ryanstevensmith/SR-Kicad-lib/README.md

# SR-Kicad-lib
 Smith Robotics Kicad Libraries

 Open for use by anyone, but note I am doing it for my own projects and to my own speciication. Parts mostly have not been reviewed externally so use at your own risk. But let's face it, they are probably mostly right.

**Currently at v0.0.2**
