ryanstevensmith/SR-Kicad-lib/3D/LED/ASMT-YTB7-0AA02.STEP

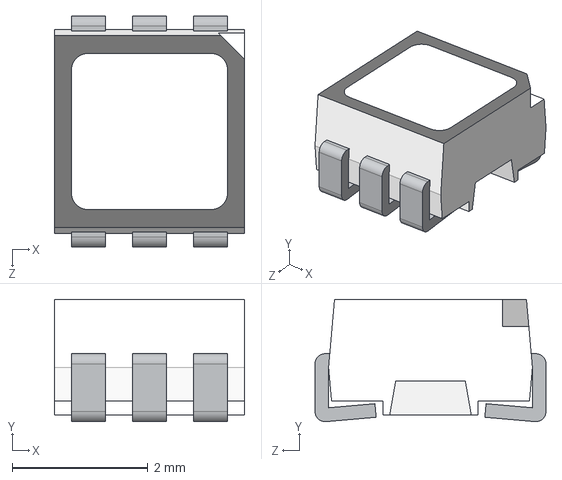
[picture p2: CAD file, 2024-06-04]
3D/LED/ASMT-YTB7-0AA02.STEP
2.80 x 1.80 x 3.40 mm
