ryanstevensmith/SR-Kicad-lib/3D/Battery/MYOUNG-MY-1220-03.step

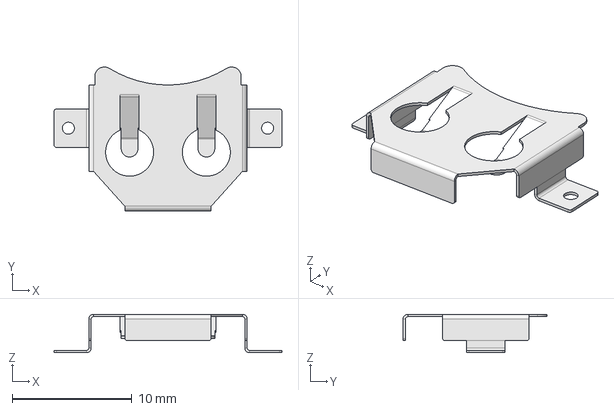
[picture p3: CAD file, 2026-04-07]
3D/Battery/MYOUNG-MY-1220-03.step
19.0 x 12.0 x 3.20 mm
