ryanstevensmith/SR-Kicad-lib/3D/Button_Switch/RB141C1100.STEP

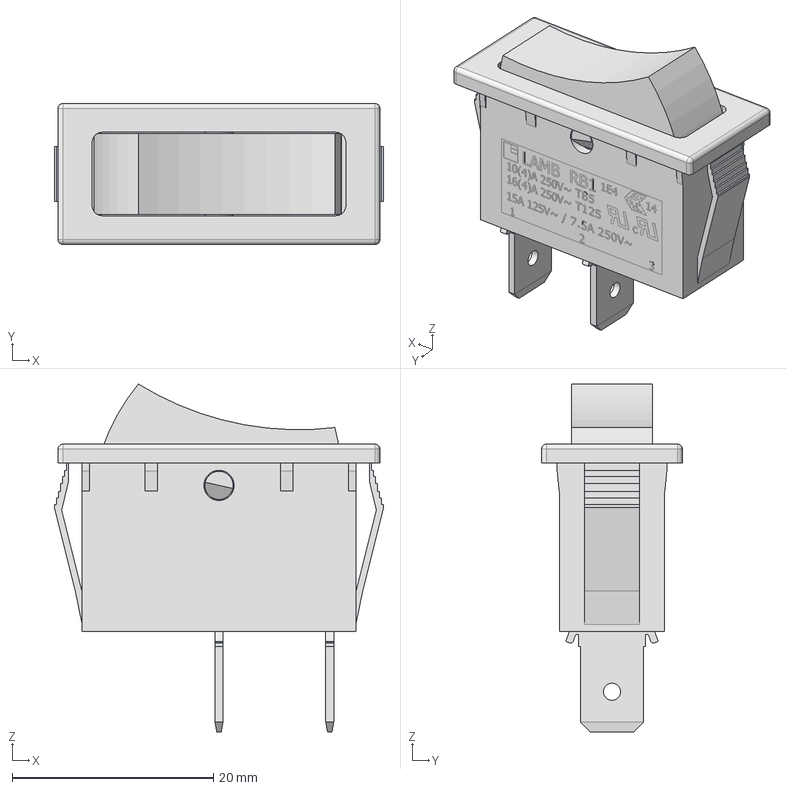
[picture p4: CAD file, 2026-04-07]
3D/Button_Switch/RB141C1100.STEP
32.7 x 14.0 x 34.6 mm
