ryanstevensmith/SR-Kicad-lib/3D/Converter_ACDC/HLK-PM01.step

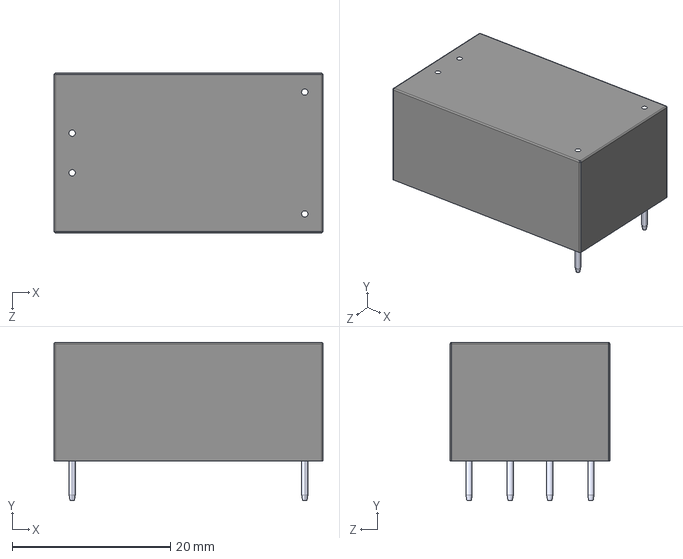
[picture p5: CAD file, 2026-04-07]
3D/Converter_ACDC/HLK-PM01.step
34.0 x 20.0 x 20.2 mm
