ryanstevensmith/SR-Kicad-lib/3D/Converter_DCDC/TEL_10-4811.step

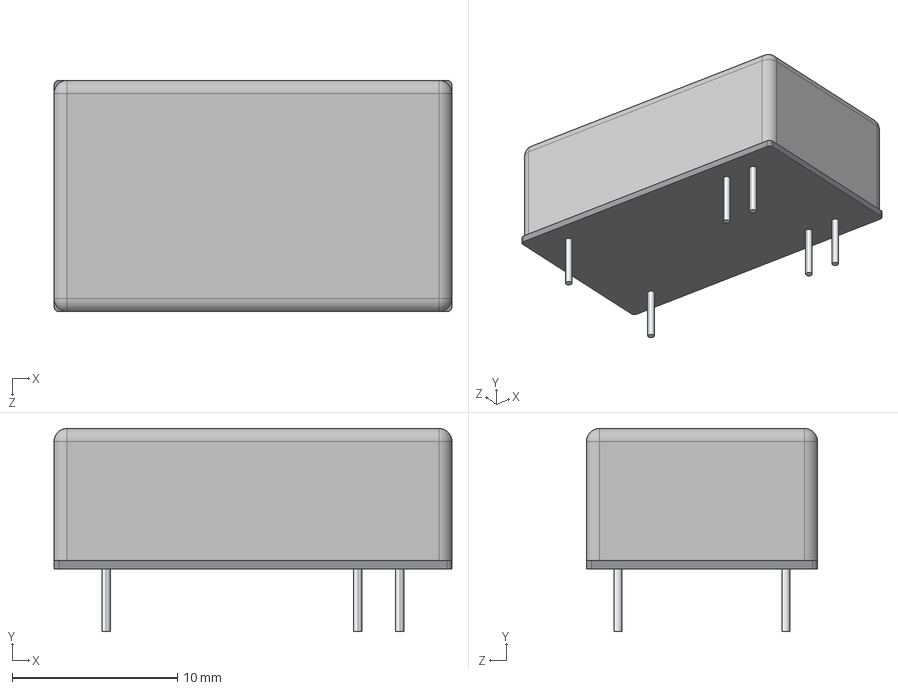
[picture p6: CAD file, 2023-04-03]
3D/Converter_DCDC/TEL_10-4811.step
24.1 x 12.3 x 14.0 mm
tel10-base
tel10wi-cover
tel10wi-pin x 6
