ryanstevensmith/SR-Kicad-lib/3D/Crystal/crystal_rtf2012.stp

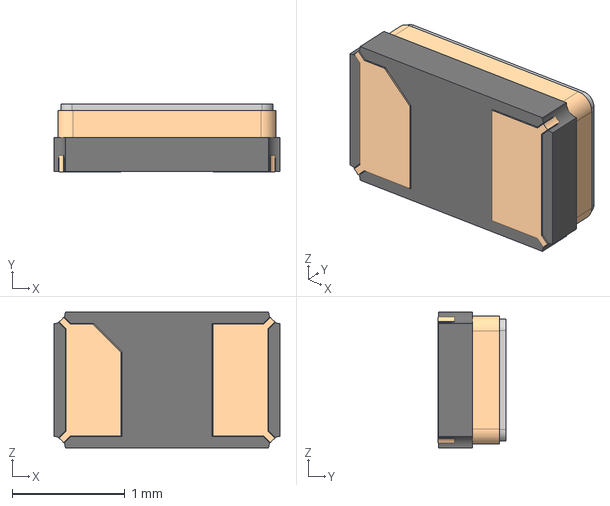
[picture p7: CAD file, 2026-04-07]
3D/Crystal/crystal_rtf2012.stp
2.00 x 0.606 x 1.20 mm
