ryanstevensmith/SR-Kicad-lib/3D/Diode/UCLAMP2671P.TNT.step

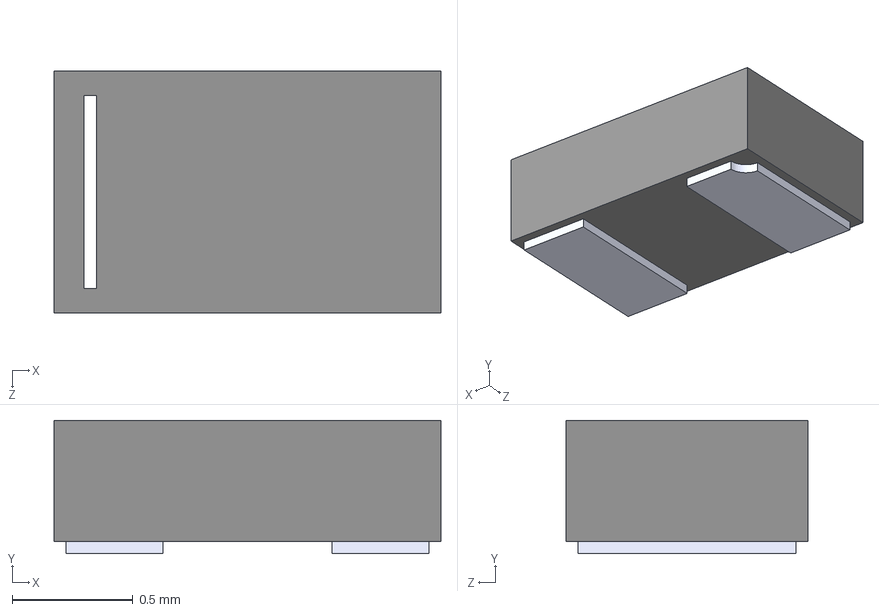
[picture p8: CAD file, 2026-04-07]
3D/Diode/UCLAMP2671P.TNT.step
1.60 x 0.55 x 1.00 mm
