ryanstevensmith/SR-Kicad-lib/3D/Fuse/Littelfuse 0154.500DRT.step

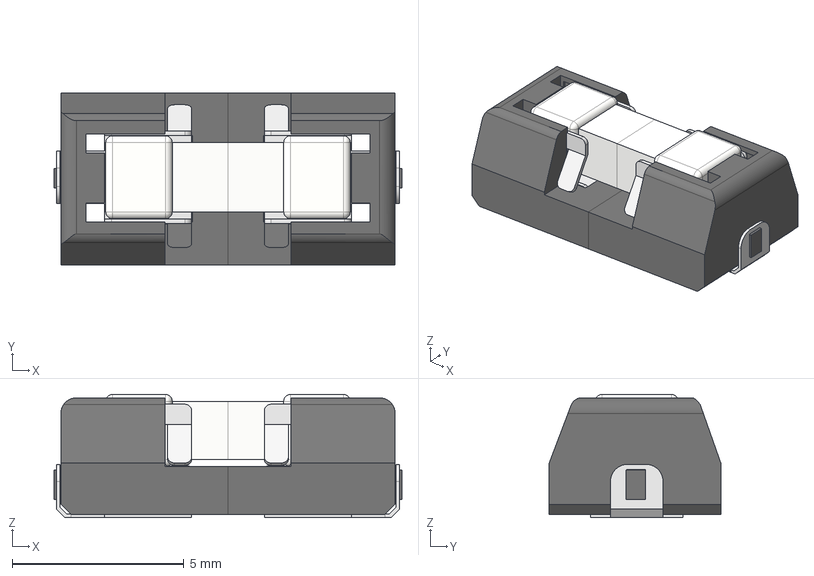
[picture p9: CAD file, 2023-04-03]
3D/Fuse/Littelfuse 0154.500DRT.step
10.1 x 5.00 x 3.59 mm
Komponente1
Komponente2
Komponente3
Komponente4
