ryanstevensmith/SR-Kicad-lib/3D/GPS/SAM-M8Q.STEP

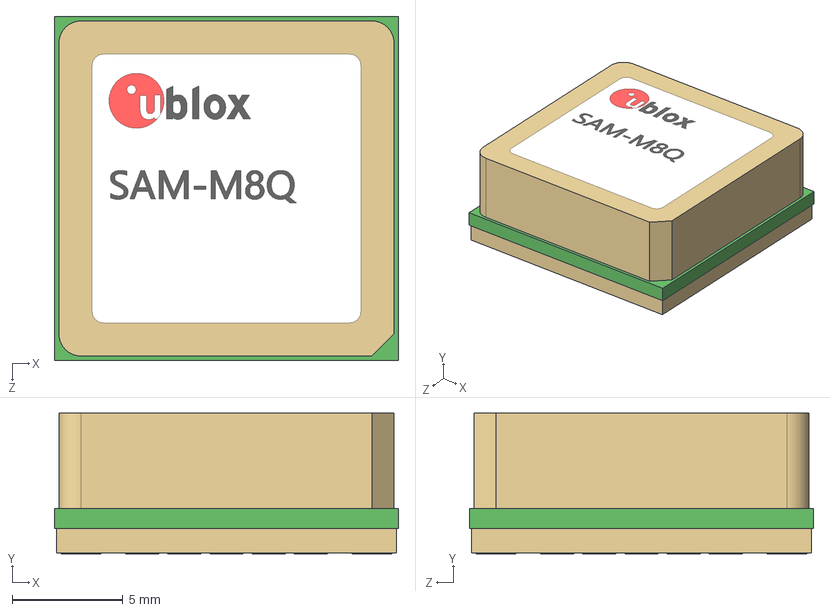
[picture p10: CAD file, 2024-06-04]
3D/GPS/SAM-M8Q.STEP
15.5 x 6.35 x 15.5 mm
