ryanstevensmith/SR-Kicad-lib/3D/GSM/SARA-R4.step

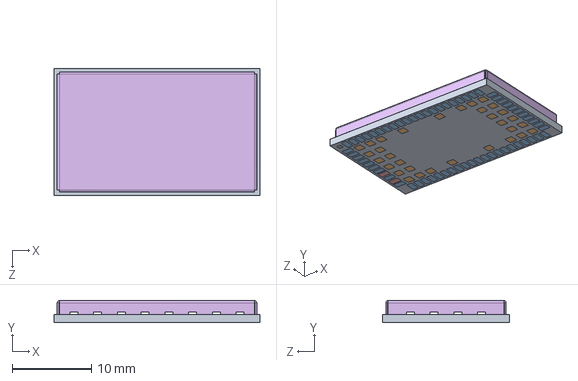
[picture p11: CAD file, 2023-04-03]
3D/GSM/SARA-R4.step
26.0 x 2.78 x 16.0 mm
