ryanstevensmith/SR-Kicad-lib/3D/Inductor/IHLP-2020.stp

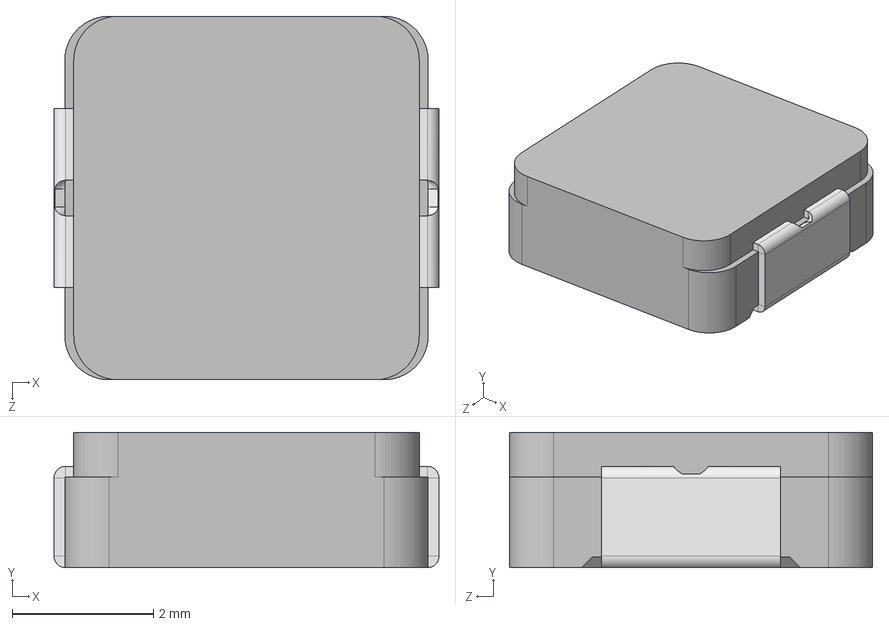
[picture p12: CAD file, 2026-04-07]
3D/Inductor/IHLP-2020.stp
5.45 x 1.92 x 5.15 mm
