ryanstevensmith/SR-Kicad-lib/3D/LED/LED_SK6812MINI-E.step

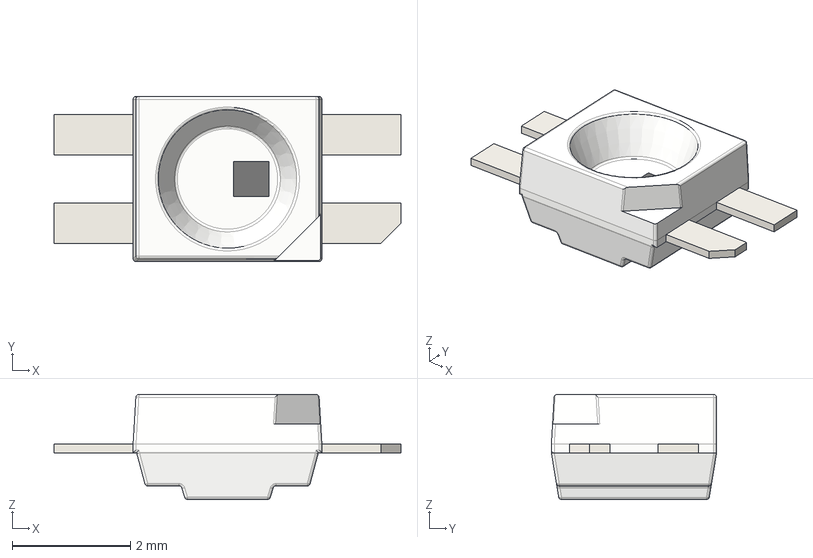
[picture p13: CAD file, 2026-04-07]
3D/LED/LED_SK6812MINI-E.step
5.88 x 2.80 x 1.78 mm
