ryanstevensmith/SR-Kicad-lib/3D/Modules/FIT0982-Thin-Heatsink.step

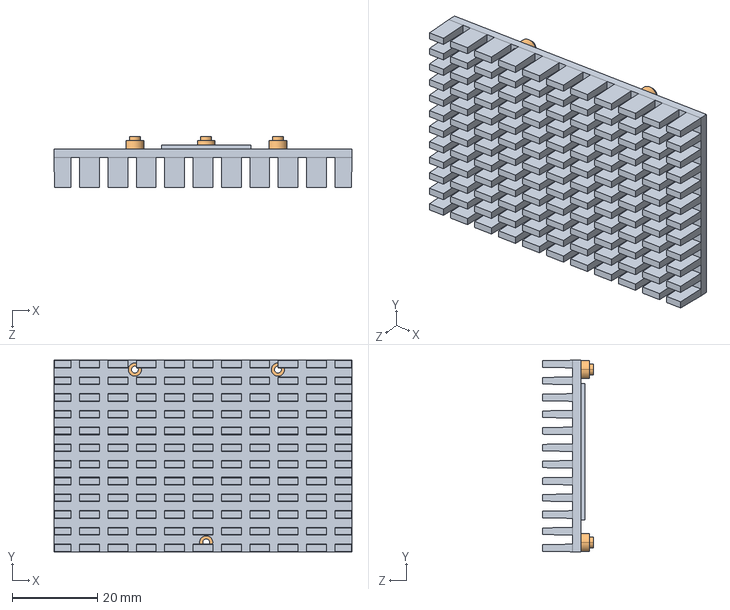
[picture p14: CAD file, 2026-04-07]
3D/Modules/FIT0982-Thin-Heatsink.step
70.0 x 45.0 x 12.0 mm
