ryanstevensmith/SR-Kicad-lib/3D/Package_BGA/DSBGA8-YBG_TEX.step

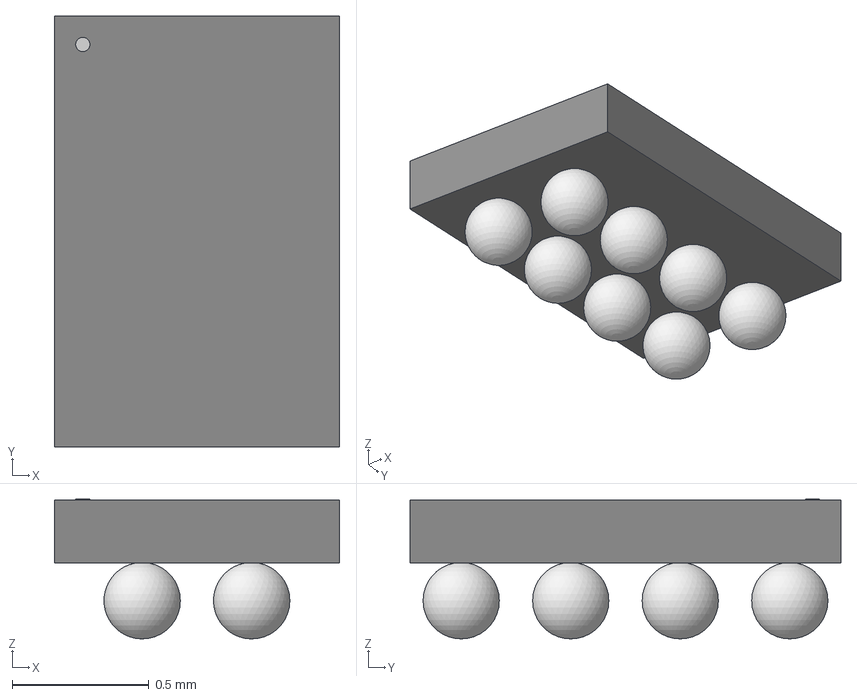
[picture p15: CAD file, 2024-06-04]
3D/Package_BGA/DSBGA8-YBG_TEX.step
1.04 x 1.57 x 0.511 mm
