ryanstevensmith/SR-Kicad-lib/3D/Package_DFN_QFN/ST-DFN-8(2x3).step

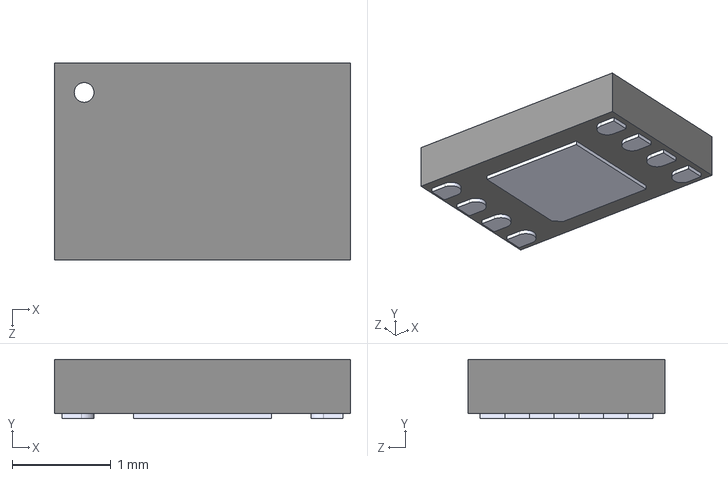
[picture p16: CAD file, 2026-04-07]
3D/Package_DFN_QFN/ST-DFN-8(2x3).step
3.00 x 0.6 x 2.00 mm
