ryanstevensmith/SR-Kicad-lib/3D/Package_LGA/ST_LGA-12_2x2.step

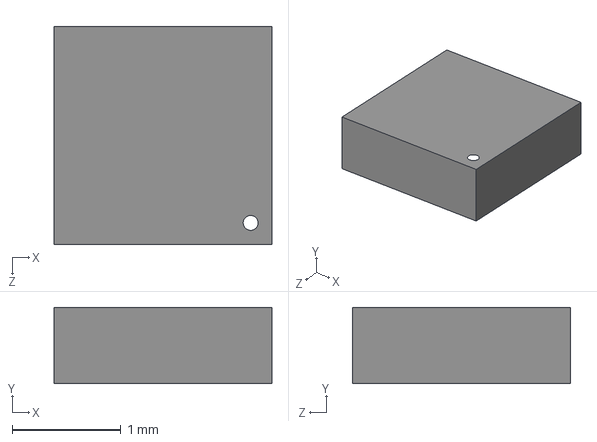
[picture p17: CAD file, 2024-06-04]
3D/Package_LGA/ST_LGA-12_2x2.step
2.00 x 0.7 x 2.00 mm
