ryanstevensmith/SR-Kicad-lib/3D/Package_SiP/MICROSIP8_SIU_TEX.step

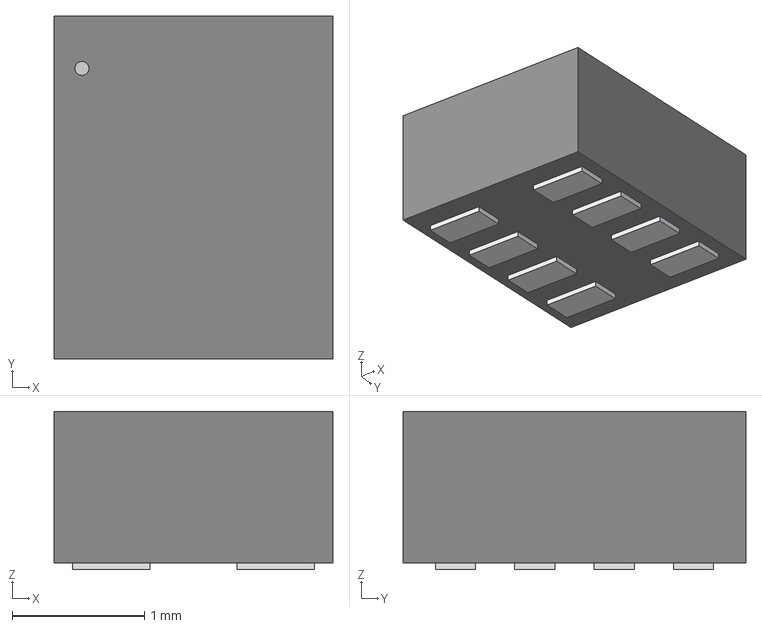
[picture p18: CAD file, 2024-06-04]
3D/Package_SiP/MICROSIP8_SIU_TEX.step
2.11 x 2.59 x 1.20 mm
