ryanstevensmith/SR-Kicad-lib/3D/Package_SO/TSSOP-16 5_1x4_4.STEP

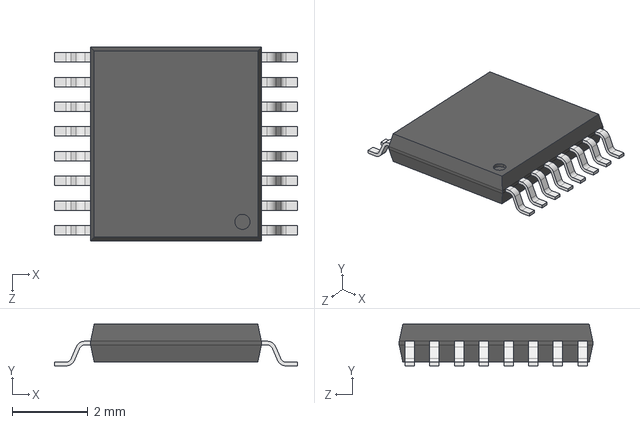
[picture p19: CAD file, 2023-04-03]
3D/Package_SO/TSSOP-16 5_1x4_4.STEP
6.40 x 1.10 x 5.10 mm
pin_TSSOP_tssop_1 x 16
body_TSSOP_TSSOP_5.1x4.5_1
