ryanstevensmith/SR-Kicad-lib/3D/Package_SON/Texas_DPY0002A_X1SON-2.STEP

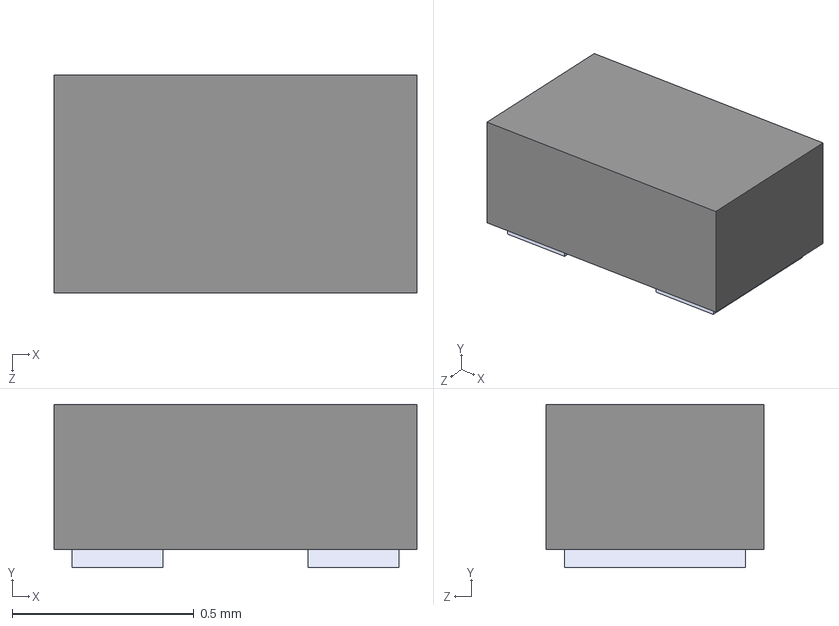
[picture p20: CAD file, 2026-04-07]
3D/Package_SON/Texas_DPY0002A_X1SON-2.STEP
1.00 x 0.45 x 0.6 mm
