ryanstevensmith/SR-Kicad-lib/3D/Package_SOT/TO-39.step

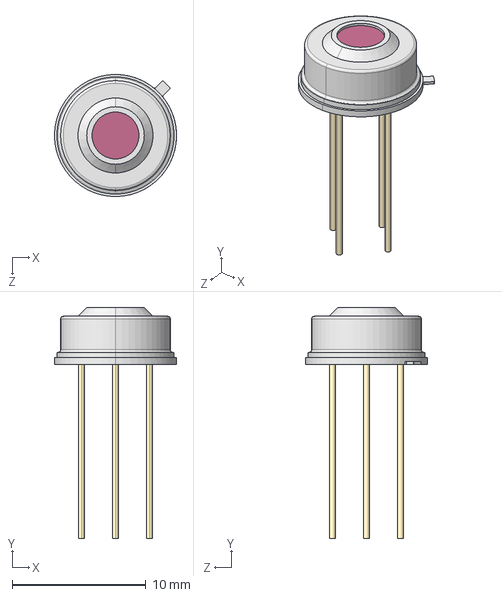
[picture p21: CAD file, 2024-06-04]
3D/Package_SOT/TO-39.step
9.12 x 17.2 x 9.12 mm
