ryanstevensmith/SR-Kicad-lib/3D/Rotary_Encoder/PEC11R-4x15F-Nxxxx.step

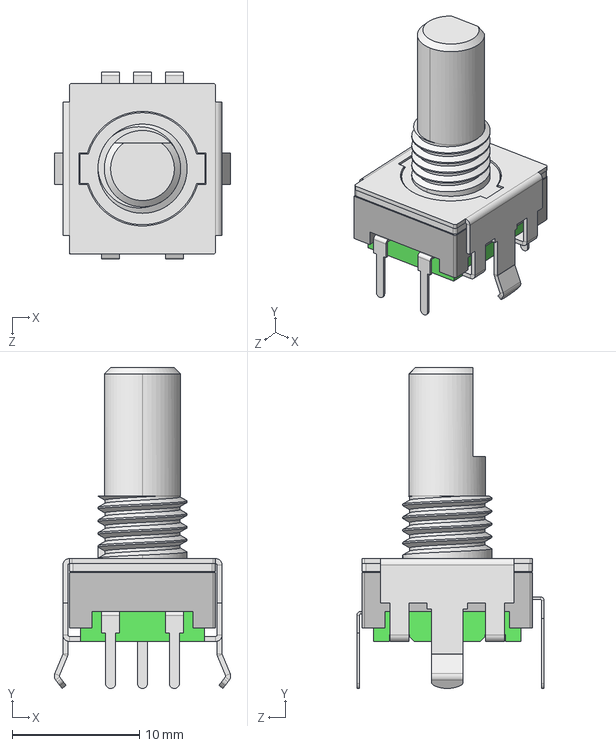
[picture p23: CAD file, 2023-08-29]
3D/Rotary_Encoder/PEC11R-4x15F-Nxxxx.step
13.9 x 25.2 x 14.7 mm
