ryanstevensmith/SR-Kicad-lib/3D/Sensor_Audio/SPV0142LR5H.step

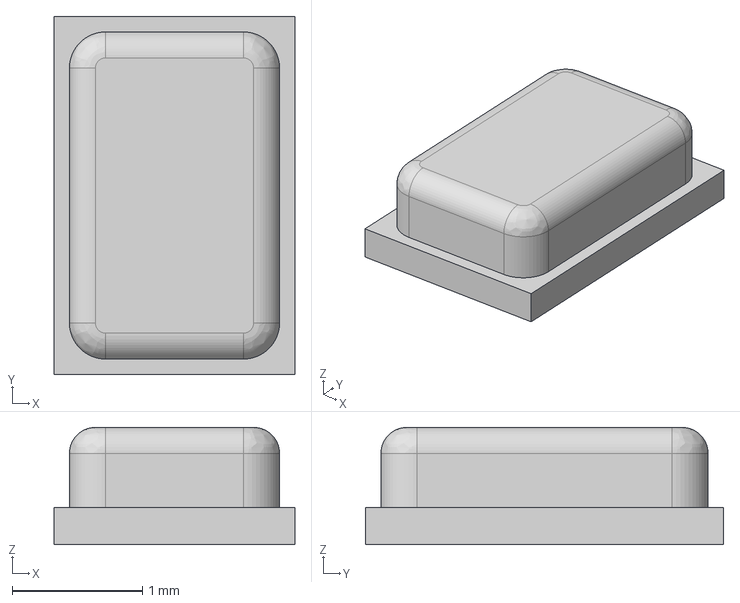
[picture p24: CAD file, 2026-04-07]
3D/Sensor_Audio/SPV0142LR5H.step
1.85 x 2.75 x 0.9 mm
