ryanstevensmith/SR-Kicad-lib/3D/Sensor_Gas/AHT20.step

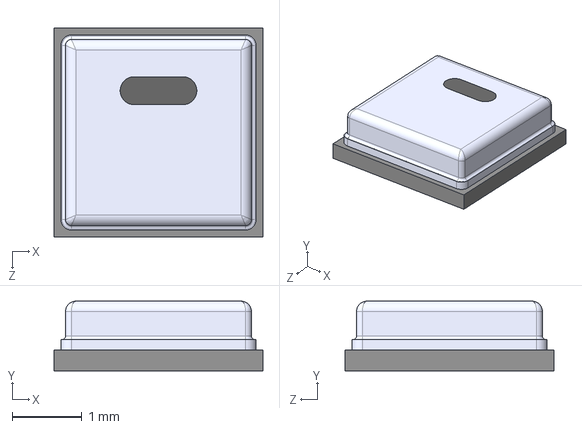
[picture p25: CAD file, 2026-04-07]
3D/Sensor_Gas/AHT20.step
3.00 x 1.00 x 3.00 mm
