ryanstevensmith/SR-Kicad-lib/3D/Sensor_Opto/BH1750FVI-TR.step

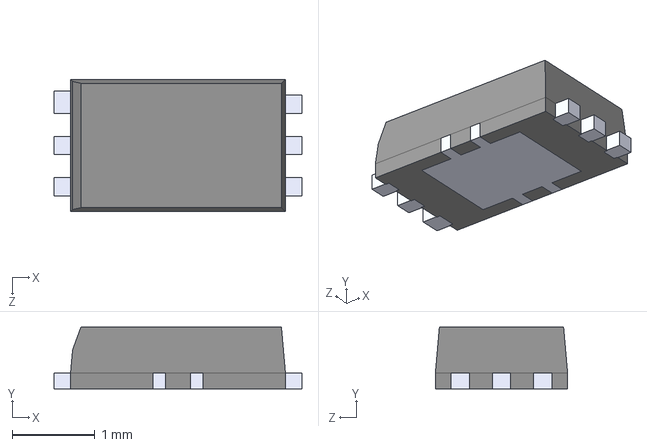
[picture p26: CAD file, 2026-04-07]
3D/Sensor_Opto/BH1750FVI-TR.step
3.00 x 0.75 x 1.60 mm
