ryanstevensmith/SR-Kicad-lib/3D/Solar_Cell/KXOB25-02X8F-TR.step

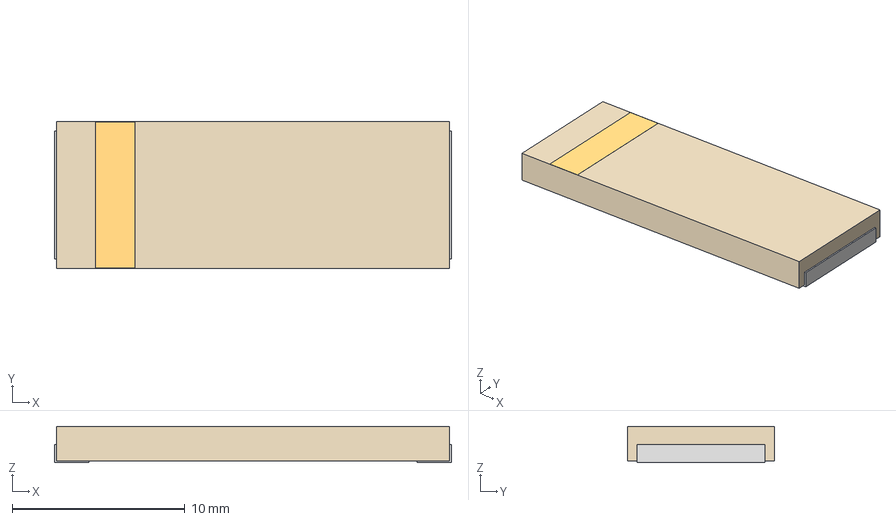
[picture p27: CAD file, 2023-08-29]
3D/Solar_Cell/KXOB25-02X8F-TR.step
23.0 x 8.51 x 2.11 mm
