ryanstevensmith/SR-Kicad-lib/3D/Button_Switch/sk-3296s-01-l3.step

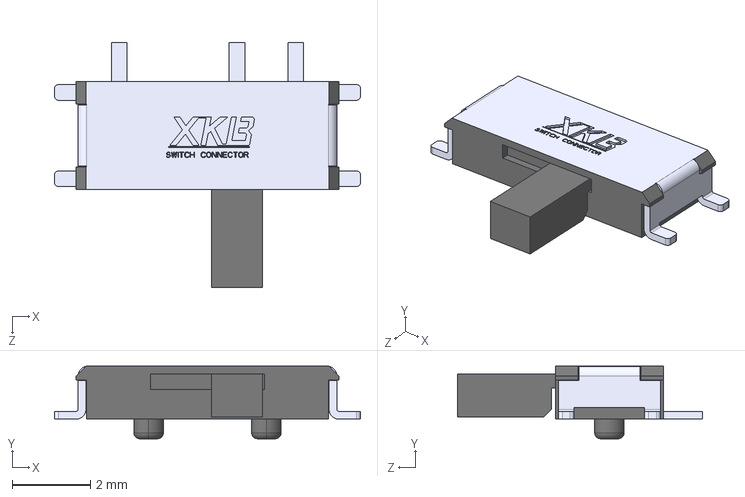
[picture p28: CAD file, 2026-04-07]
3D/Button_Switch/sk-3296s-01-l3.step
7.80 x 1.85 x 6.25 mm
