ryanstevensmith/SR-Kicad-lib/3D/Connectors/UE27-BC54-130.step

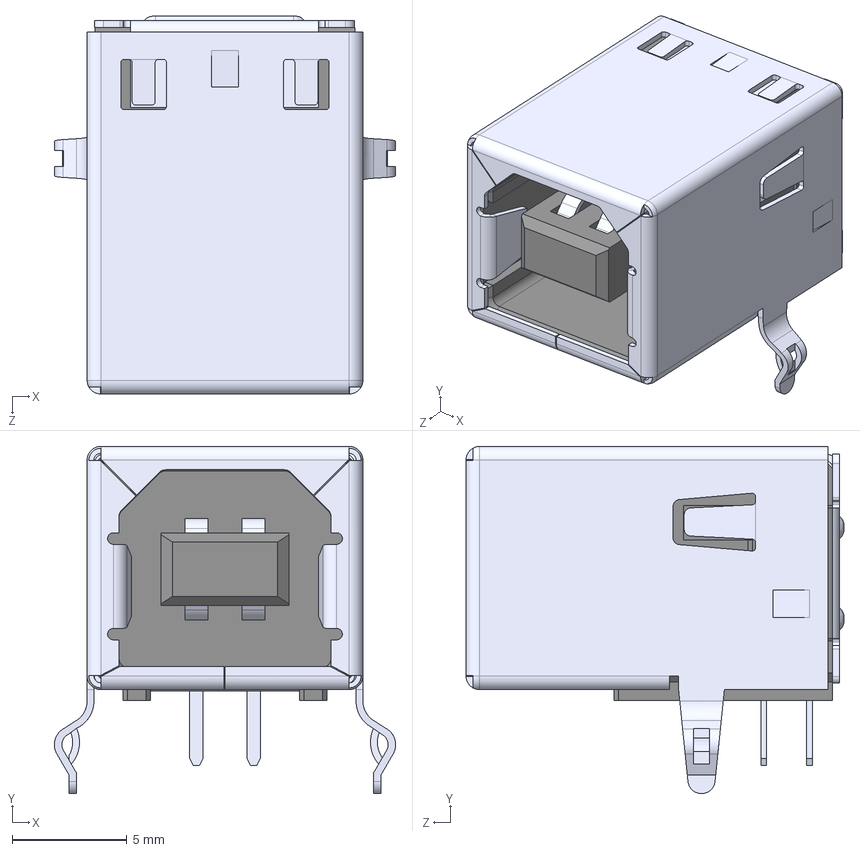
[picture p29: CAD file, 2026-04-07]
3D/Connectors/UE27-BC54-130.step
14.9 x 15.2 x 16.5 mm
