ryanstevensmith/SR-Kicad-lib/3D/Converter_DCDC/IZB03.STEP

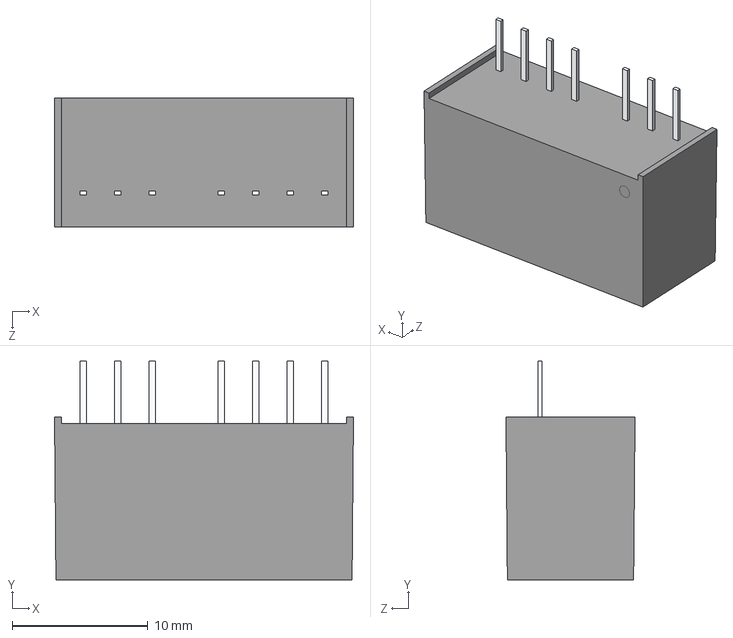
[picture p30: CAD file, 2023-04-03]
3D/Converter_DCDC/IZB03.STEP
22.0 x 16.1 x 9.50 mm
PIN_3_1_1_1 x 7
