ryanstevensmith/SR-Kicad-lib/3D/Crystal/Crystal SC32S no markings.stp

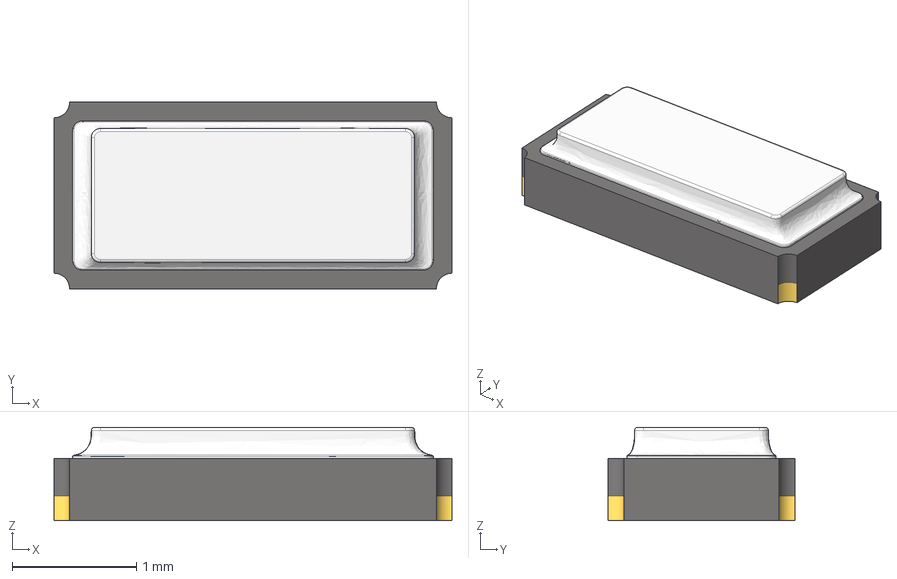
[picture p31: CAD file, 2023-08-29]
3D/Crystal/Crystal SC32S no markings.stp
3.20 x 1.50 x 0.75 mm
