ryanstevensmith/SR-Kicad-lib/3D/Diode/TUMD2M.step

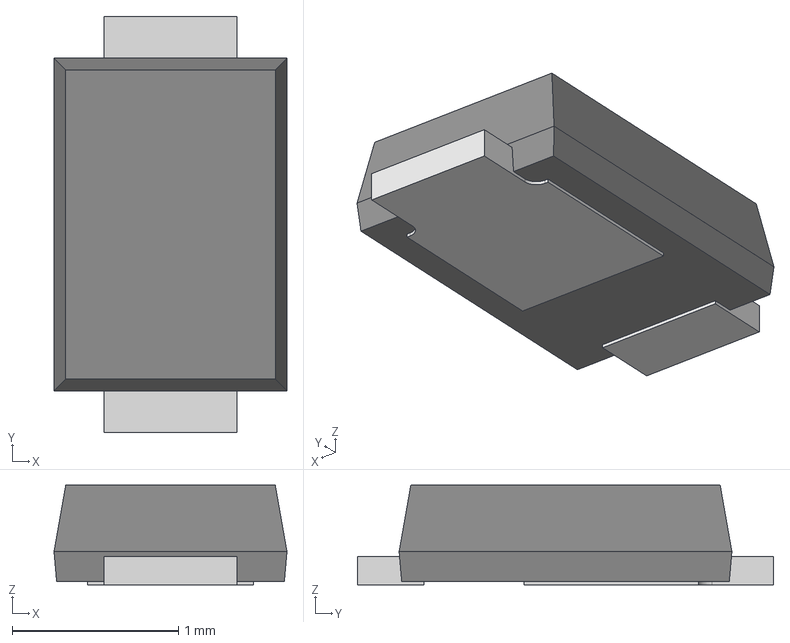
[picture p32: CAD file, 2023-08-29]
3D/Diode/TUMD2M.step
1.40 x 2.50 x 0.6 mm
3D_Model_TUMD2M_Rev0-prt0
3D_Model_TUMD2M_Rev0-prt1
3D_Model_TUMD2M_Rev0-prt2
3D_Model_TUMD2M_Rev0-prt3
