ryanstevensmith/SR-Kicad-lib/3D/GPS/ublox_MAX.STEP

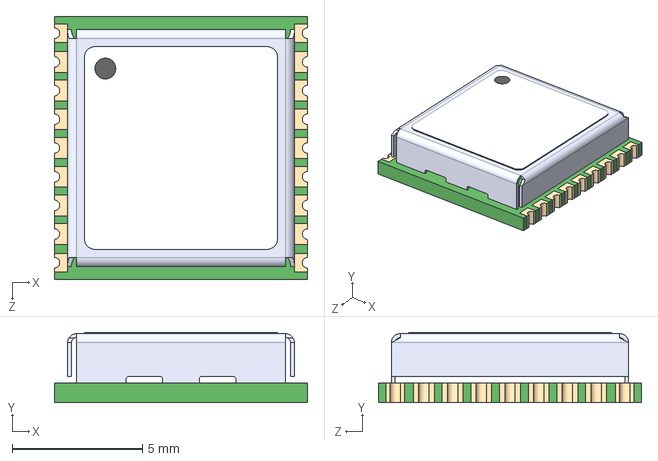
[picture p33: CAD file, 2023-08-29]
3D/GPS/ublox_MAX.STEP
9.70 x 2.70 x 10.1 mm
