ryanstevensmith/SR-Kicad-lib/3D/GSM/SIM800C.step

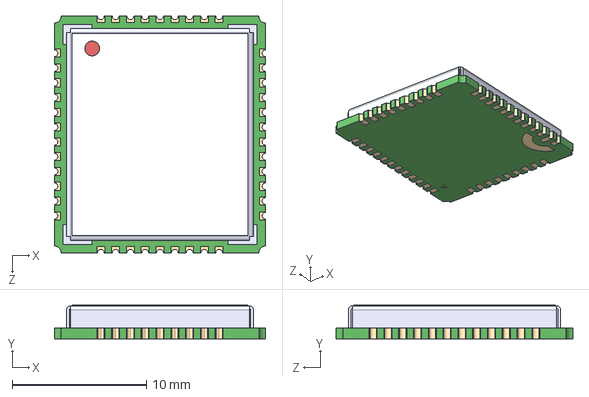
[picture p34: CAD file, 2023-04-03]
3D/GSM/SIM800C.step
15.7 x 2.50 x 17.6 mm
