ryanstevensmith/SR-Kicad-lib/3D/LED/XZxxxx45S-9.step

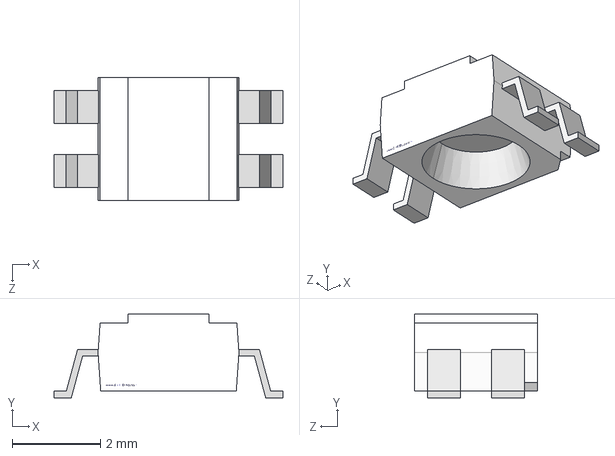
[picture p35: CAD file, 2026-04-07]
3D/LED/XZxxxx45S-9.step
5.20 x 1.90 x 2.80 mm
