ryanstevensmith/SR-Kicad-lib/3D/Modules/FIT0989-Fanless-Heatsink.step

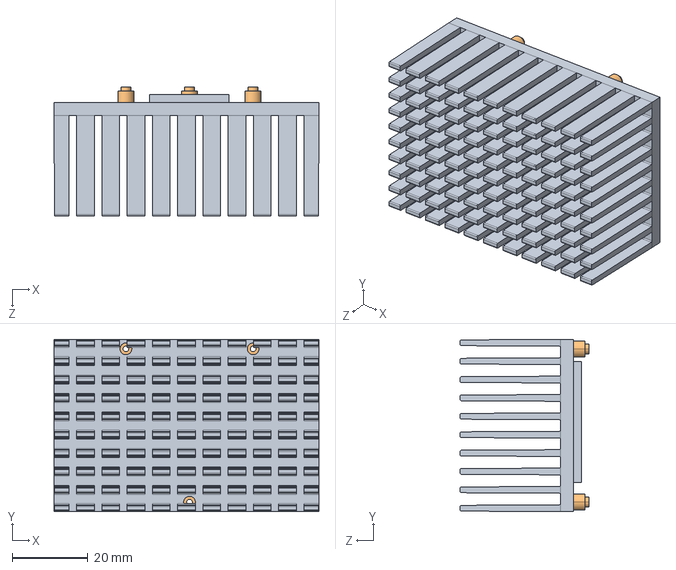
[picture p36: CAD file, 2026-04-07]
3D/Modules/FIT0989-Fanless-Heatsink.step
70.0 x 45.5 x 34.0 mm
