ryanstevensmith/SR-Kicad-lib/3D/Package_BGA/YZF0009-C01.stp

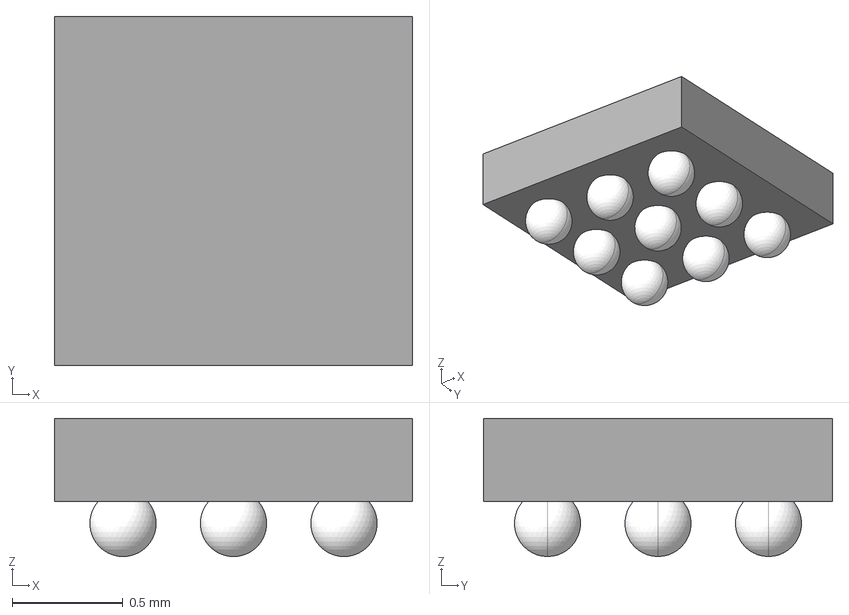
[picture p37: CAD file, 2024-06-04]
3D/Package_BGA/YZF0009-C01.stp
1.62 x 1.58 x 0.625 mm
SOLDER_BALL x 9
PIN1_AREA
