ryanstevensmith/SR-Kicad-lib/3D/Package_DFN_QFN/Texas_RDX0007A_QFN-FCMOD.step

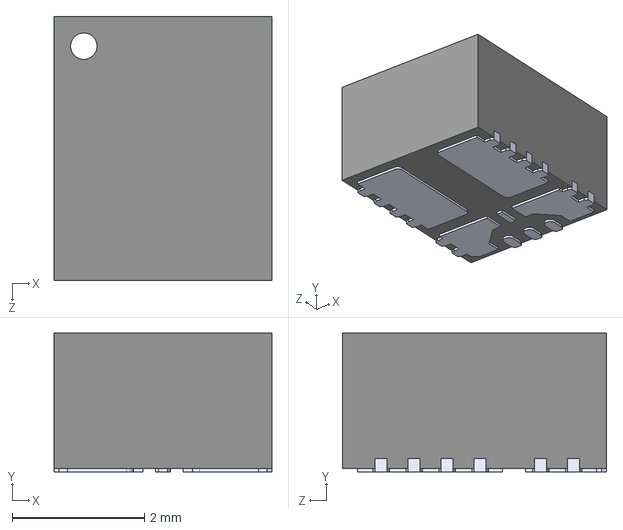
[picture p38: CAD file, 2026-04-07]
3D/Package_DFN_QFN/Texas_RDX0007A_QFN-FCMOD.step
3.30 x 2.10 x 4.00 mm
