ryanstevensmith/SR-Kicad-lib/3D/Package_LGA/ST_LGA-14_2.5x3.step

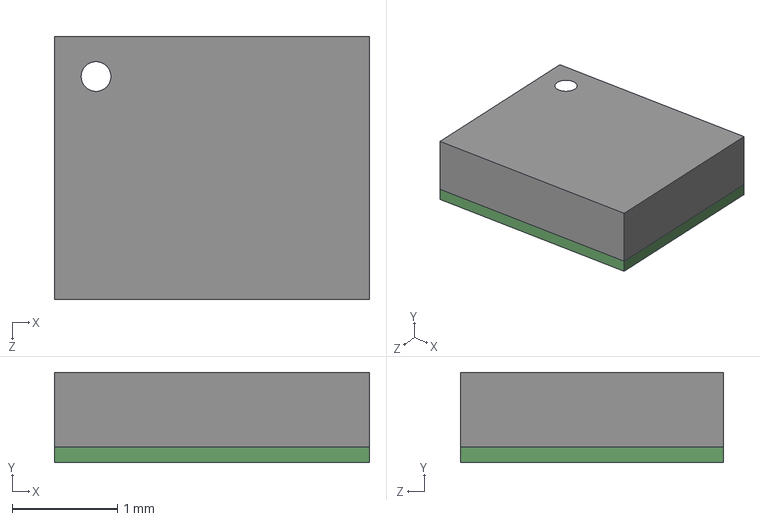
[picture p39: CAD file, 2024-06-04]
3D/Package_LGA/ST_LGA-14_2.5x3.step
3.00 x 0.86 x 2.50 mm
