ryanstevensmith/SR-Kicad-lib/3D/Package_SO/SOIC-8_3.9x4.9mm_P1.27mm.step

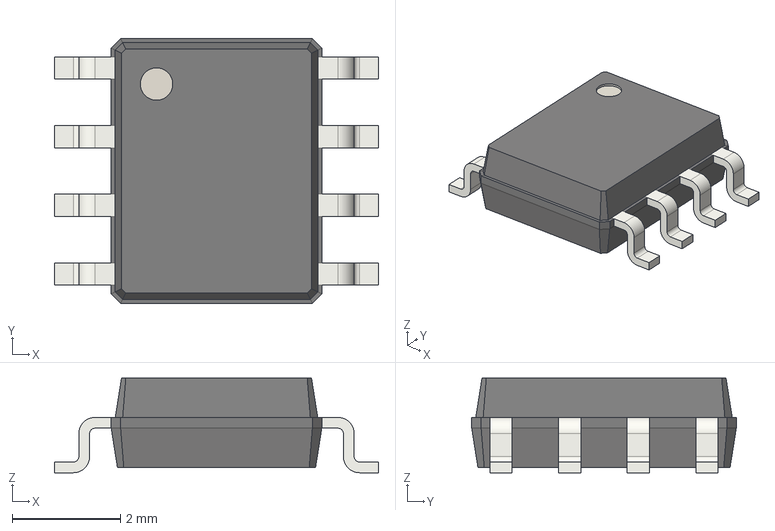
[picture p40: CAD file, 2023-04-03]
3D/Package_SO/SOIC-8_3.9x4.9mm_P1.27mm.step
6.00 x 4.90 x 1.75 mm
