ryanstevensmith/SR-Kicad-lib/3D/Package_SON/ON_SO−8FL_488AA.STEP

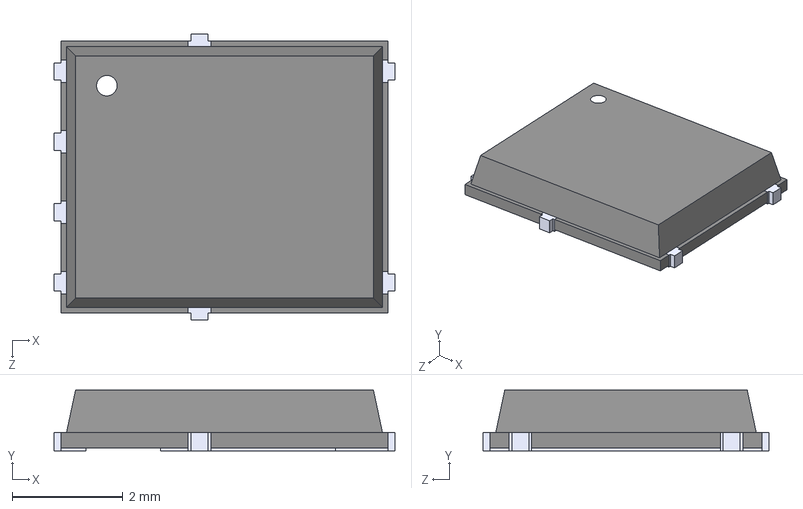
[picture p41: CAD file, 2026-04-07]
3D/Package_SON/ON_SO−8FL_488AA.STEP
6.15 x 1.10 x 5.15 mm
