ryanstevensmith/SR-Kicad-lib/3D/Package_SOT/SOT1061.STEP

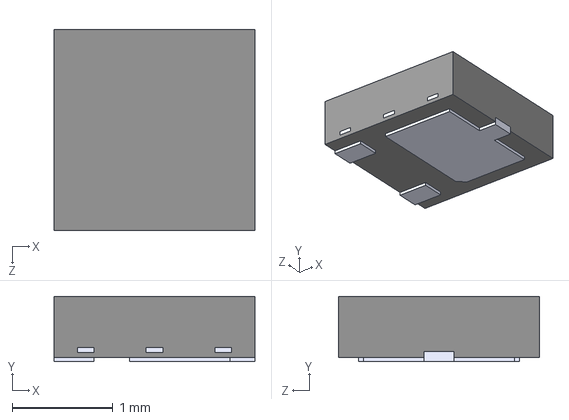
[picture p42: CAD file, 2023-08-29]
3D/Package_SOT/SOT1061.STEP
2.00 x 0.65 x 2.00 mm
