ryanstevensmith/SR-Kicad-lib/3D/RF_Module/BC65.step

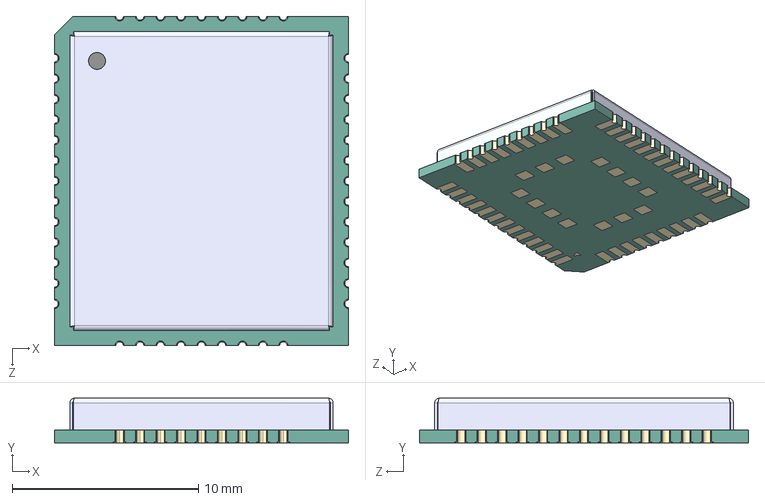
[picture p43: CAD file, 2026-04-07]
3D/RF_Module/BC65.step
15.8 x 2.40 x 17.7 mm
