ryanstevensmith/SR-Kicad-lib/3D/Sensor_Audio/SPU0410LR5H-QB.step

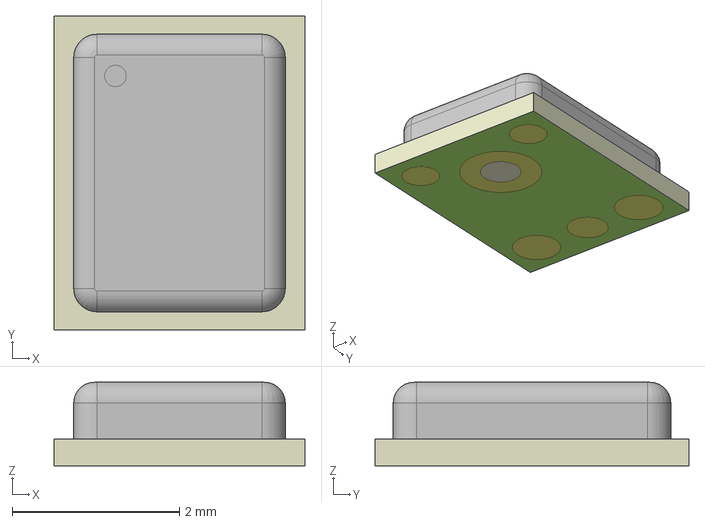
[picture p44: CAD file, 2024-06-04]
3D/Sensor_Audio/SPU0410LR5H-QB.step
3.00 x 3.76 x 1.00 mm
