ryanstevensmith/SR-Kicad-lib/3D/Sensor_Gas/MPXV7002DP.step

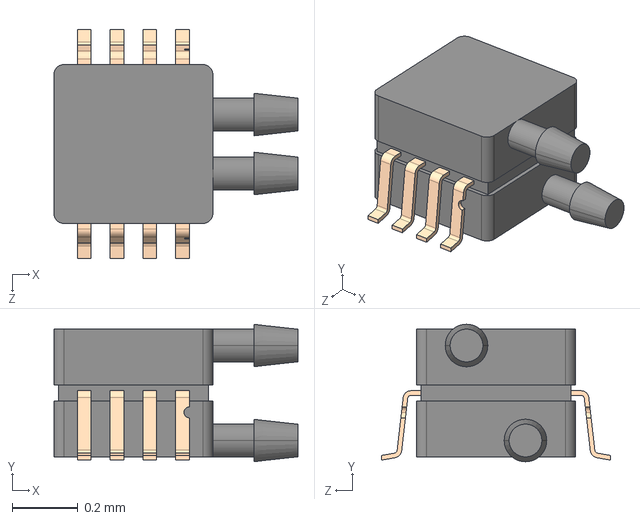
[picture p45: CAD file, 2026-04-07]
3D/Sensor_Gas/MPXV7002DP.step
0.745 x 0.42 x 0.7 mm
