ryanstevensmith/SR-Kicad-lib/3D/Sensor_Opto/VEML6030.step

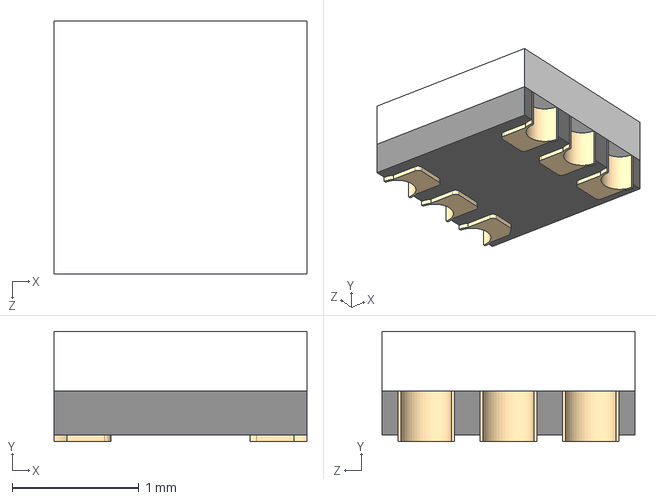
[picture p46: CAD file, 2026-04-07]
3D/Sensor_Opto/VEML6030.step
2.00 x 0.87 x 2.00 mm
