ryanstevensmith/SR-Kicad-lib/CM4/CM4 Library/Raspberry-Pi-CM4-3D-Models/DF40HC(3.0)-100DS-0.4V.stp

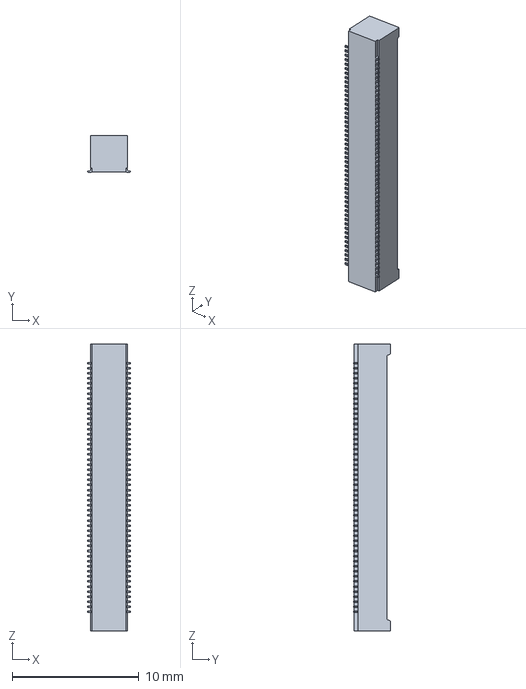
[picture p47: CAD file, 2026-04-07]
CM4/CM4 Library/Raspberry-Pi-CM4-3D-Models/DF40HC(3.0)-100DS-0.4V.stp
3.38 x 2.90 x 22.6 mm
