ryanstevensmith/SR-Kicad-lib/3D/Battery/keystone-PN254TR.STEP

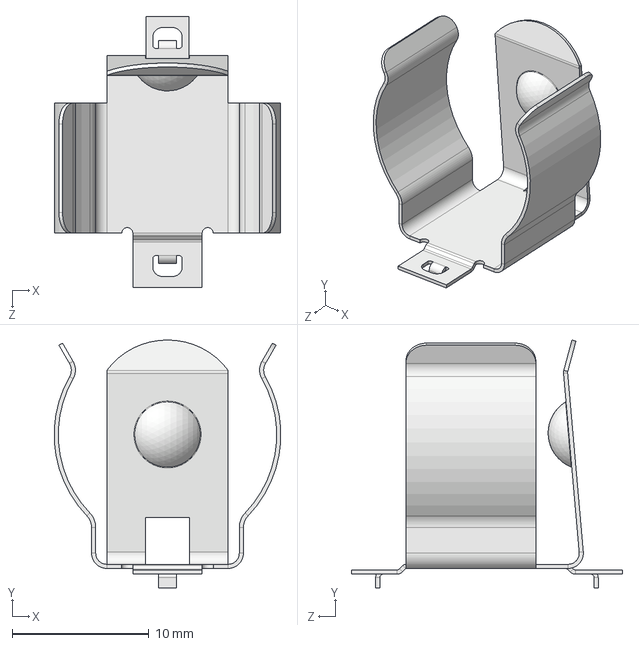
[picture p48: CAD file, 2024-06-04]
3D/Battery/keystone-PN254TR.STEP
16.6 x 18.2 x 19.9 mm
