ryanstevensmith/SR-Kicad-lib/3D/Button_Switch/evqq2d02w.stp

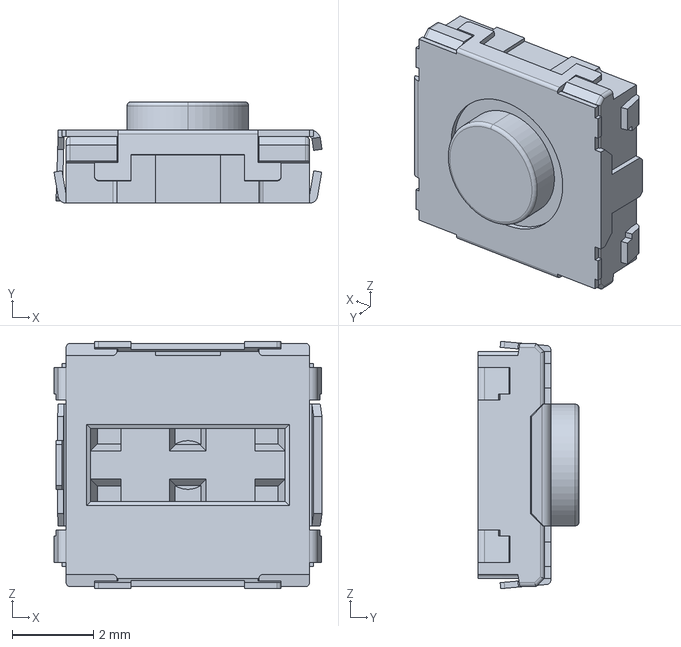
[picture p49: CAD file, 2026-04-07]
3D/Button_Switch/evqq2d02w.stp
6.61 x 2.50 x 6.10 mm
