ryanstevensmith/SR-Kicad-lib/3D/Connectors/2EDGVC-5.08-03P-14-00AH.STEP

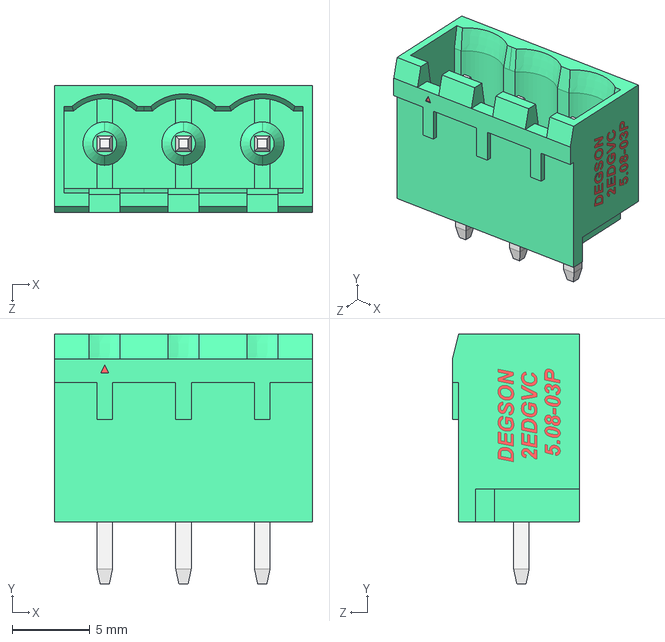
[picture p50: CAD file, 2026-04-07]
3D/Connectors/2EDGVC-5.08-03P-14-00AH.STEP
16.6 x 16.1 x 8.20 mm
