ryanstevensmith/SR-Kicad-lib/3D/Crystal/Crystal_2016.STEP

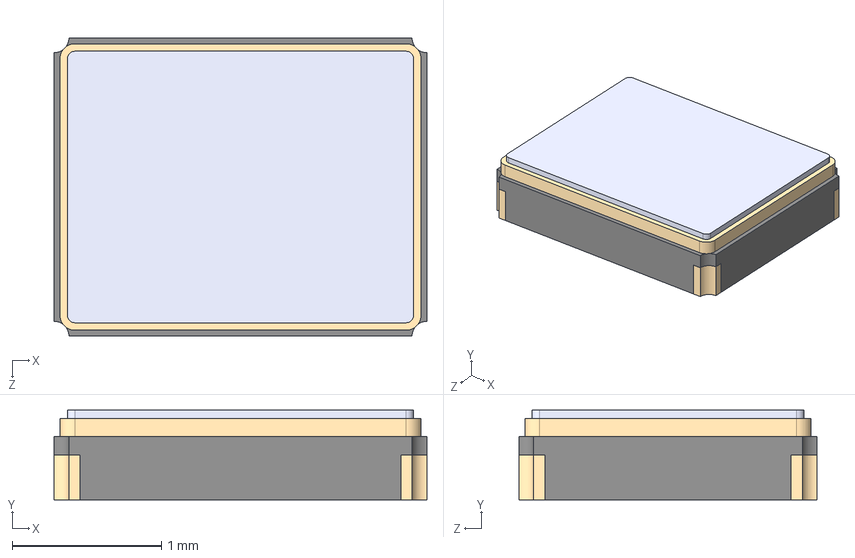
[picture p51: CAD file, 2023-08-29]
3D/Crystal/Crystal_2016.STEP
2.50 x 0.6 x 2.00 mm
