ryanstevensmith/SR-Kicad-lib/3D/Inductor/SRP1245A series.stp

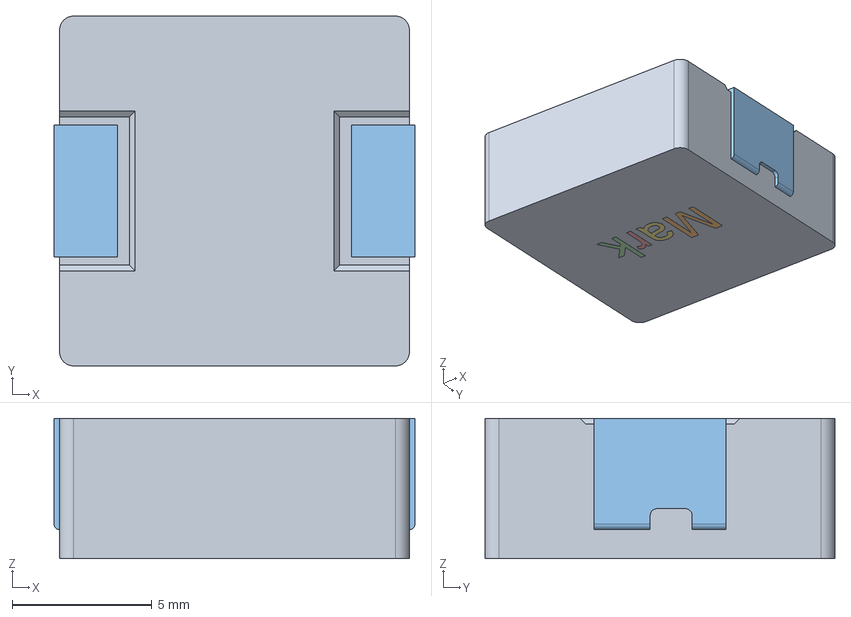
[picture p52: CAD file, 2026-04-07]
3D/Inductor/SRP1245A series.stp
12.9 x 12.5 x 5.00 mm
