ryanstevensmith/SR-Kicad-lib/3D/LED/SK6805-2.4x2.7.step

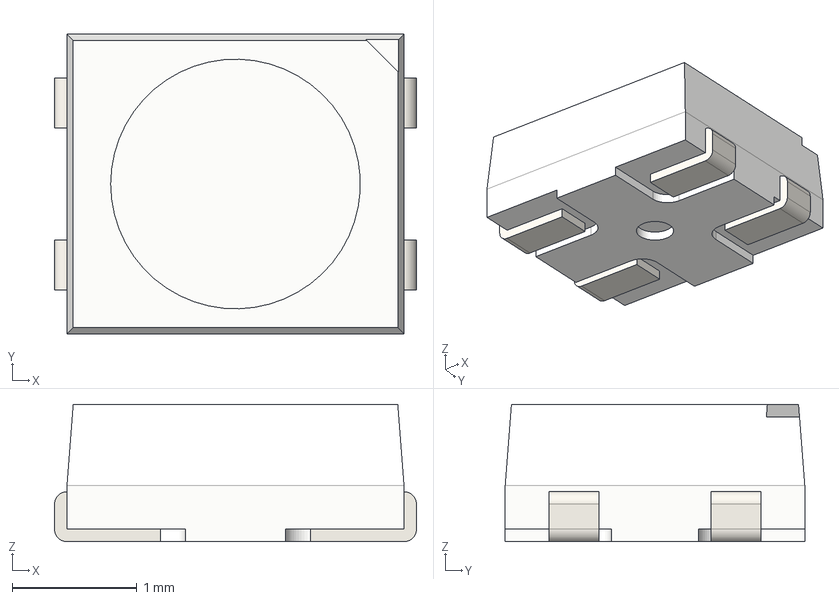
[picture p53: CAD file, 2026-04-07]
3D/LED/SK6805-2.4x2.7.step
2.90 x 2.40 x 1.10 mm
DOUT
DIN
VSS
VDD
