ryanstevensmith/SR-Kicad-lib/3D/Package_DFN_QFN/Texas_RSH56_VQFN56.step

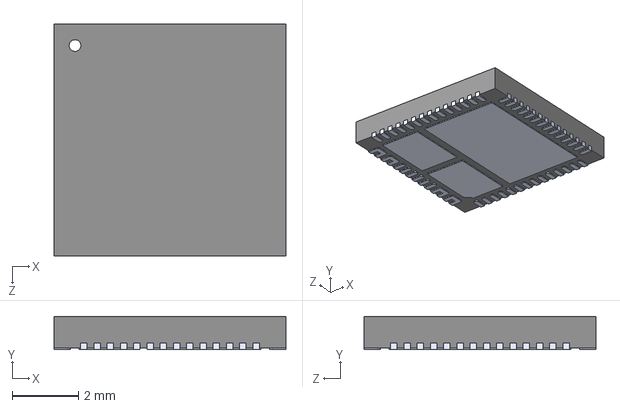
[picture p54: CAD file, 2026-04-07]
3D/Package_DFN_QFN/Texas_RSH56_VQFN56.step
7.00 x 1.00 x 7.00 mm
