ryanstevensmith/SR-Kicad-lib/3D/Package_LGA/AS726X.STEP

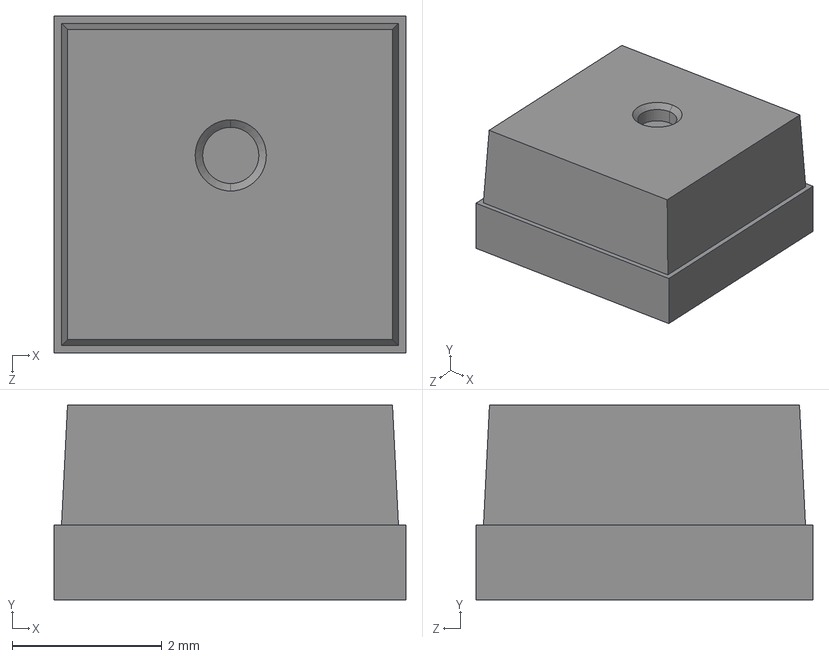
[picture p55: CAD file, 2023-08-29]
3D/Package_LGA/AS726X.STEP
4.70 x 2.60 x 4.50 mm
