ryanstevensmith/SR-Kicad-lib/3D/Package_SON/Texas-DNP0006A-USON.step

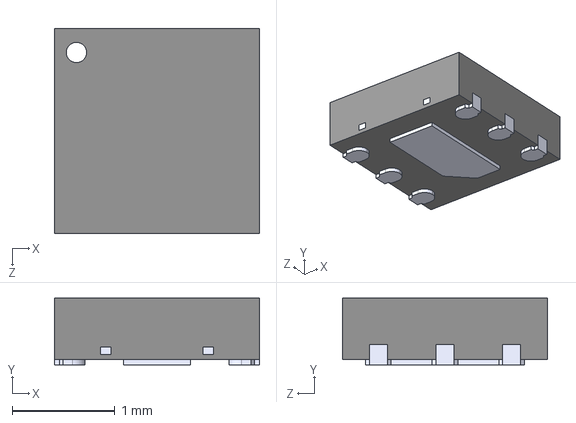
[picture p56: CAD file, 2026-04-07]
3D/Package_SON/Texas-DNP0006A-USON.step
2.00 x 0.65 x 2.00 mm
