ryanstevensmith/SR-Kicad-lib/3D/Package_SOT/TSMT6.stp

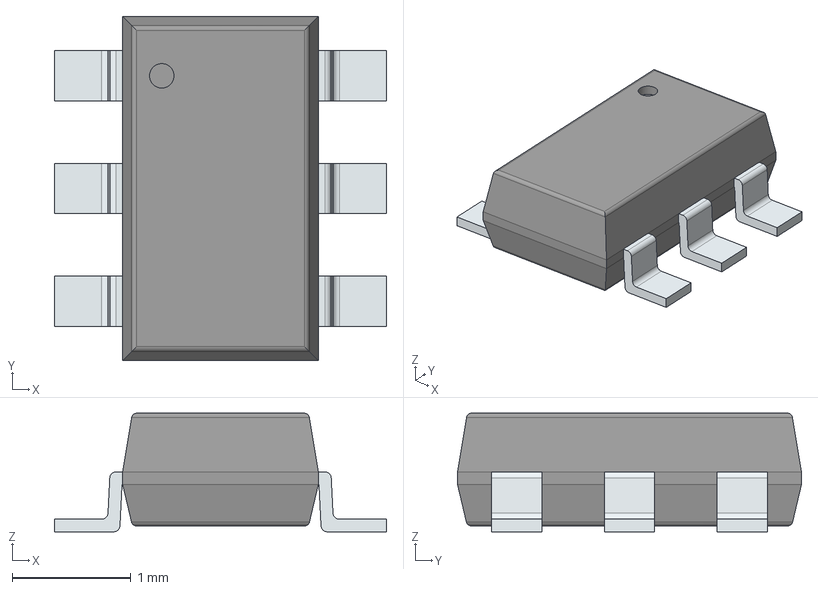
[picture p57: CAD file, 2023-06-09]
3D/Package_SOT/TSMT6.stp
2.80 x 2.90 x 1.00 mm
PinsArrayLR
