ryanstevensmith/SR-Kicad-lib/3D/RF_Module/NINA-W102.step

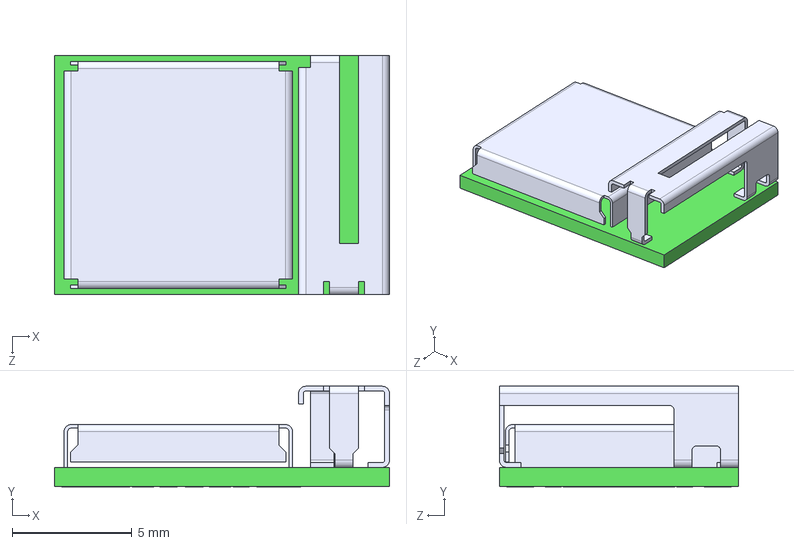
[picture p58: CAD file, 2024-06-04]
3D/RF_Module/NINA-W102.step
14.0 x 4.20 x 10.0 mm
