ryanstevensmith/SR-Kicad-lib/3D/Sensor_Audio/MP34DT01.STEP

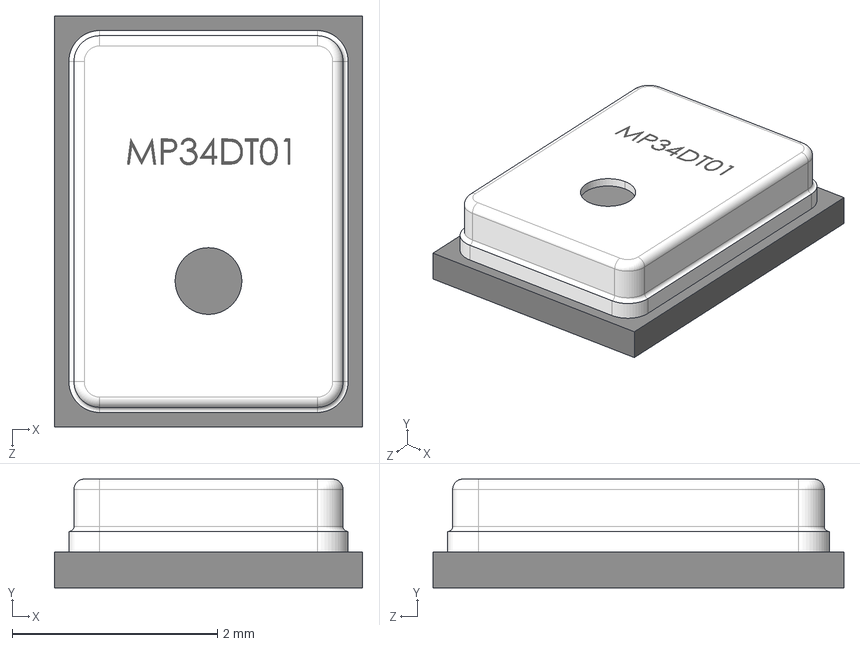
[picture p59: CAD file, 2023-08-29]
3D/Sensor_Audio/MP34DT01.STEP
3.00 x 1.06 x 4.00 mm
