ryanstevensmith/SR-Kicad-lib/3D/Antenna/YC0010AA.step

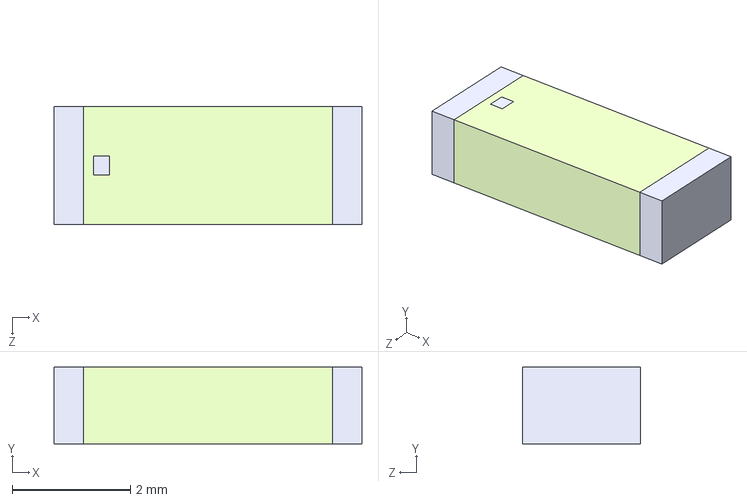
[picture p60: CAD file, 2023-08-29]
3D/Antenna/YC0010AA.step
5.20 x 1.30 x 2.00 mm
