ryanstevensmith/SR-Kicad-lib/3D/Connectors/XT60PW-M.STEP

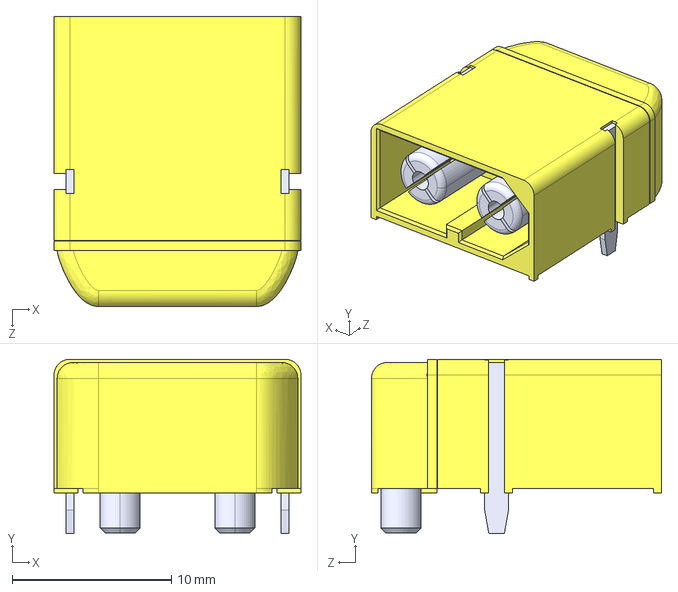
[picture p61: CAD file, 2026-04-07]
3D/Connectors/XT60PW-M.STEP
15.5 x 11.0 x 18.2 mm
