ryanstevensmith/SR-Kicad-lib/3D/Inductor/IND_VCMT063T-MN5_CYN.step

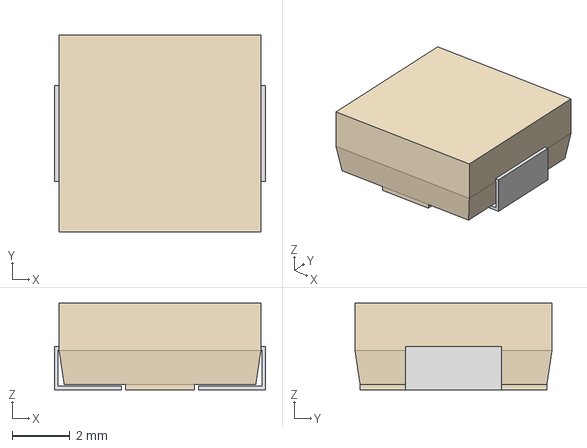
[picture p62: CAD file, 2026-04-07]
3D/Inductor/IND_VCMT063T-MN5_CYN.step
7.29 x 6.81 x 3.00 mm
