ryanstevensmith/SR-Kicad-lib/3D/LED/XZxx45S-9.step

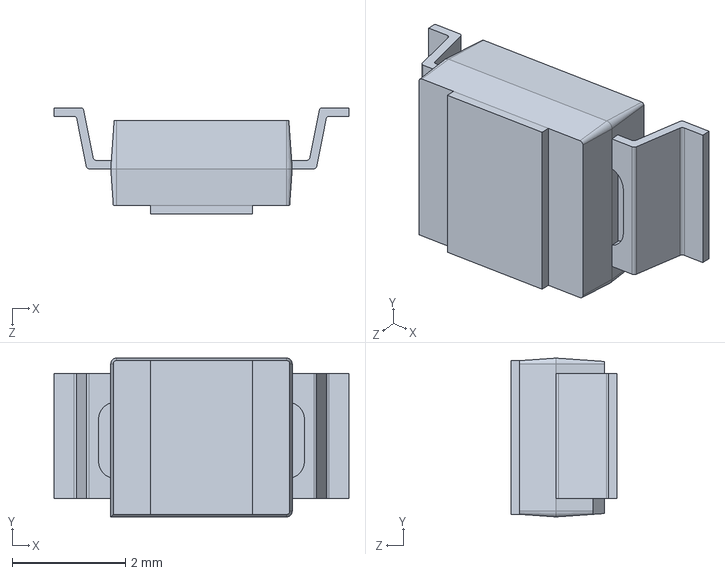
[picture p63: CAD file, 2026-04-07]
3D/LED/XZxx45S-9.step
5.20 x 2.80 x 1.87 mm
