ryanstevensmith/SR-Kicad-lib/3D/Modules/Adafruit Ethernet FeatherWing.step

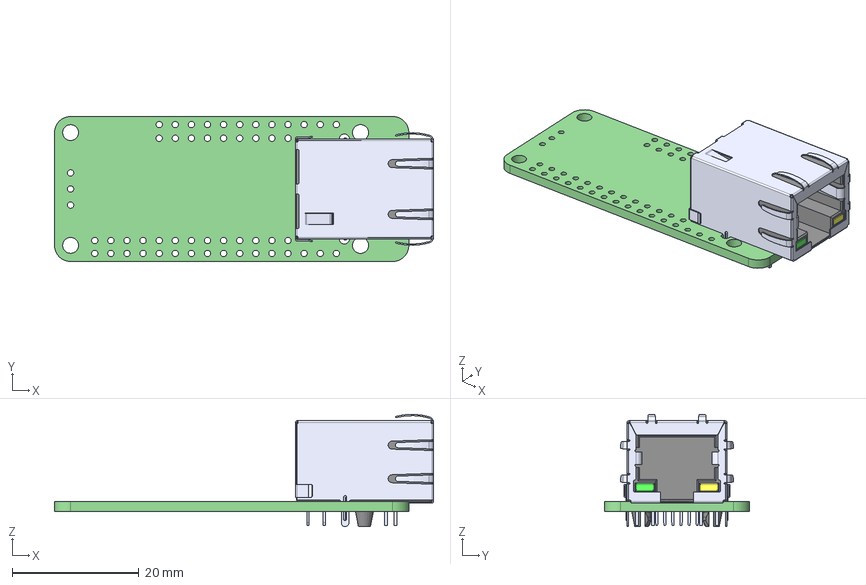
[picture p64: CAD file, 2023-06-09]
3D/Modules/Adafruit Ethernet FeatherWing.step
59.8 x 22.9 x 17.7 mm
Adafruit Ethernet FeatherWing PCB
