ryanstevensmith/SR-Kicad-lib/3D/Package_DFN_QFN/ECLAMP2485T.stp

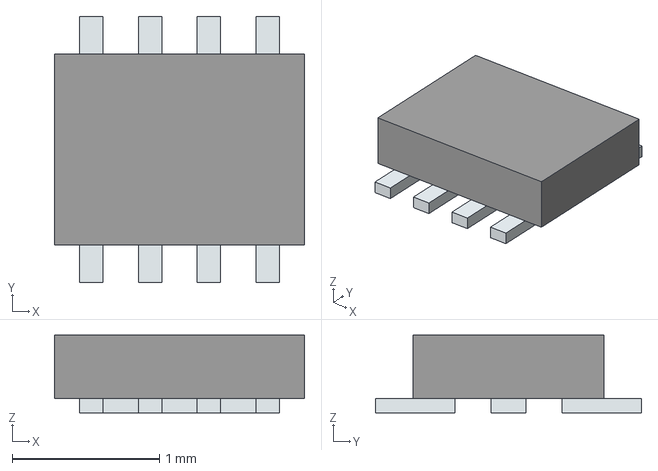
[picture p65: CAD file, 2026-04-07]
3D/Package_DFN_QFN/ECLAMP2485T.stp
1.70 x 1.81 x 0.53 mm
Pins
