ryanstevensmith/SR-Kicad-lib/3D/Package_LGA/LPS22HBTR.step

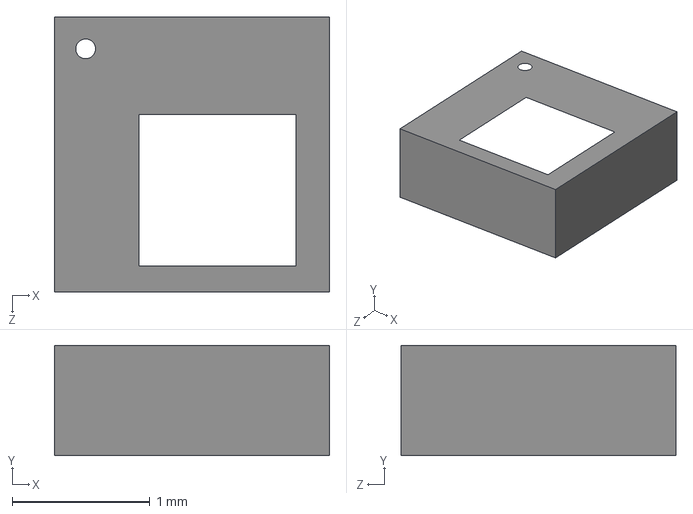
[picture p66: CAD file, 2023-08-29]
3D/Package_LGA/LPS22HBTR.step
2.00 x 0.8 x 2.00 mm
