ryanstevensmith/SR-Kicad-lib/3D/Package_SON/Texas_DQN0004A - X2SON.step

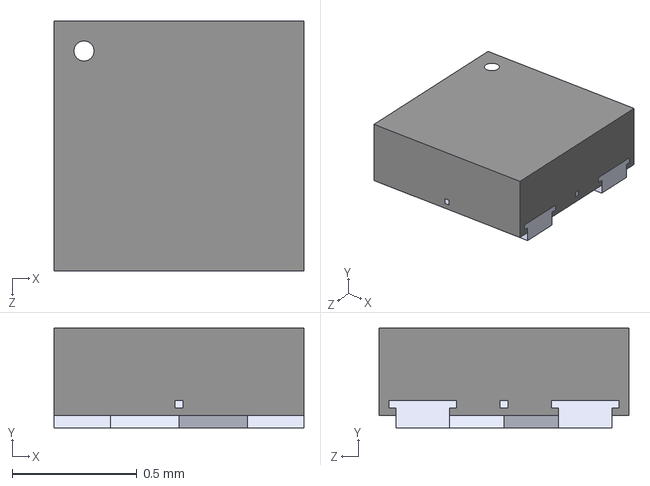
[picture p67: CAD file, 2026-04-07]
3D/Package_SON/Texas_DQN0004A - X2SON.step
1.00 x 0.4 x 1.00 mm
