ryanstevensmith/SR-Kicad-lib/3D/Package_SOT/SOT-23.step

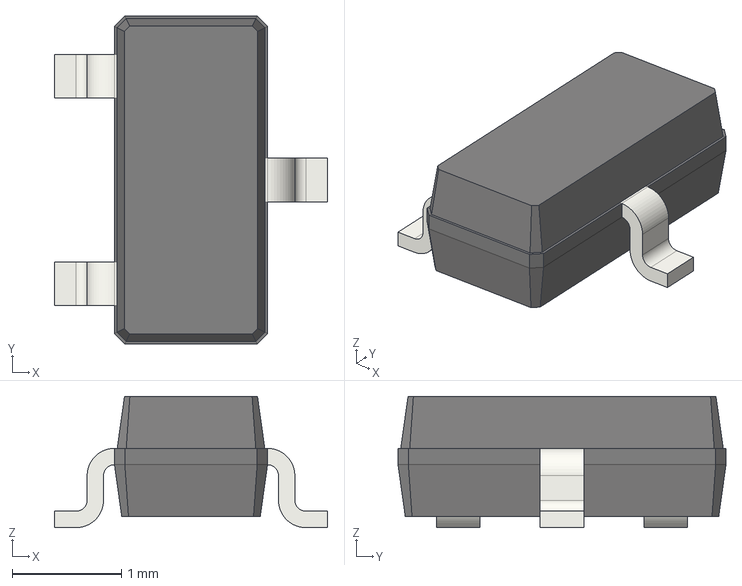
[picture p68: CAD file, 2023-04-03]
3D/Package_SOT/SOT-23.step
2.50 x 3.00 x 1.20 mm
