ryanstevensmith/SR-Kicad-lib/3D/RF_Module/L96-M33.step

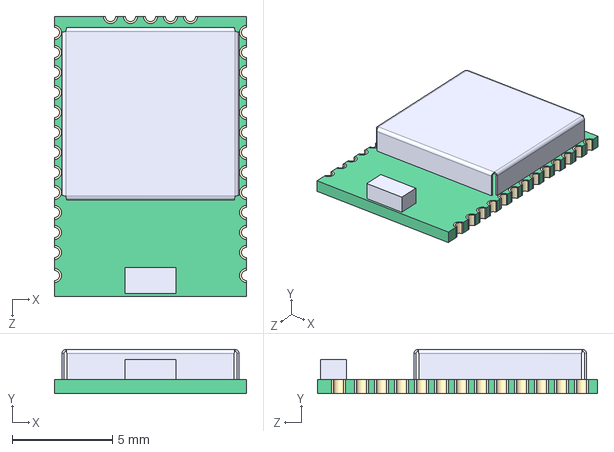
[picture p69: CAD file, 2024-06-04]
3D/RF_Module/L96-M33.step
9.60 x 2.20 x 14.0 mm
