ryanstevensmith/SR-Kicad-lib/3D/Sensor_Audio/SPH0641LU4H-1.step

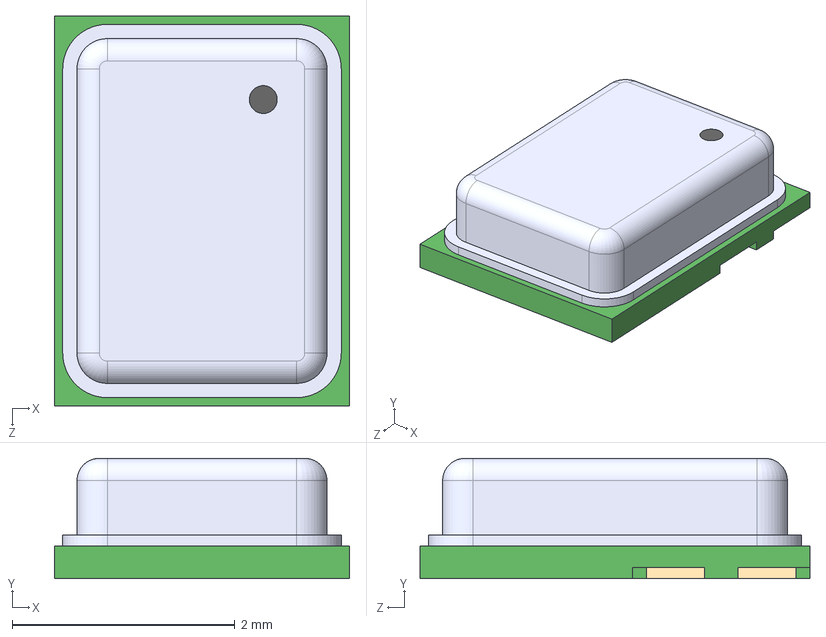
[picture p70: CAD file, 2023-06-09]
3D/Sensor_Audio/SPH0641LU4H-1.step
2.65 x 1.08 x 3.50 mm
