ryanstevensmith/SR-Kicad-lib/CM4/CM4 Library/Raspberry-Pi-CM4-3D-Models/DF40C-100DP-0.4V_51_.step

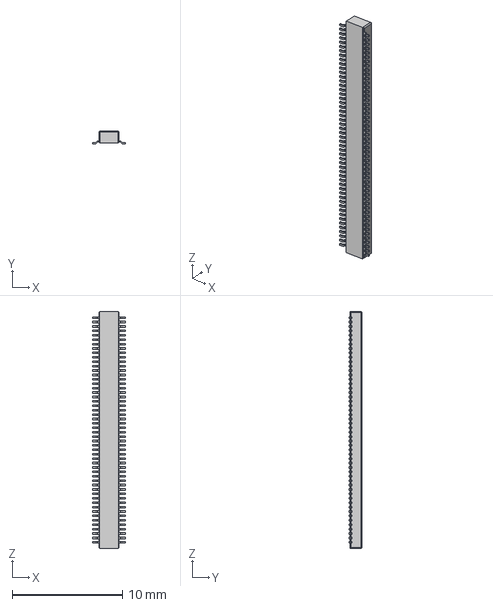
[picture p71: CAD file, 2026-04-07]
CM4/CM4 Library/Raspberry-Pi-CM4-3D-Models/DF40C-100DP-0.4V_51_.step
2.97 x 1.14 x 21.5 mm
