ryanstevensmith/SR-Kicad-lib/3D/Antenna/U.FL-R-SMT-1.STEP

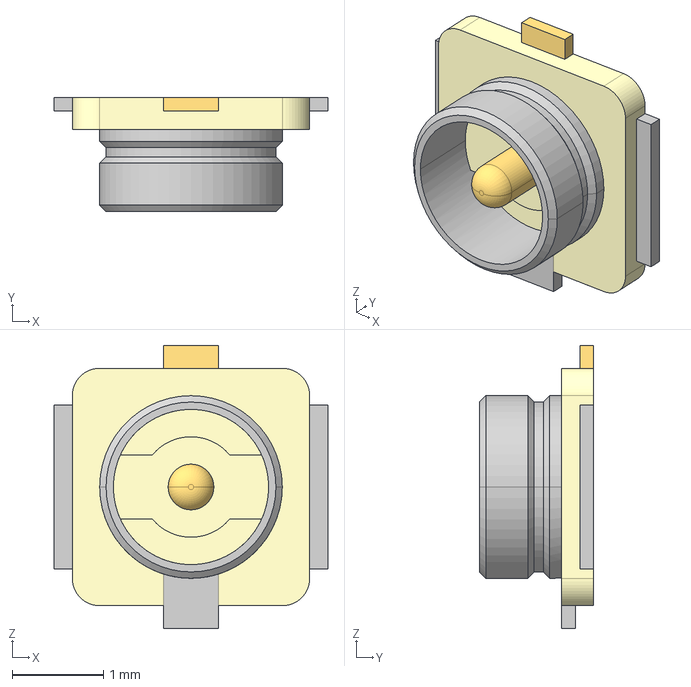
[picture p72: CAD file, 2023-04-03]
3D/Antenna/U.FL-R-SMT-1.STEP
3.00 x 1.25 x 3.10 mm
