ryanstevensmith/SR-Kicad-lib/3D/Button_Switch/TL3305AFxxxxG.stp

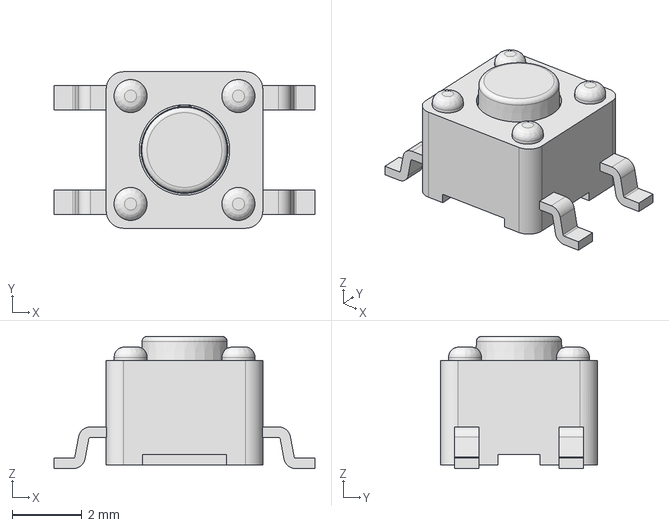
[picture p73: CAD file, 2024-06-04]
3D/Button_Switch/TL3305AFxxxxG.stp
7.50 x 4.50 x 3.80 mm
