ryanstevensmith/SR-Kicad-lib/3D/Inductor/G2401PR-AF v1.step

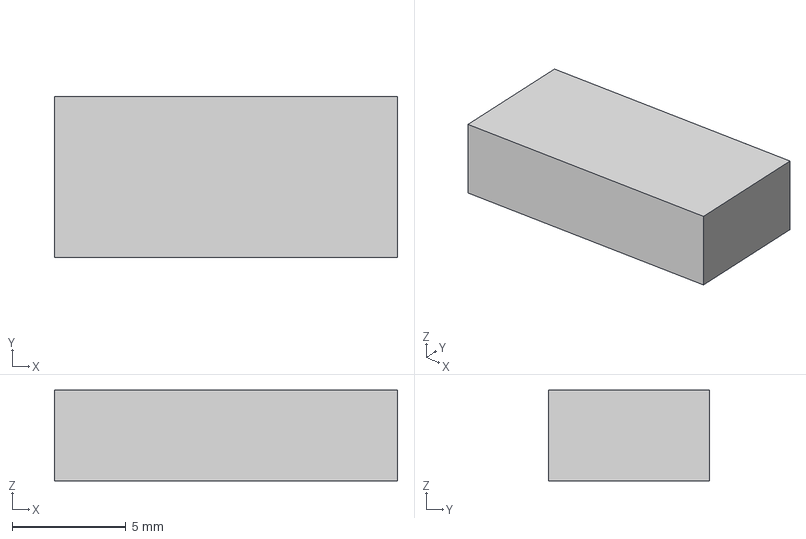
[picture p74: CAD file, 2026-04-07]
3D/Inductor/G2401PR-AF v1.step
15.1 x 7.10 x 4.00 mm
