ryanstevensmith/SR-Kicad-lib/3D/LED/LTST-C230KRKT.step

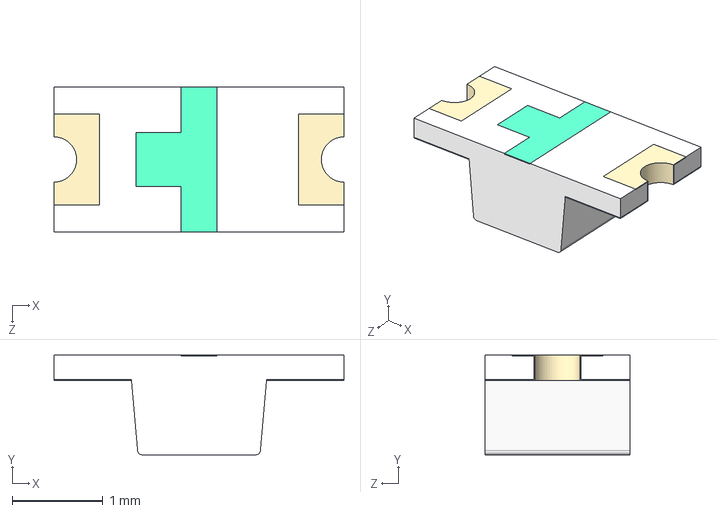
[picture p75: CAD file, 2024-06-04]
3D/LED/LTST-C230KRKT.step
3.20 x 1.10 x 1.60 mm
