ryanstevensmith/SR-Kicad-lib/3D/Modules/3201 Ethernet FeatherWing.step

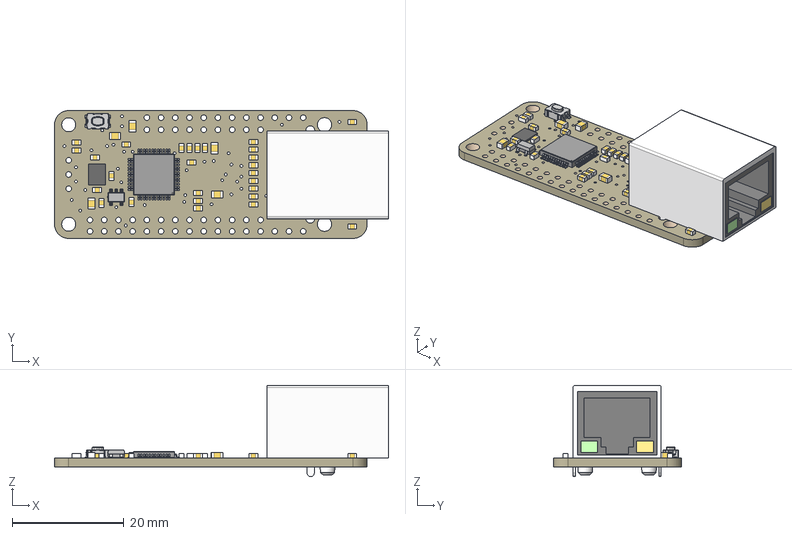
[picture p76: CAD file, 2023-06-09]
3D/Modules/3201 Ethernet FeatherWing.step
59.7 x 22.9 x 16.4 mm
Board
W5500
RB1-125BAG1A
25MHz
10K x 27
ferrite x 5
74AHC1G125
KMR2
