ryanstevensmith/SR-Kicad-lib/3D/Package_DFN_QFN/ECLAMP8052P.step

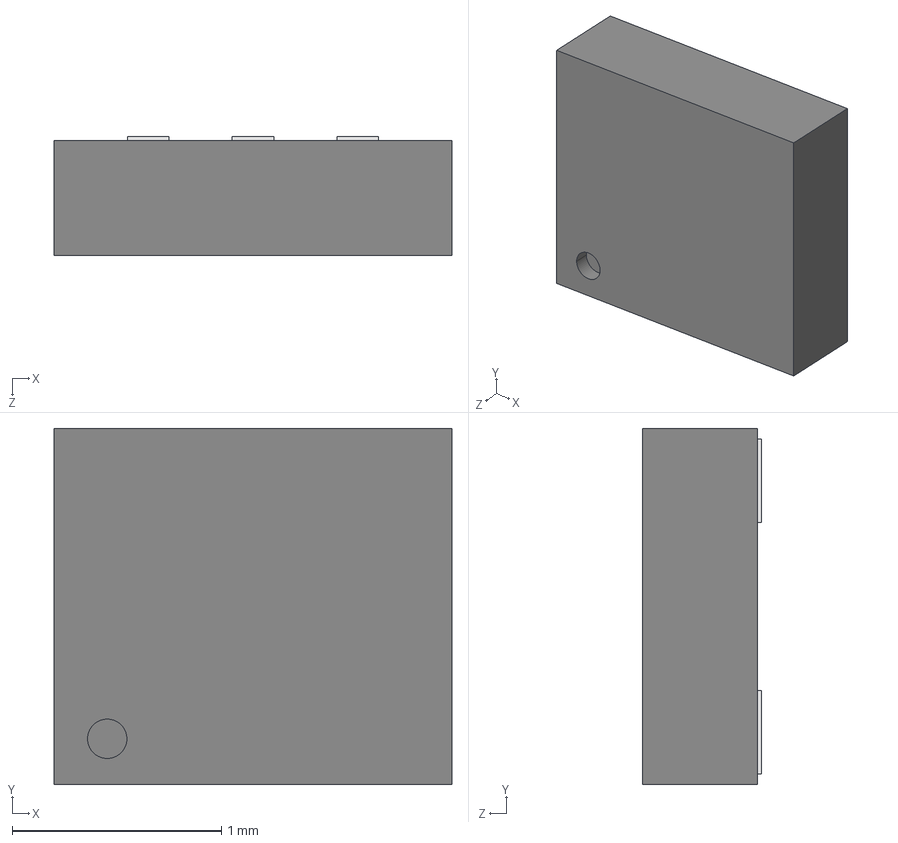
[picture p77: CAD file, 2026-04-07]
3D/Package_DFN_QFN/ECLAMP8052P.step
1.90 x 1.70 x 0.568 mm
