ryanstevensmith/SR-Kicad-lib/3D/Package_LGA/14-LGA_2.5x3.step

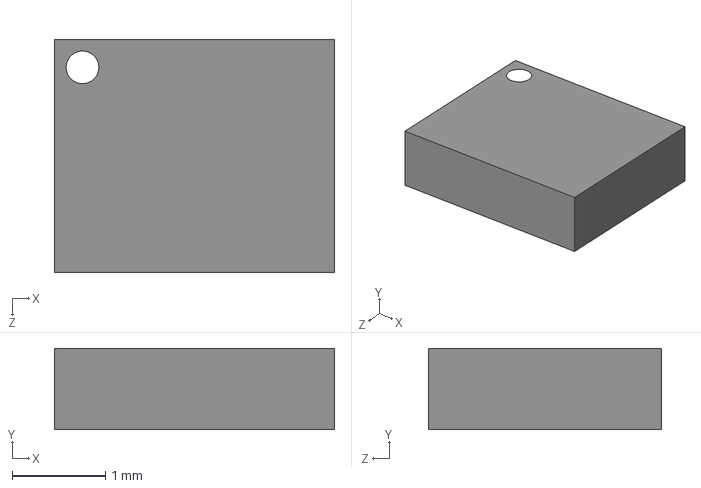
[picture p78: CAD file, 2023-08-29]
3D/Package_LGA/14-LGA_2.5x3.step
3.00 x 0.87 x 2.50 mm
