ryanstevensmith/SR-Kicad-lib/3D/Package_SON/Texas-DNH0008A-VSONP.step

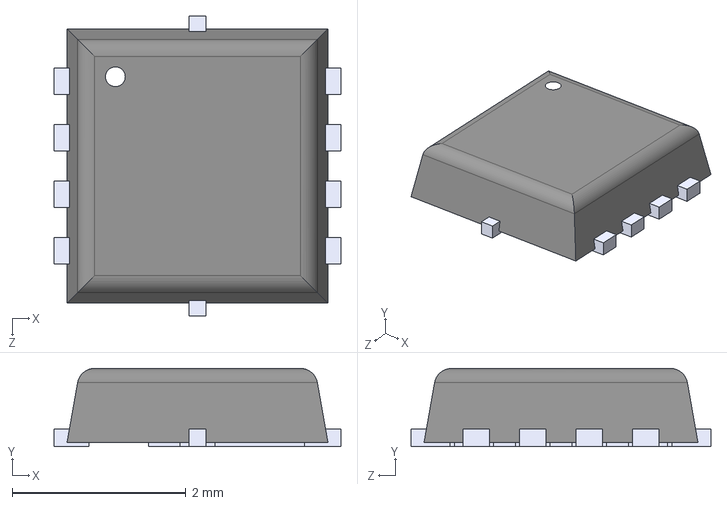
[picture p79: CAD file, 2026-04-07]
3D/Package_SON/Texas-DNH0008A-VSONP.step
3.30 x 0.9 x 3.45 mm
