ryanstevensmith/SR-Kicad-lib/3D/Package_SOT/SOT-353_SC-70-5.step

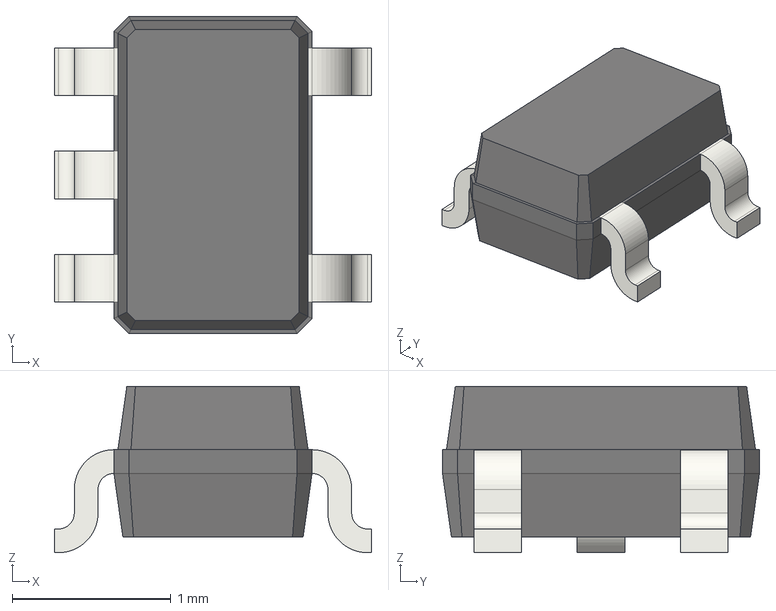
[picture p80: CAD file, 2023-04-03]
3D/Package_SOT/SOT-353_SC-70-5.step
2.00 x 2.00 x 1.05 mm
