ryanstevensmith/SR-Kicad-lib/3D/RF_Module/ESP32-S3-WROOM-1.step

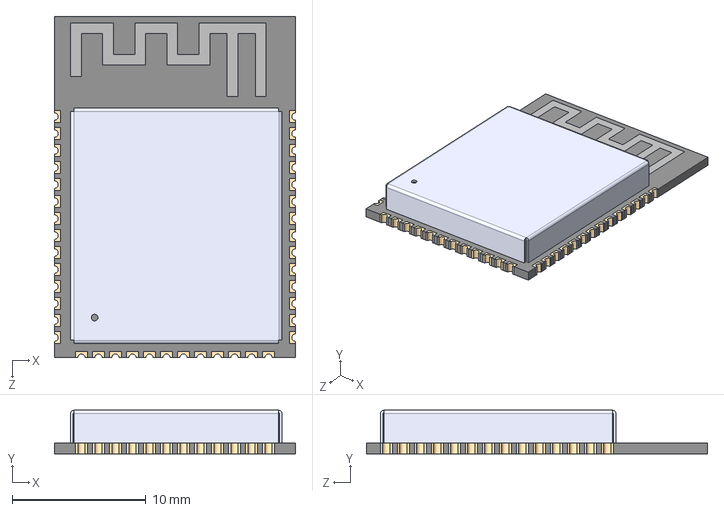
[picture p81: CAD file, 2023-06-09]
3D/RF_Module/ESP32-S3-WROOM-1.step
18.0 x 3.25 x 25.5 mm
