ryanstevensmith/SR-Kicad-lib/3D/Antenna/CON-SMA-EDGE-S.step

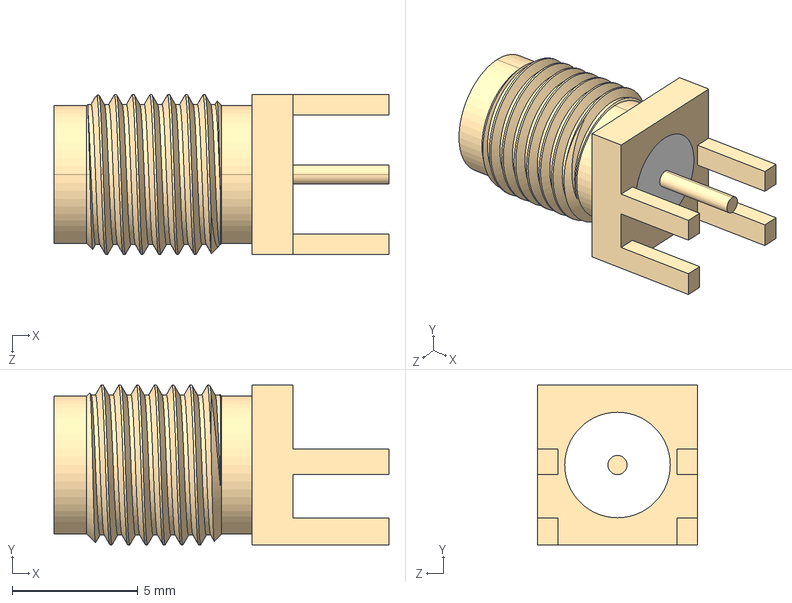
[picture p82: CAD file, 2023-04-03]
3D/Antenna/CON-SMA-EDGE-S.step
13.3 x 6.35 x 6.35 mm
