ryanstevensmith/SR-Kicad-lib/3D/Button_Switch/PTS810_SJM_250_SMTR_LFS.step

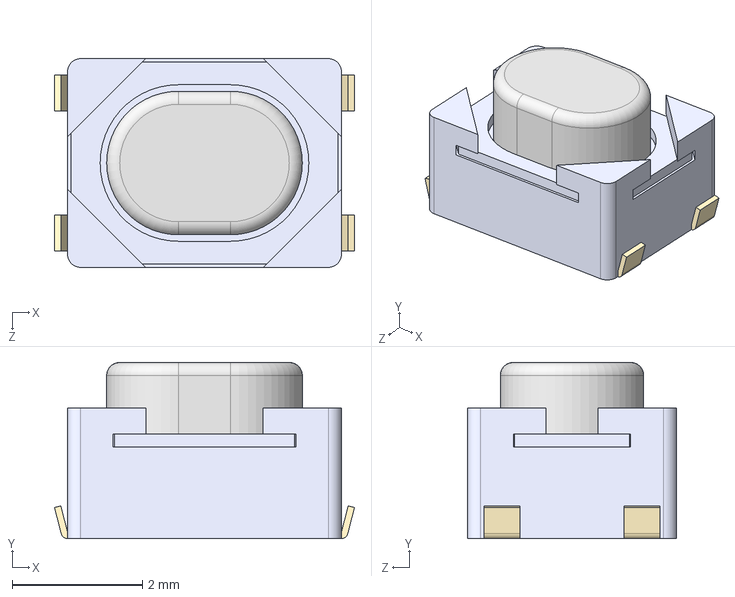
[picture p83: CAD file, 2024-06-04]
3D/Button_Switch/PTS810_SJM_250_SMTR_LFS.step
4.60 x 2.70 x 3.20 mm
