ryanstevensmith/SR-Kicad-lib/3D/Connectors/FFC2B35-10-G_REVA2.step

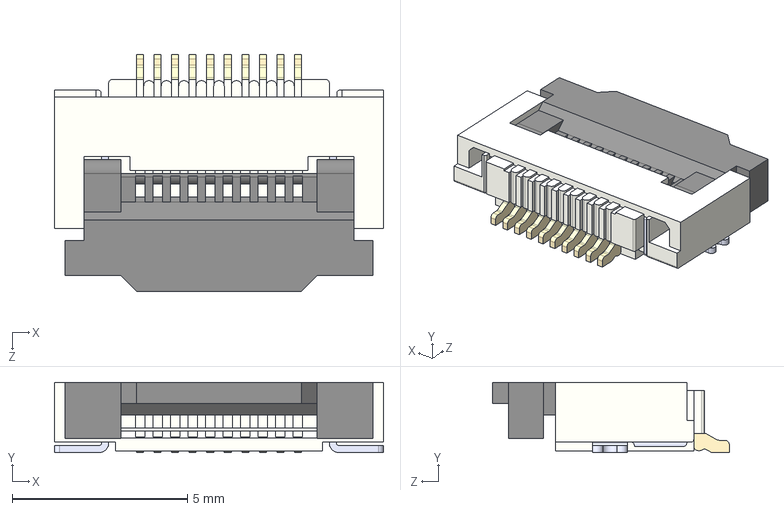
[picture p84: CAD file, 2026-04-07]
3D/Connectors/FFC2B35-10-G_REVA2.step
9.40 x 2.00 x 6.76 mm
