ryanstevensmith/SR-Kicad-lib/3D/Inductor/CDRH127_LDNP-470MC.step

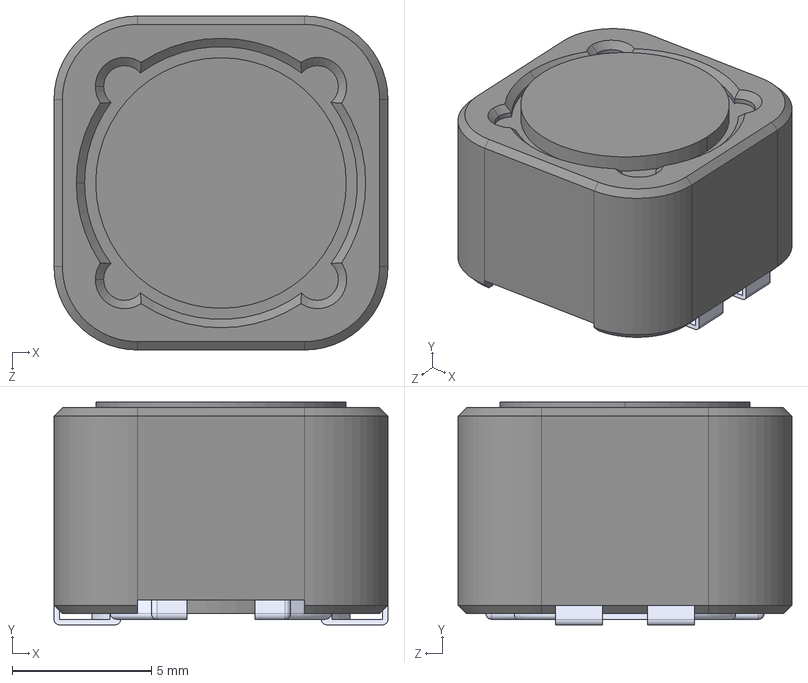
[picture p85: CAD file, 2024-06-04]
3D/Inductor/CDRH127_LDNP-470MC.step
12.0 x 8.00 x 12.0 mm
