ryanstevensmith/SR-Kicad-lib/3D/LED/PLCC4 SMD.STEP

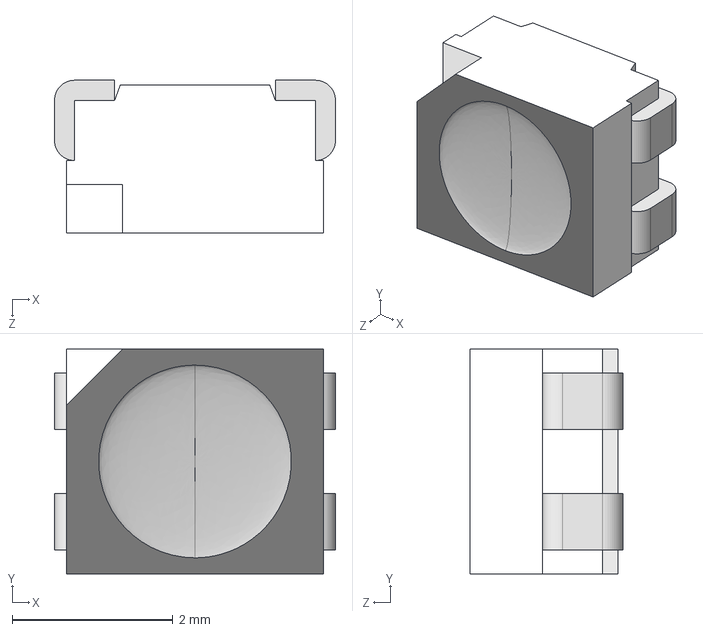
[picture p86: CAD file, 2024-06-04]
3D/LED/PLCC4 SMD.STEP
3.50 x 2.80 x 1.90 mm
