ryanstevensmith/SR-Kicad-lib/3D/Package_DFN_QFN/Texas-VQFN-56.step

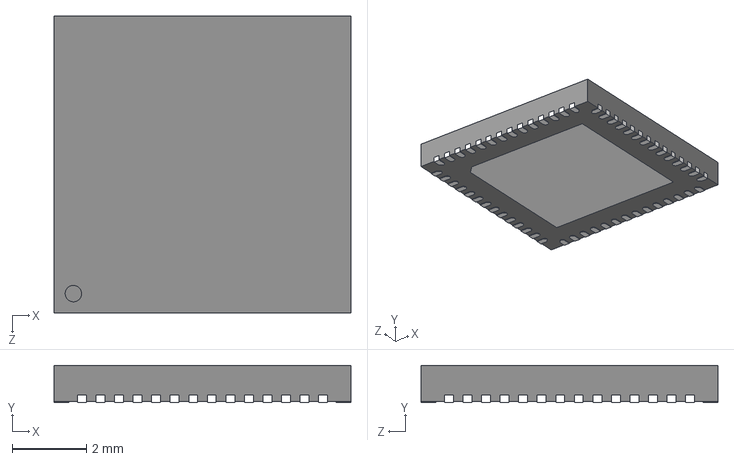
[picture p88: CAD file, 2026-04-07]
3D/Package_DFN_QFN/Texas-VQFN-56.step
8.00 x 1.00 x 8.00 mm
