ryanstevensmith/SR-Kicad-lib/3D/Package_LGA/LGA-16_3x4.5.step

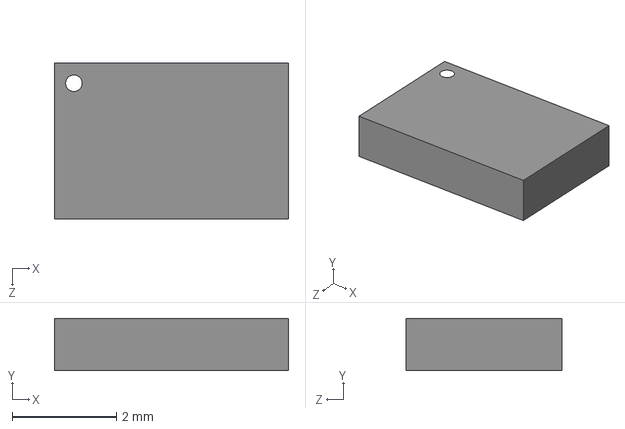
[picture p89: CAD file, 2023-04-03]
3D/Package_LGA/LGA-16_3x4.5.step
4.50 x 1.00 x 3.00 mm
