ryanstevensmith/SR-Kicad-lib/3D/Package_SON/Texas_DRZ0012A.step

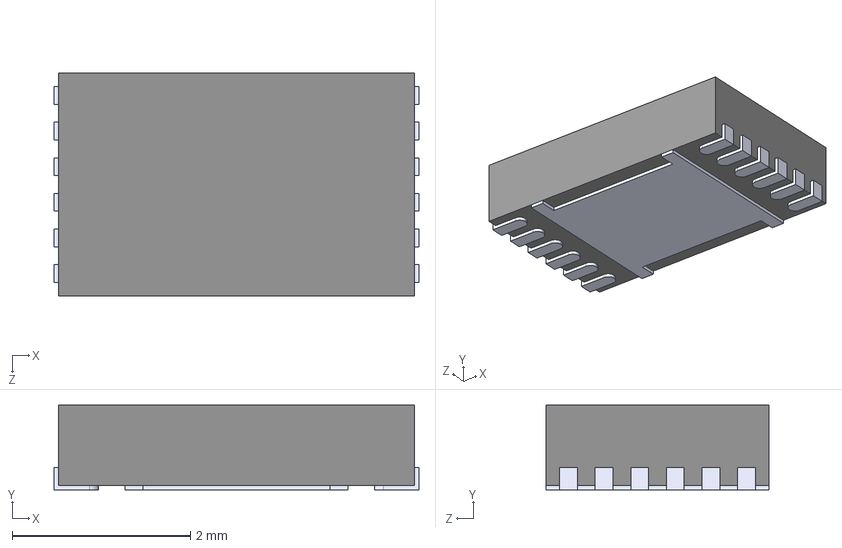
[picture p90: CAD file, 2024-06-23]
3D/Package_SON/Texas_DRZ0012A.step
4.10 x 0.95 x 2.50 mm
