ryanstevensmith/SR-Kicad-lib/3D/Package_SOT/TSOT-23-5.step

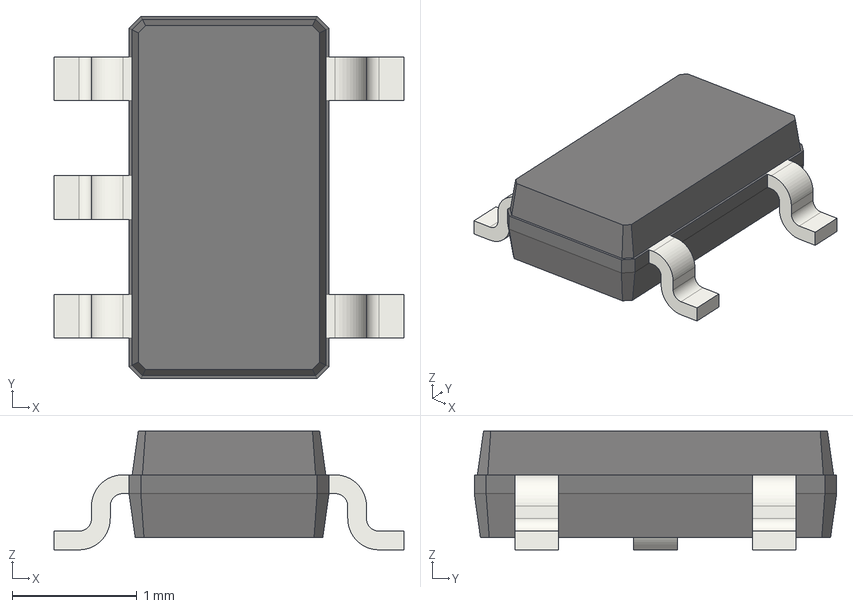
[picture p91: CAD file, 2023-04-03]
3D/Package_SOT/TSOT-23-5.step
2.80 x 2.90 x 0.95 mm
