ryanstevensmith/SR-Kicad-lib/3D/RF_Module/ESP32-S3-MINI-1-N8.step

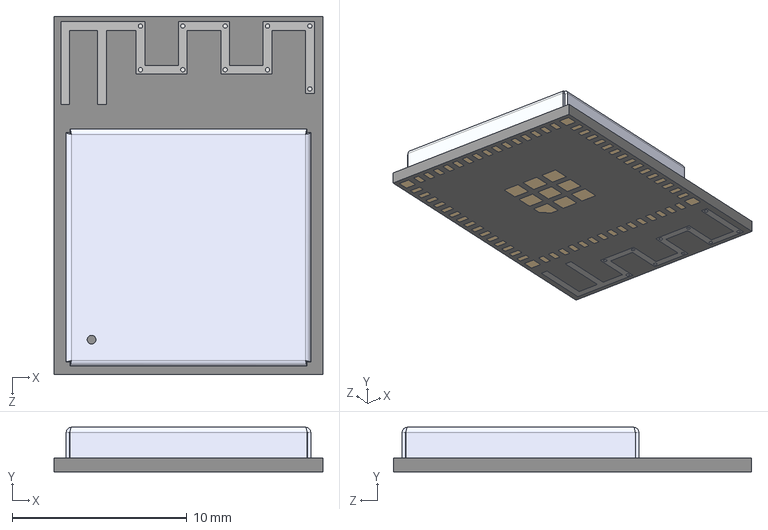
[picture p92: CAD file, 2023-06-09]
3D/RF_Module/ESP32-S3-MINI-1-N8.step
15.4 x 2.55 x 20.5 mm
