ryanstevensmith/SR-Kicad-lib/3D/Button_Switch/CUS-12TB.step

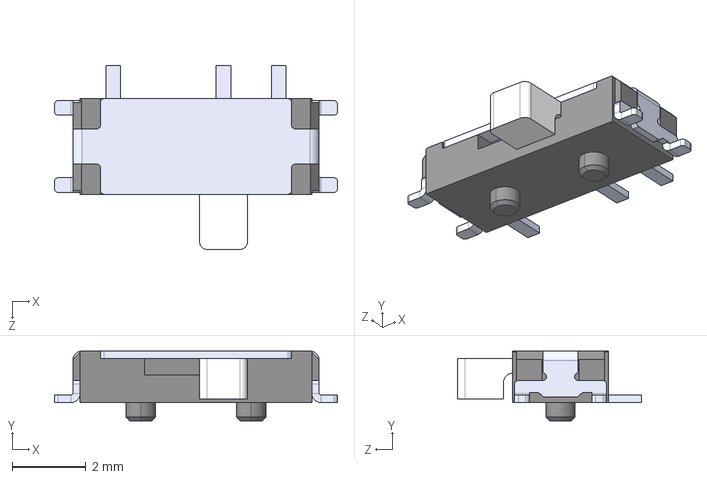
[picture p93: CAD file, 2024-06-04]
3D/Button_Switch/CUS-12TB.step
7.70 x 1.90 x 5.00 mm
