ryanstevensmith/SR-Kicad-lib/3D/Inductor/ACM1211-701-2PL-TL01.step

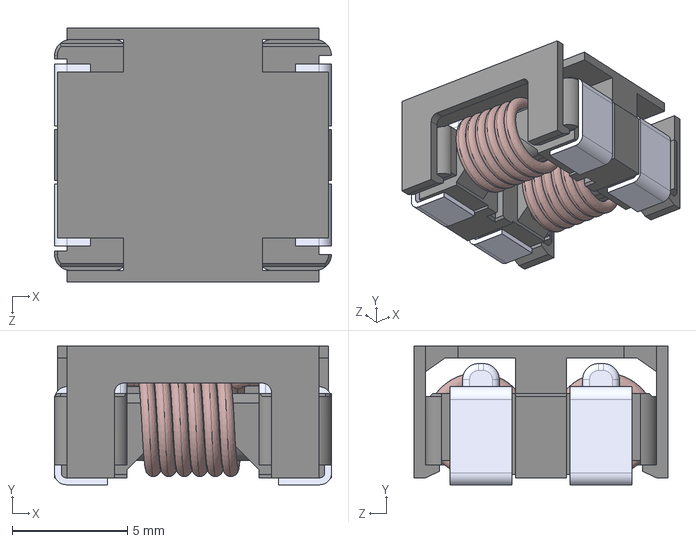
[picture p94: CAD file, 2024-06-04]
3D/Inductor/ACM1211-701-2PL-TL01.step
12.0 x 6.00 x 11.0 mm
