ryanstevensmith/SR-Kicad-lib/3D/LED/KRBT_QDLP61_3A.STEP

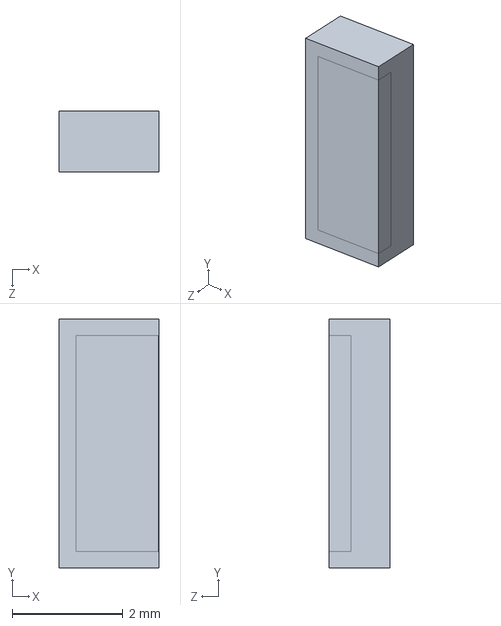
[picture p95: CAD file, 2024-06-04]
3D/LED/KRBT_QDLP61_3A.STEP
1.80 x 4.50 x 1.10 mm
