ryanstevensmith/SR-Kicad-lib/3D/Modules/SEN-13879.step

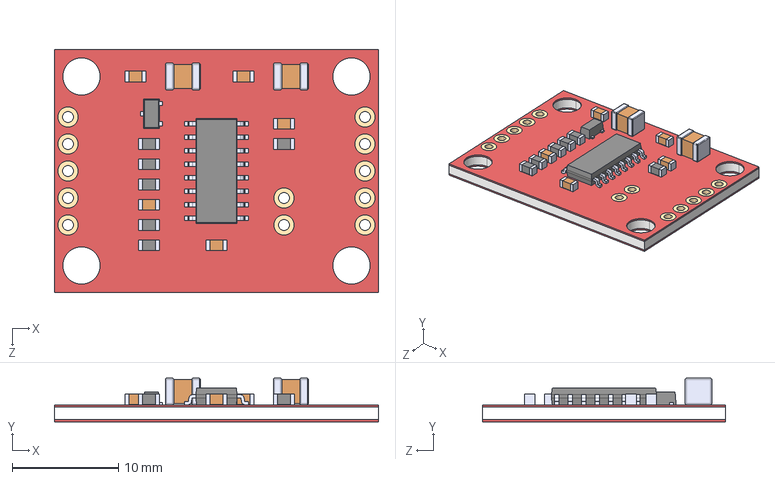
[picture p96: CAD file, 2023-04-03]
3D/Modules/SEN-13879.step
30.5 x 4.10 x 22.9 mm
