ryanstevensmith/SR-Kicad-lib/3D/Package_DFN_QFN/DFN1006-2.stp

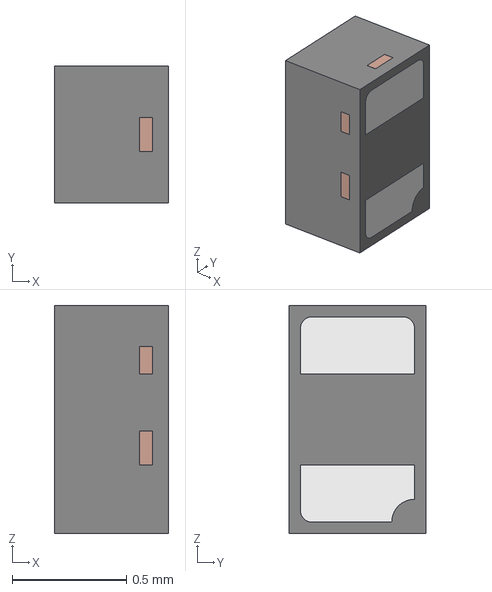
[picture p97: CAD file, 2026-04-07]
3D/Package_DFN_QFN/DFN1006-2.stp
0.5 x 0.6 x 1.00 mm
LDF
