ryanstevensmith/SR-Kicad-lib/3D/Package_LGA/LGA-12_2x2.step

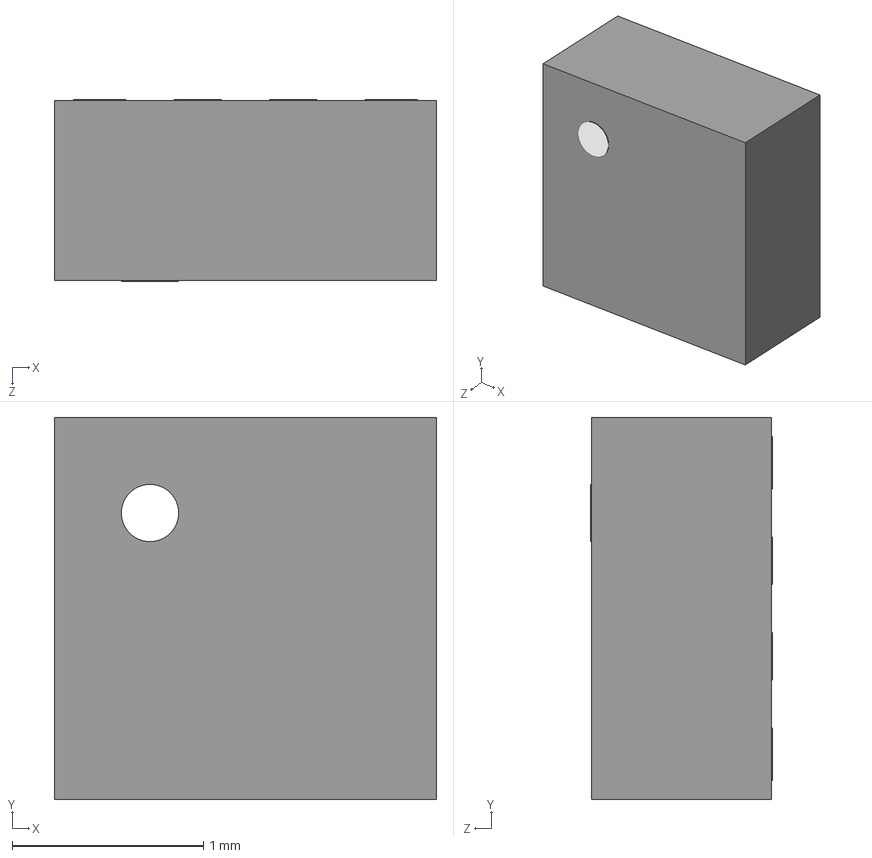
[picture p98: CAD file, 2023-04-03]
3D/Package_LGA/LGA-12_2x2.step
2.00 x 2.00 x 0.955 mm
