ryanstevensmith/SR-Kicad-lib/3D/Package_SON/DRB0008A.stp

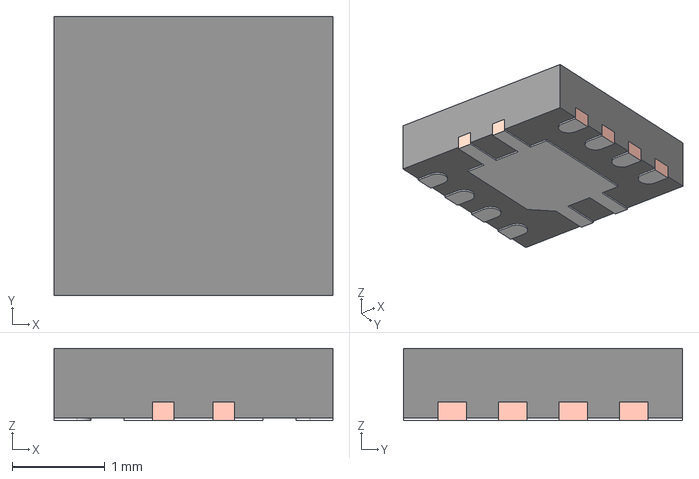
[picture p99: CAD file, 2024-06-04]
3D/Package_SON/DRB0008A.stp
3.00 x 3.00 x 0.775 mm
BODY-SON
FRAME-DRB0008A
