ryanstevensmith/SR-Kicad-lib/3D/Button_Switch/PTS636_SM43J_SMTR_LFS.step

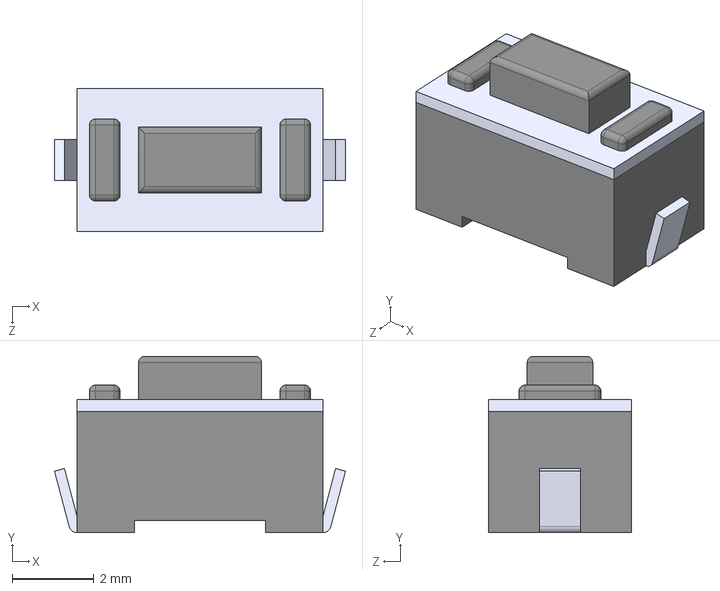
[picture p100: CAD file, 2024-06-04]
3D/Button_Switch/PTS636_SM43J_SMTR_LFS.step
7.10 x 4.30 x 3.50 mm
