ryanstevensmith/SR-Kicad-lib/3D/Connectors/2EDGVC-5.08-02P-14-00AH.STEP

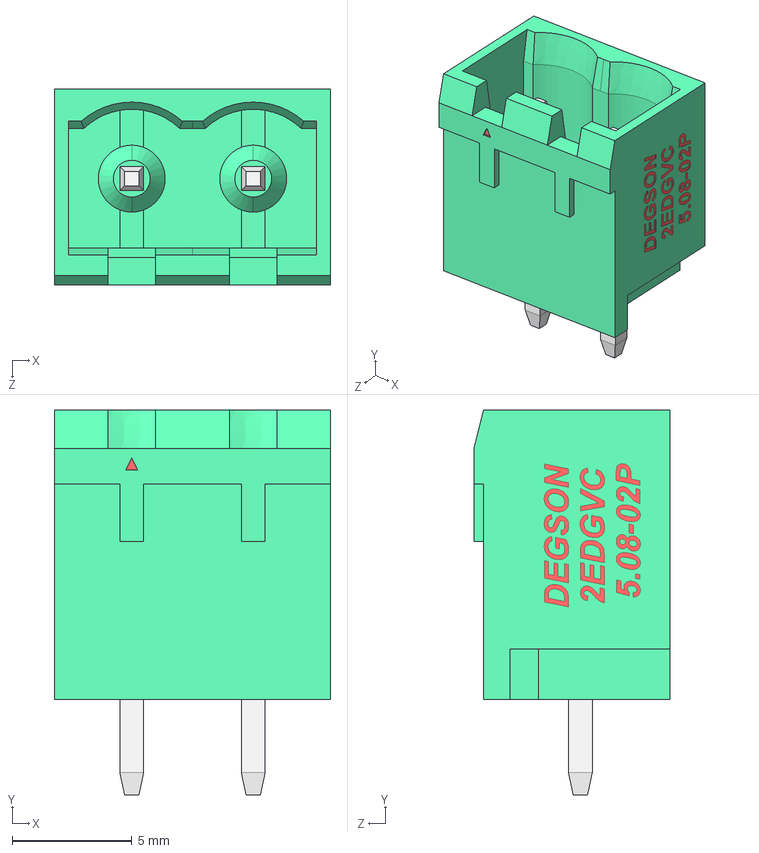
[picture p101: CAD file, 2026-04-07]
3D/Connectors/2EDGVC-5.08-02P-14-00AH.STEP
11.6 x 16.1 x 8.20 mm
