ryanstevensmith/SR-Kicad-lib/3D/LED/APFA3010.STEP

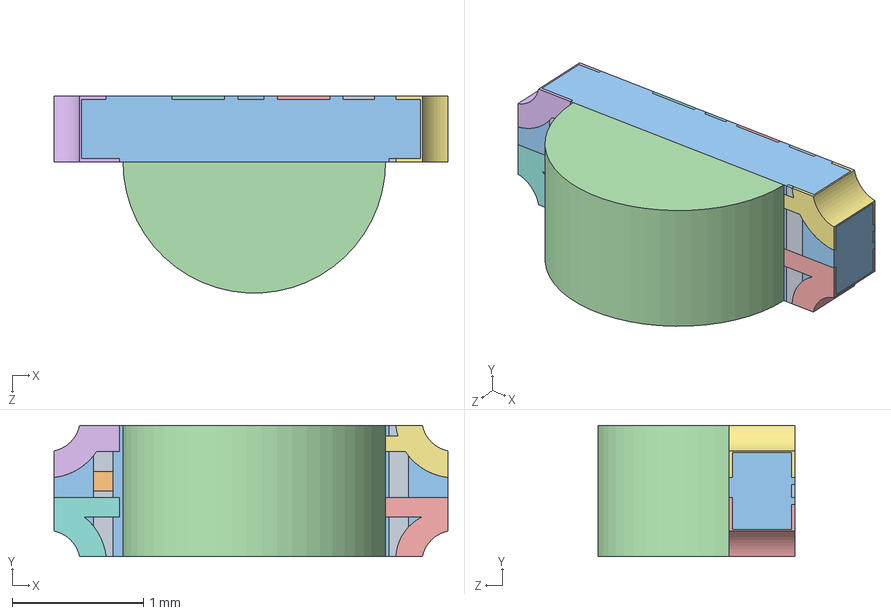
[picture p102: CAD file, 2024-06-04]
3D/LED/APFA3010.STEP
3.00 x 1.00 x 1.50 mm
