ryanstevensmith/SR-Kicad-lib/3D/Modules/DRV887X-carrier.step

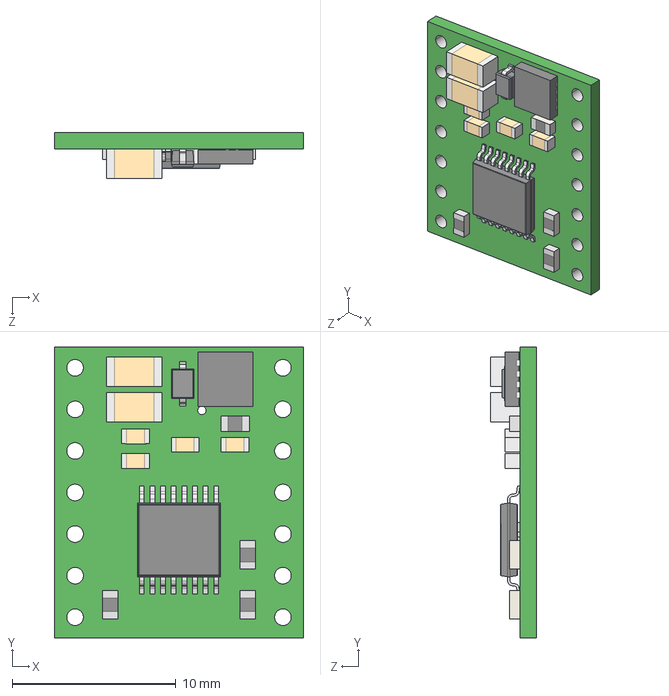
[picture p103: CAD file, 2022-12-28]
3D/Modules/DRV887X-carrier.step
15.2 x 17.8 x 2.82 mm
