ryanstevensmith/SR-Kicad-lib/3D/Package_DFN_QFN/Texas_RHR0028A_QFN-28 .step

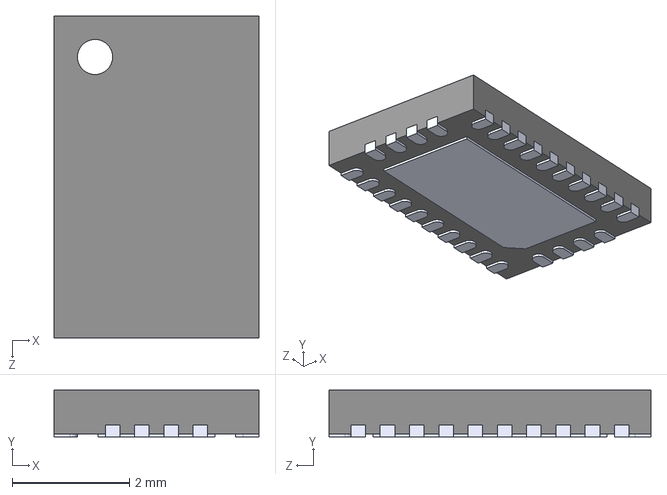
[picture p104: CAD file, 2026-04-07]
3D/Package_DFN_QFN/Texas_RHR0028A_QFN-28 .step
3.50 x 0.8 x 5.50 mm
