ryanstevensmith/SR-Kicad-lib/3D/Package_SON/USON-8_2x3.step

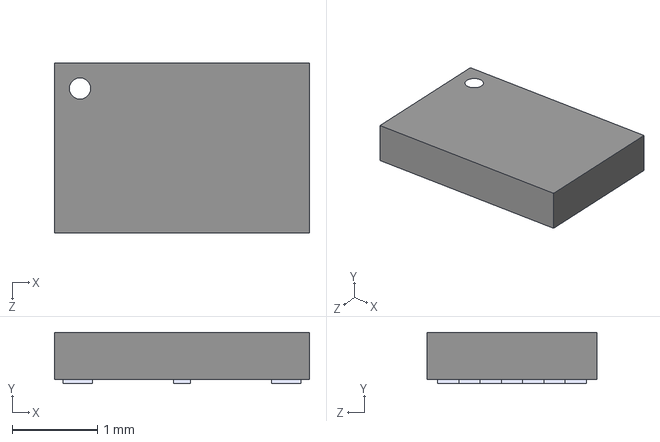
[picture p105: CAD file, 2023-04-03]
3D/Package_SON/USON-8_2x3.step
3.00 x 0.6 x 2.00 mm
