ryanstevensmith/SR-Kicad-lib/3D/Button_Switch/WS-TASV_430451025836.stp

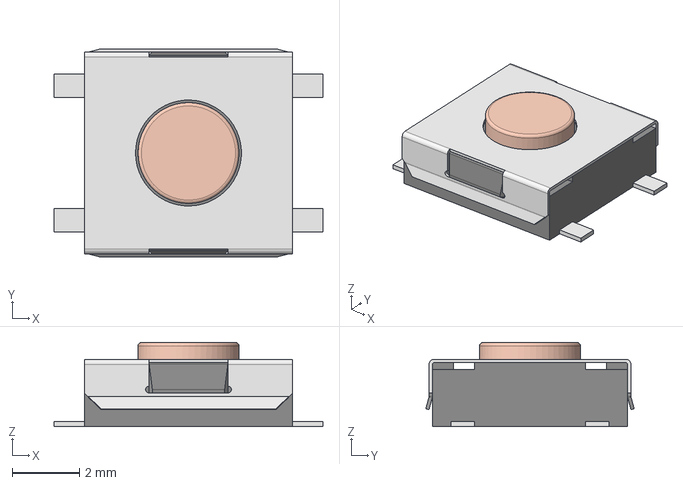
[picture p106: CAD file, 2024-06-04]
3D/Button_Switch/WS-TASV_430451025836.stp
8.00 x 6.20 x 2.50 mm
base
top cover
