ryanstevensmith/SR-Kicad-lib/3D/Inductor/CDRH2D18.STEP

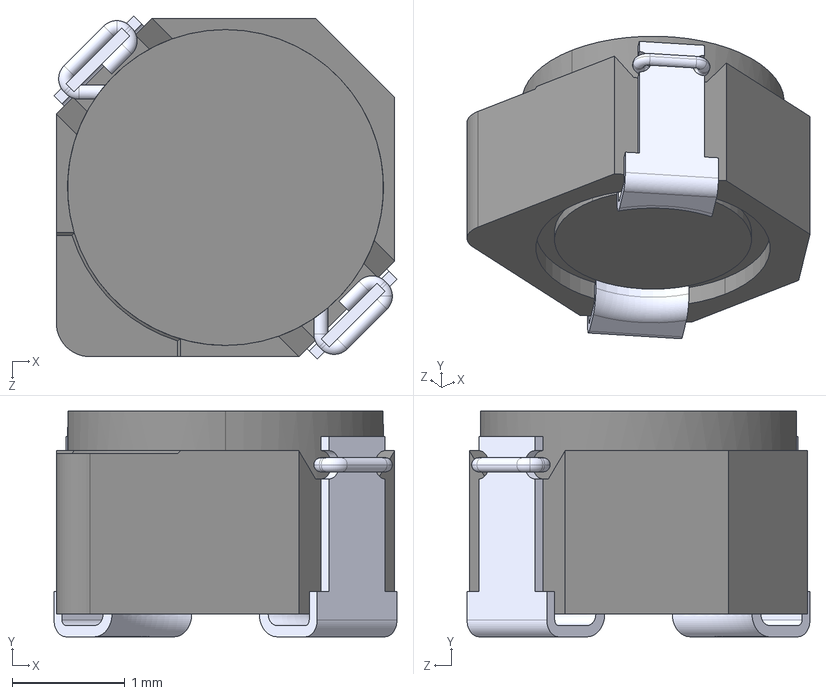
[picture p107: CAD file, 2023-04-03]
3D/Inductor/CDRH2D18.STEP
3.04 x 2.00 x 3.04 mm
