ryanstevensmith/SR-Kicad-lib/3D/LED/Seoul_LED_35_35_23.STEP

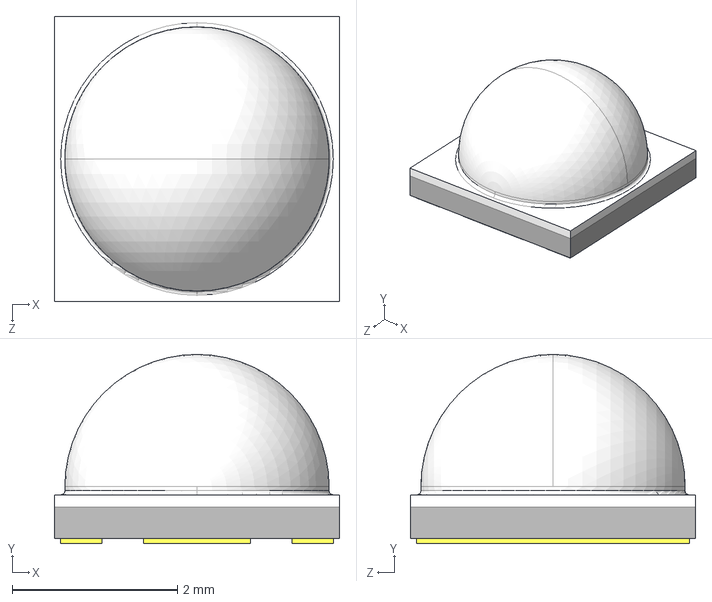
[picture p108: CAD file, 2024-06-04]
3D/LED/Seoul_LED_35_35_23.STEP
3.45 x 2.29 x 3.45 mm
