ryanstevensmith/SR-Kicad-lib/3D/Modules/Adafruit MPM3610.step

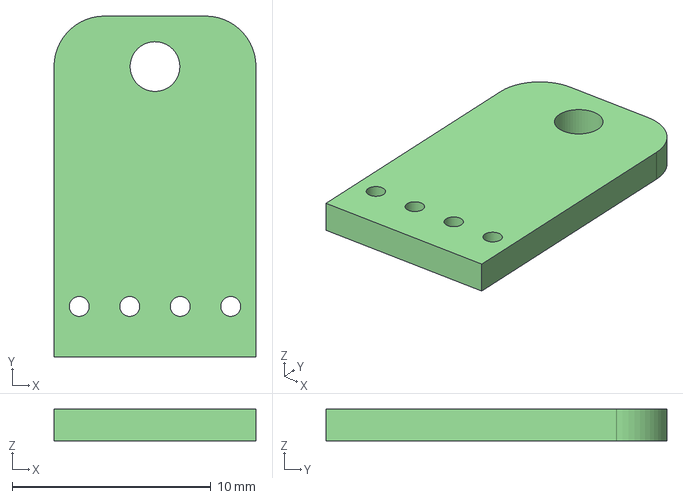
[picture p109: CAD file, 2022-12-28]
3D/Modules/Adafruit MPM3610.step
10.2 x 17.1 x 1.60 mm
