ryanstevensmith/SR-Kicad-lib/3D/Package_DFN_QFN/Texas_RGY0020B_VQFN20.step

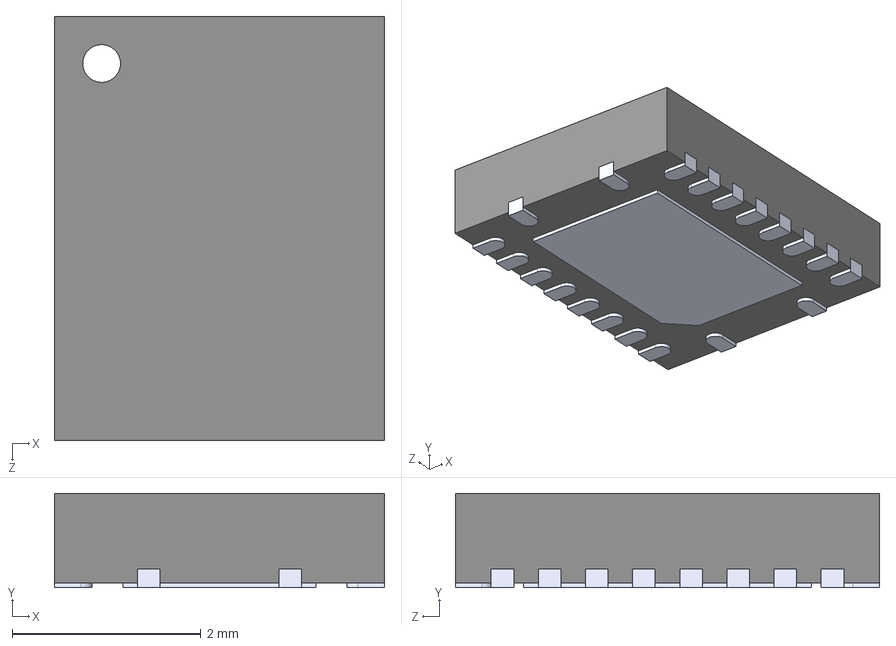
[picture p110: CAD file, 2026-04-07]
3D/Package_DFN_QFN/Texas_RGY0020B_VQFN20.step
3.50 x 1.00 x 4.50 mm
