ryanstevensmith/SR-Kicad-lib/3D/Package_SON/WSON-8_8x6.step

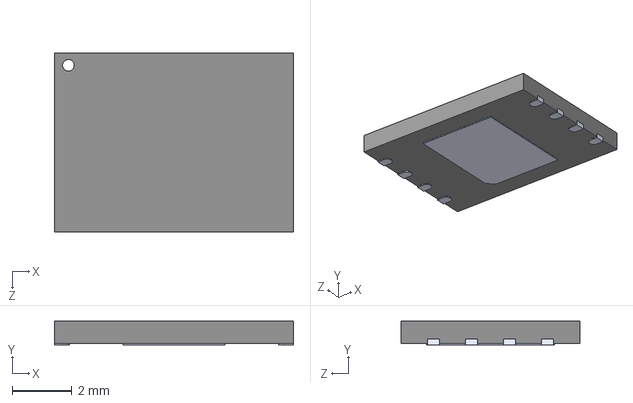
[picture p111: CAD file, 2023-04-03]
3D/Package_SON/WSON-8_8x6.step
8.00 x 0.8 x 6.00 mm
