ryanstevensmith/SR-Kicad-lib/3D/Button_Switch/EVQ-P7L01P.step

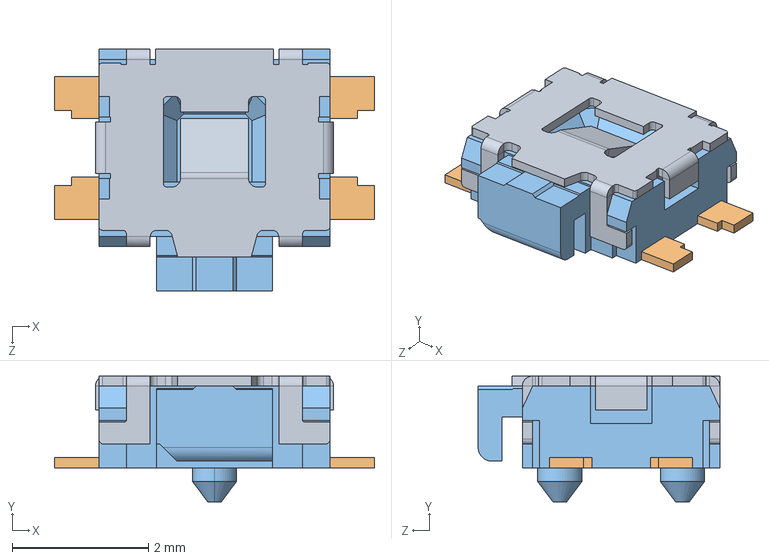
[picture p112: CAD file, 2024-06-04]
3D/Button_Switch/EVQ-P7L01P.step
4.70 x 1.85 x 3.55 mm
