ryanstevensmith/SR-Kicad-lib/3D/Connectors/BM05B-SRSS-TB(LF)(SN).step

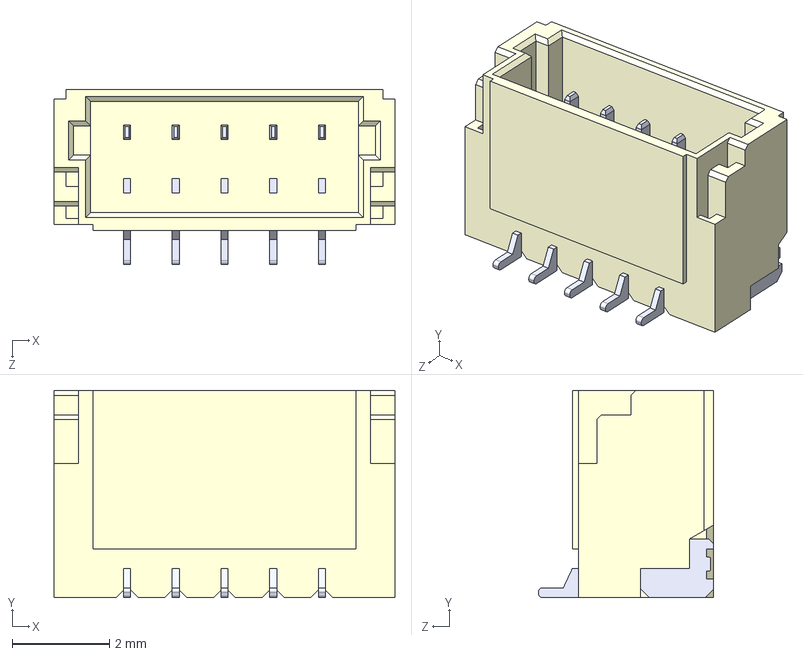
[picture p113: CAD file, 2026-04-07]
3D/Connectors/BM05B-SRSS-TB(LF)(SN).step
7.00 x 4.25 x 3.60 mm
