ryanstevensmith/SR-Kicad-lib/3D/LED/KRTB_AILMS1.STEP

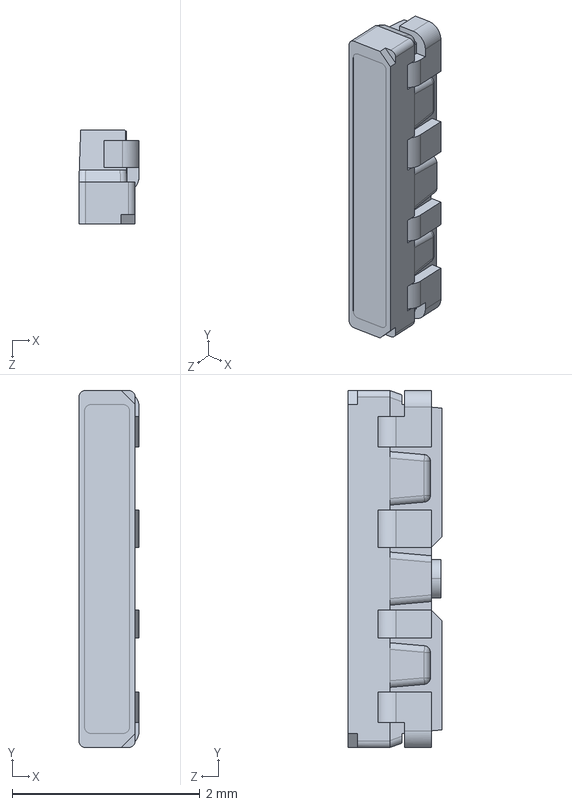
[picture p114: CAD file, 2024-06-04]
3D/LED/KRTB_AILMS1.STEP
0.642 x 3.80 x 1.00 mm
