ryanstevensmith/SR-Kicad-lib/3D/Modules/SW868-TH13.step

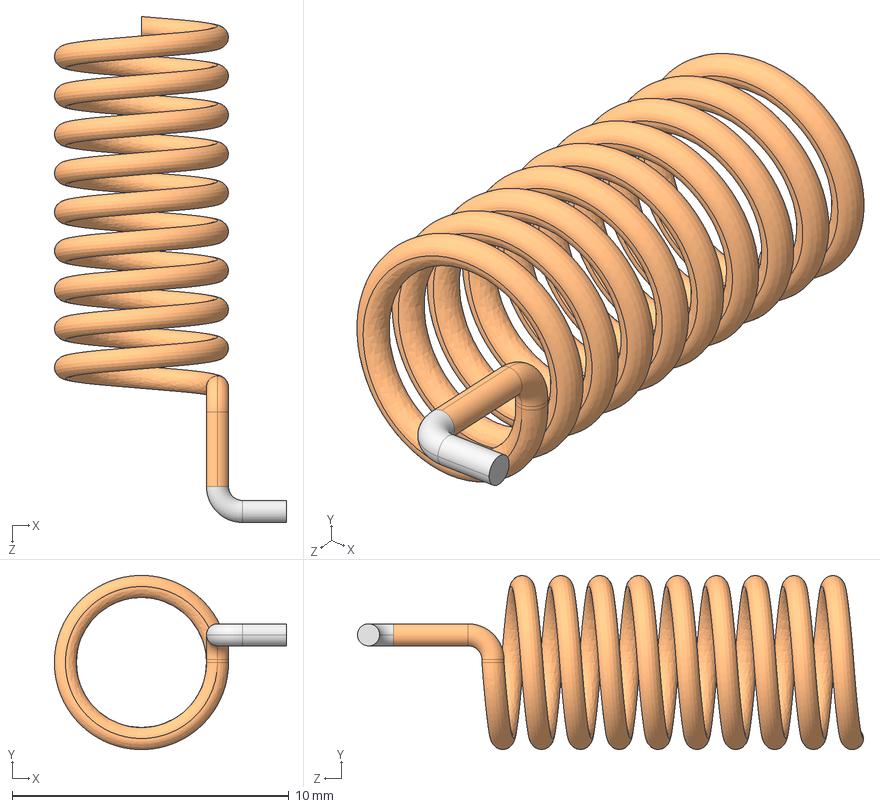
[picture p115: CAD file, 2022-12-28]
3D/Modules/SW868-TH13.step
8.40 x 6.30 x 18.3 mm
