ryanstevensmith/SR-Kicad-lib/3D/Button_Switch/TL4105.step

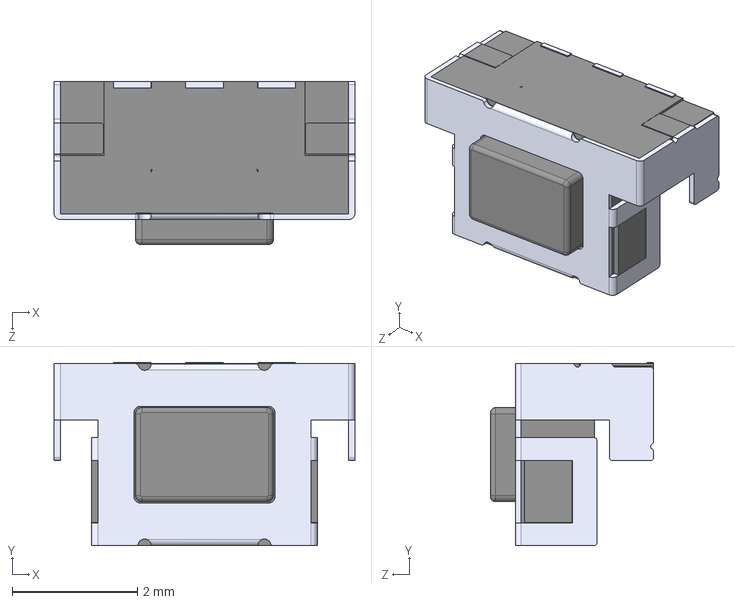
[picture p117: CAD file, 2023-06-09]
3D/Button_Switch/TL4105.step
4.80 x 2.92 x 2.60 mm
