ryanstevensmith/SR-Kicad-lib/3D/Connectors/dc-005-5a-2_0.stp

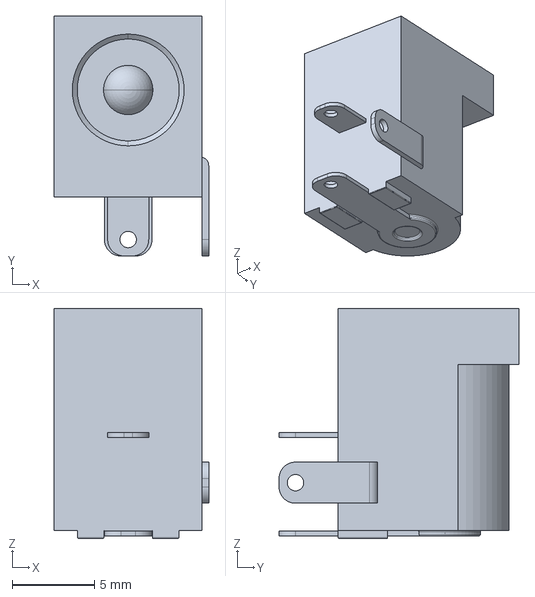
[picture p118: CAD file, 2026-04-07]
3D/Connectors/dc-005-5a-2_0.stp
9.40 x 14.6 x 14.0 mm
