ryanstevensmith/SR-Kicad-lib/3D/LED/EASV3015RGBA0.STEP

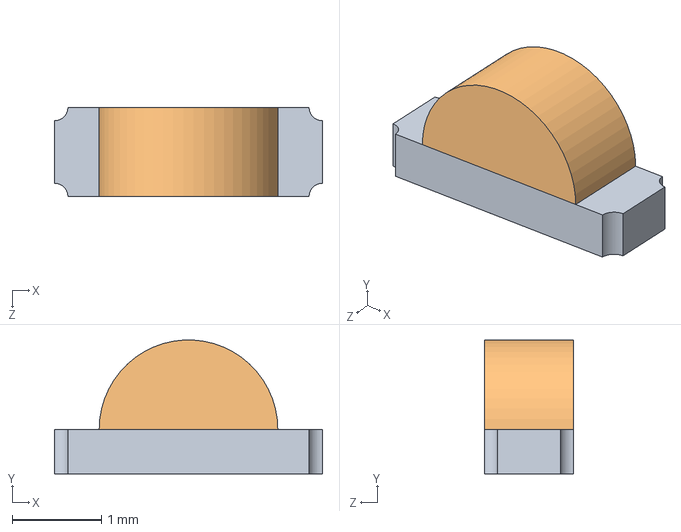
[picture p119: CAD file, 2024-06-04]
3D/LED/EASV3015RGBA0.STEP
3.00 x 1.50 x 1.00 mm
