ryanstevensmith/SR-Kicad-lib/3D/Modules/Adafruit-FONA-800-GSM-Breakout.step

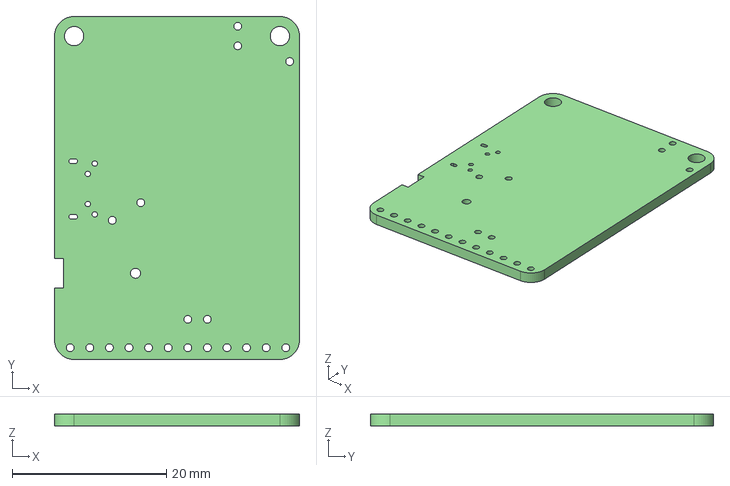
[picture p120: CAD file, 2022-12-28]
3D/Modules/Adafruit-FONA-800-GSM-Breakout.step
31.8 x 44.5 x 1.60 mm
