ryanstevensmith/SR-Kicad-lib/3D/Package_DFN_QFN/Texas_DRC0010_S-PVSON-N10.step

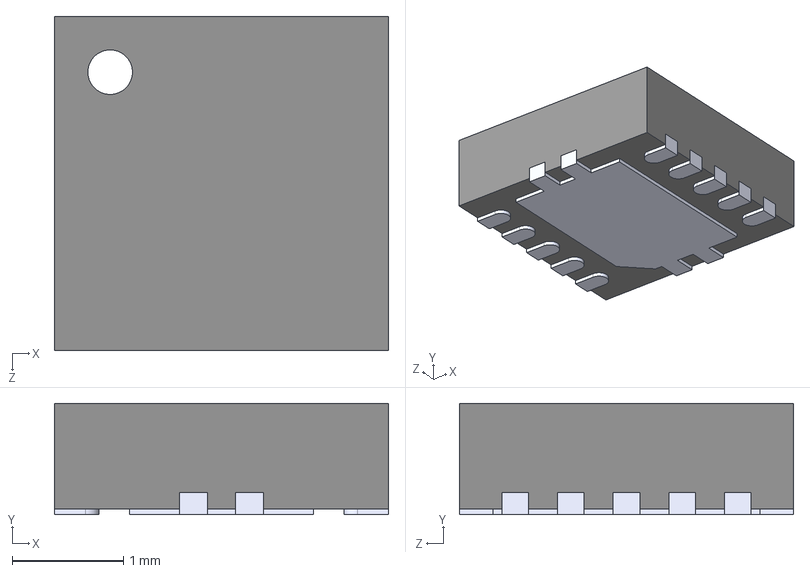
[picture p121: CAD file, 2024-06-04]
3D/Package_DFN_QFN/Texas_DRC0010_S-PVSON-N10.step
3.00 x 1.00 x 3.00 mm
