ryanstevensmith/SR-Kicad-lib/3D/Modules/RFM95W-868S2.step

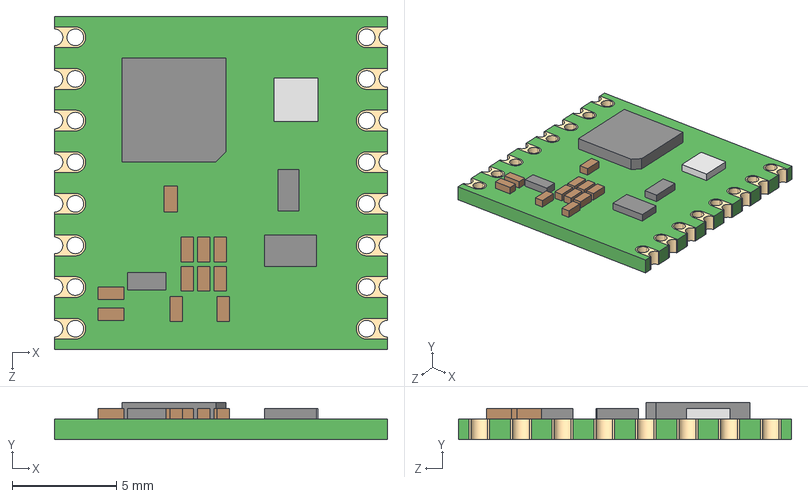
[picture p122: CAD file, 2022-12-28]
3D/Modules/RFM95W-868S2.step
16.0 x 1.80 x 16.0 mm
