ryanstevensmith/SR-Kicad-lib/3D/Package_DFN_QFN/TDFN-4.step

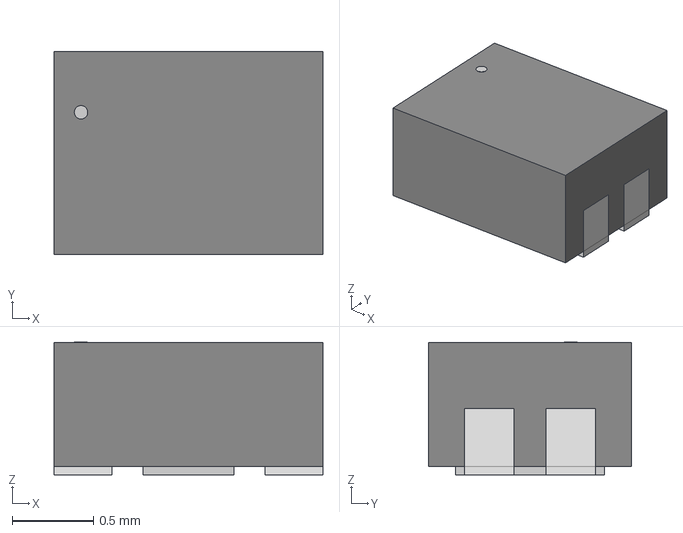
[picture p123: CAD file, 2024-06-04]
3D/Package_DFN_QFN/TDFN-4.step
1.65 x 1.24 x 0.815 mm
