ryanstevensmith/SR-Kicad-lib/3D/Connectors/PHOENIX_1862042.stp

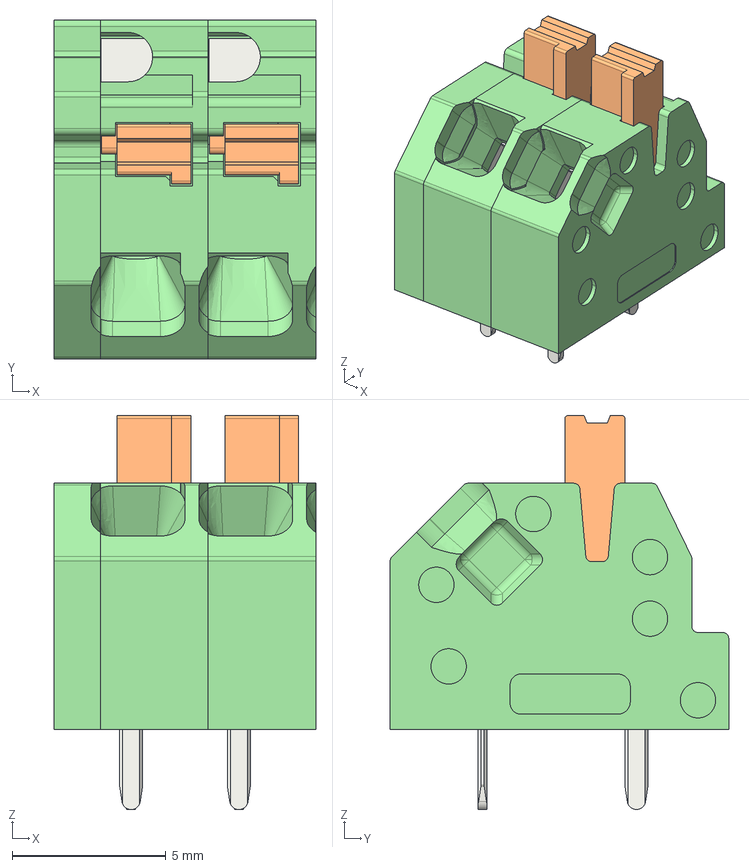
[picture p124: CAD file, 2026-04-07]
3D/Connectors/PHOENIX_1862042.stp
8.50 x 11.0 x 12.8 mm
