ryanstevensmith/SR-Kicad-lib/3D/LED/SK68XX_SIDE.step

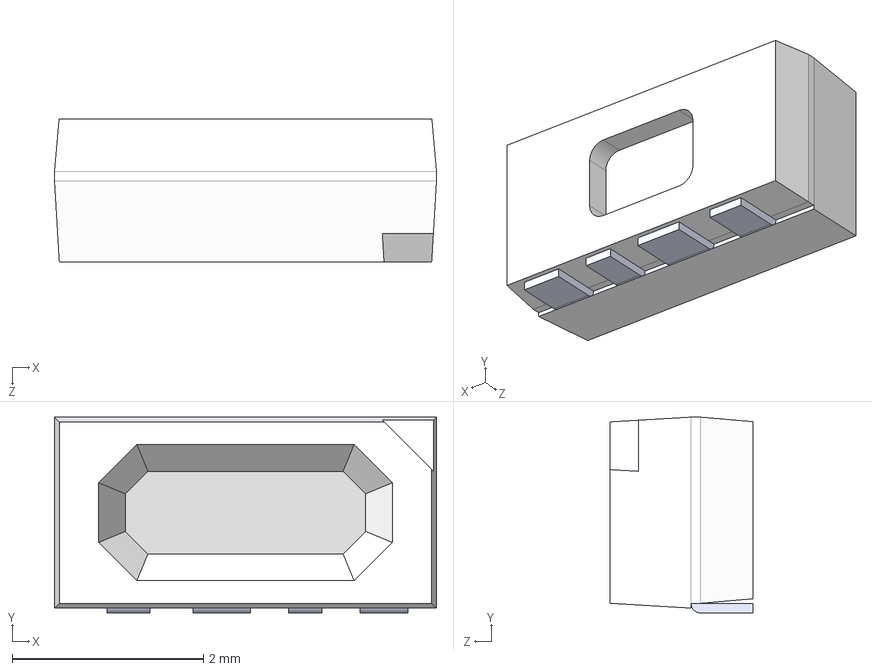
[picture p125: CAD file, 2024-06-04]
3D/LED/SK68XX_SIDE.step
4.00 x 2.05 x 1.50 mm
