ryanstevensmith/SR-Kicad-lib/3D/Package_DFN_QFN/Microchip_DFN-8.step

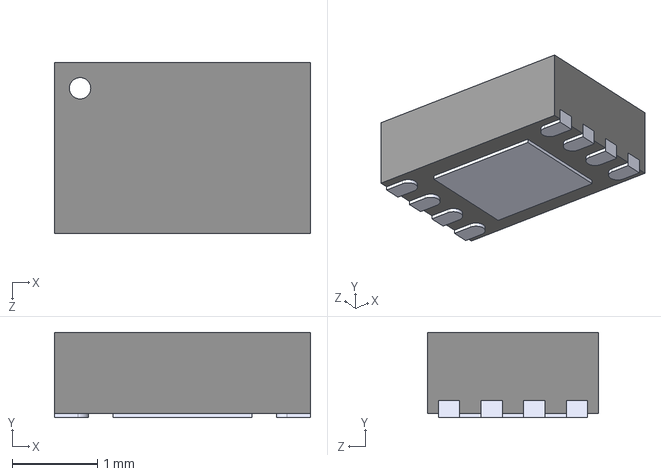
[picture p126: CAD file, 2024-06-04]
3D/Package_DFN_QFN/Microchip_DFN-8.step
3.00 x 1.00 x 2.00 mm
