ryanstevensmith/SR-Kicad-lib/3D/Connectors/BD095-10A-A0-0200-0070-0570-L-B.stp

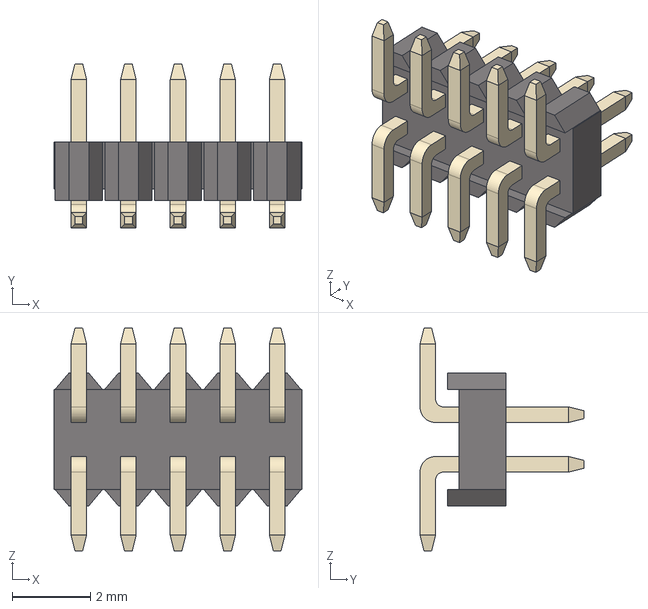
[picture p127: CAD file, 2024-06-04]
3D/Connectors/BD095-10A-A0-0200-0070-0570-L-B.stp
6.35 x 4.20 x 5.70 mm
BG075-10A-A0-0200-0070-0570-L-B_P x 10
BG075-10A-A0-0200-0070-0570-L-B_H
