ryanstevensmith/SR-Kicad-lib/3D/LED/LZ1-00R302-0000.step

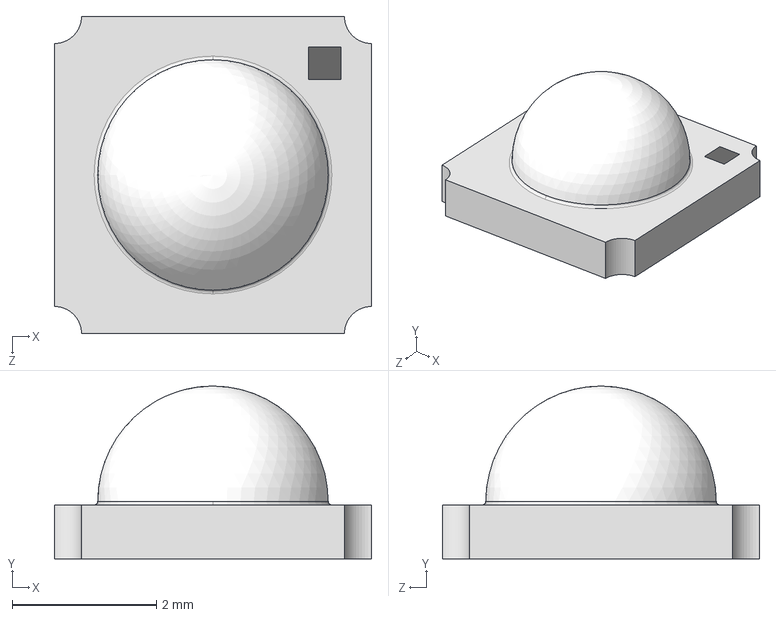
[picture p128: CAD file, 2023-06-09]
3D/LED/LZ1-00R302-0000.step
4.40 x 2.40 x 4.40 mm
