ryanstevensmith/SR-Kicad-lib/3D/Package_DFN_QFN/SGP41-D-R4.step

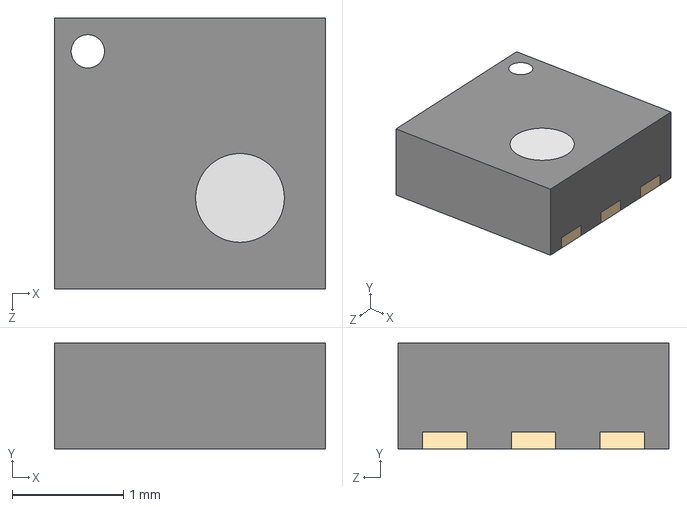
[picture p129: CAD file, 2023-08-29]
3D/Package_DFN_QFN/SGP41-D-R4.step
2.44 x 0.95 x 2.44 mm
