ryanstevensmith/SR-Kicad-lib/3D/Connectors/CONMHF4-SMD-G-T.step

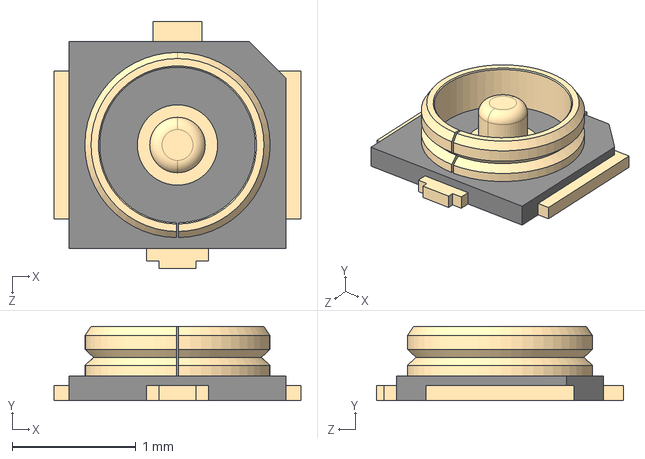
[picture p130: CAD file, 2024-06-04]
3D/Connectors/CONMHF4-SMD-G-T.step
2.00 x 0.6 x 2.00 mm
