ryanstevensmith/SR-Kicad-lib/3D/LED/SMD2835.step

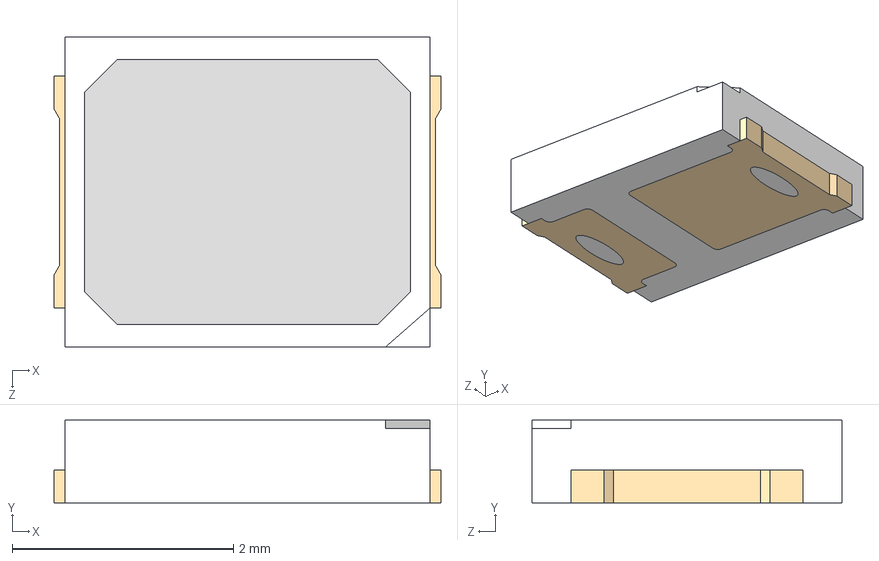
[picture p131: CAD file, 2023-06-09]
3D/LED/SMD2835.step
3.50 x 0.75 x 2.80 mm
