ryanstevensmith/SR-Kicad-lib/3D/Package_DFN_QFN/VFQFN-56-1EP.step

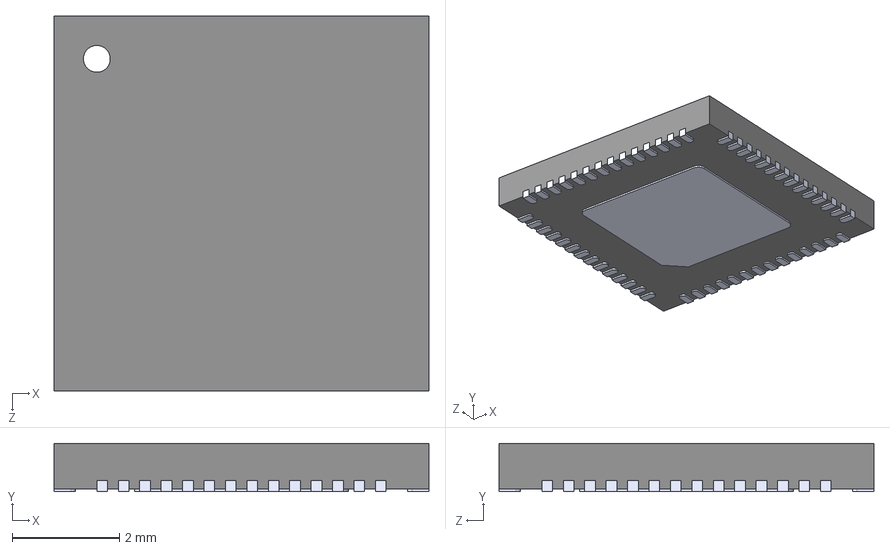
[picture p132: CAD file, 2023-08-29]
3D/Package_DFN_QFN/VFQFN-56-1EP.step
7.00 x 0.9 x 7.00 mm
