ryanstevensmith/SR-Kicad-lib/3D/Connectors/CUI_DEVICES_SJ2-3593D-SMT-TR.step

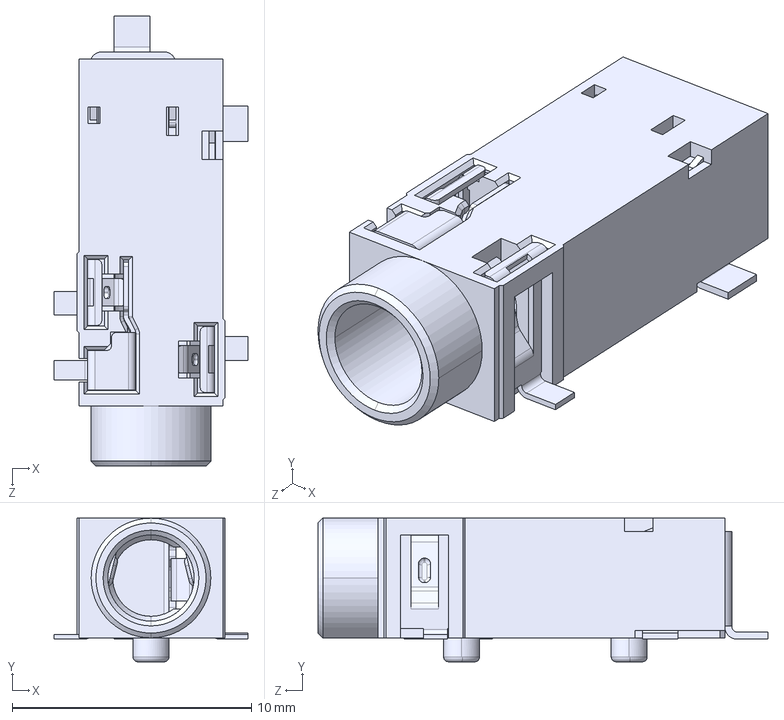
[picture p133: CAD file, 2024-06-04]
3D/Connectors/CUI_DEVICES_SJ2-3593D-SMT-TR.step
8.10 x 6.00 x 18.8 mm
