ryanstevensmith/SR-Kicad-lib/3D/LED/LTST-C195.STEP

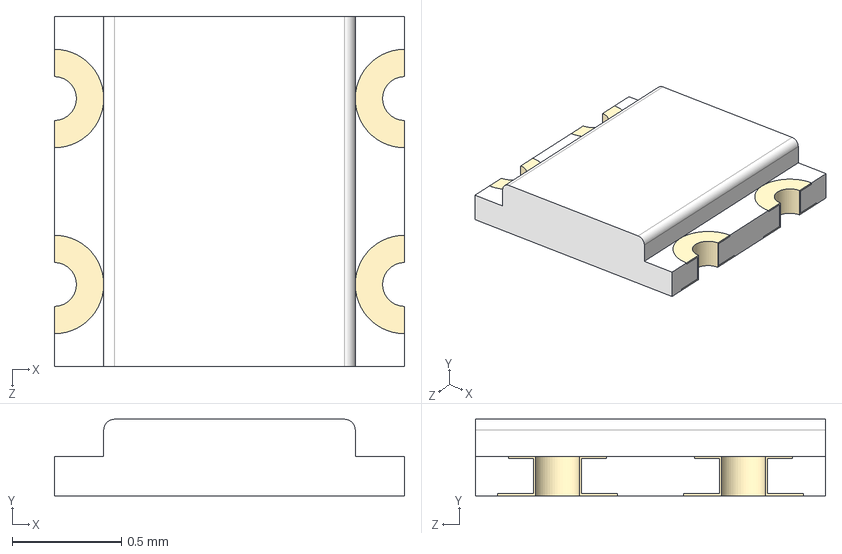
[picture p134: CAD file, 2023-04-03]
3D/LED/LTST-C195.STEP
1.60 x 0.35 x 1.60 mm
