ryanstevensmith/SR-Kicad-lib/3D/Package_DFN_QFN/SHTC3.STEP

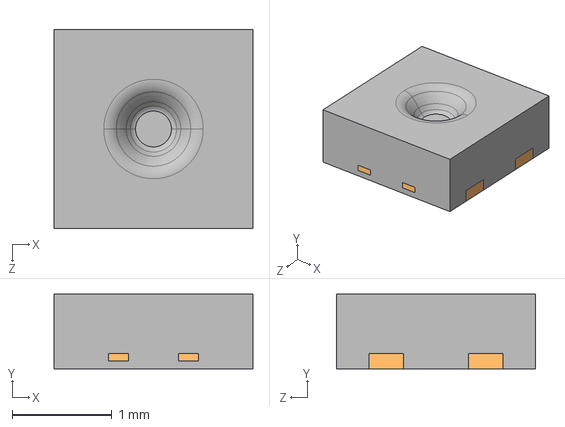
[picture p135: CAD file, 2023-08-29]
3D/Package_DFN_QFN/SHTC3.STEP
2.00 x 0.75 x 2.00 mm
