ryanstevensmith/SR-Kicad-lib/3D/LED/LTR-329ALS-01.stp

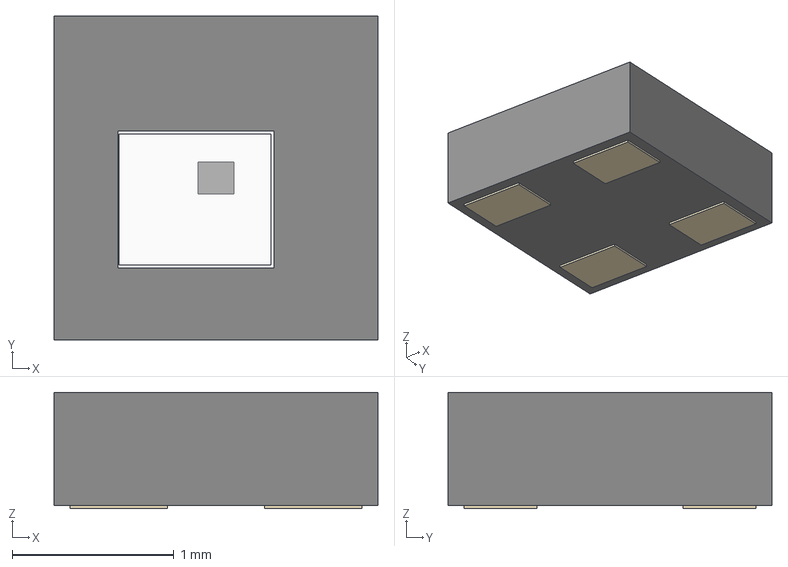
[picture p136: CAD file, 2023-04-03]
3D/LED/LTR-329ALS-01.stp
2.00 x 2.00 x 0.719 mm
