ryanstevensmith/SR-Kicad-lib/3D/Package_DFN_QFN/VQFN_16_3x3.step

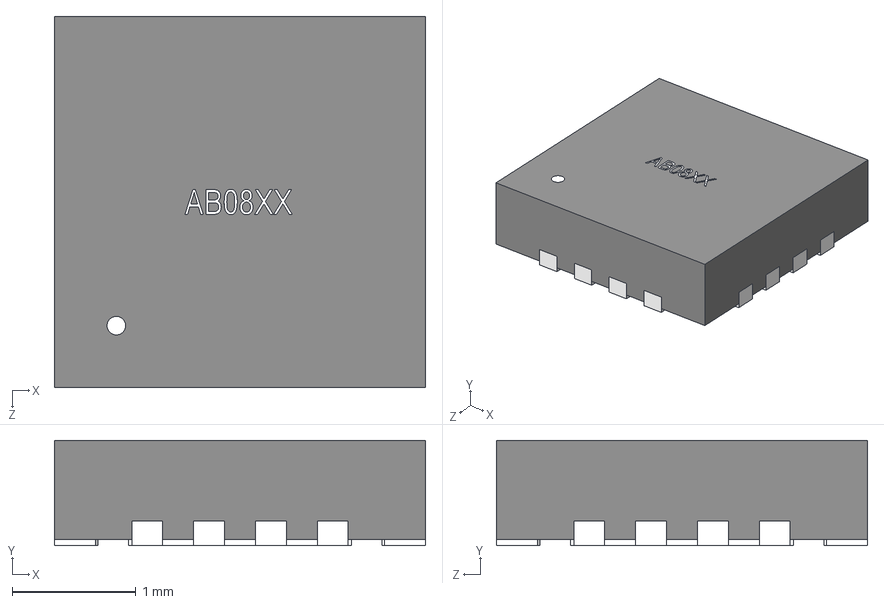
[picture p137: CAD file, 2023-06-09]
3D/Package_DFN_QFN/VQFN_16_3x3.step
3.00 x 0.85 x 3.00 mm
