ryanstevensmith/SR-Kicad-lib/3D/Connectors/USB4730-GF-A_REVA.step

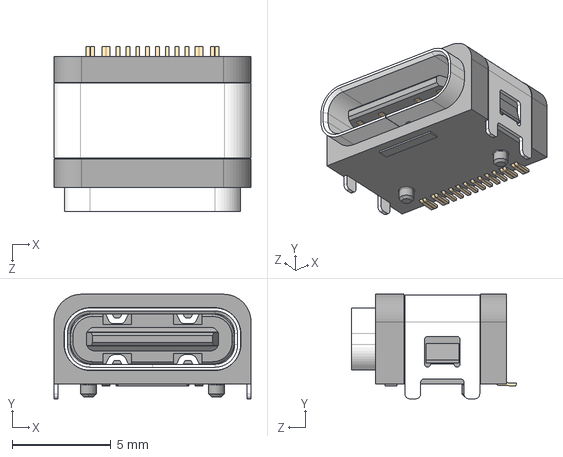
[picture p138: CAD file, 2024-06-04]
3D/Connectors/USB4730-GF-A_REVA.step
10.0 x 5.31 x 8.36 mm
