ryanstevensmith/SR-Kicad-lib/3D/Package_DFN_QFN/QFN_32_5x5.step

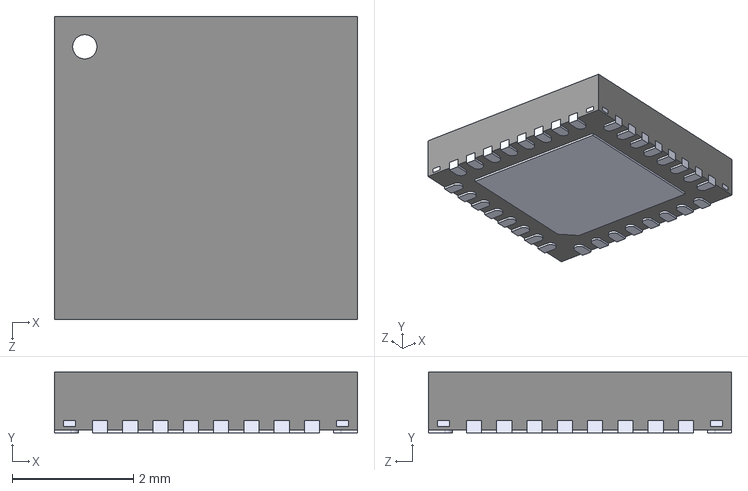
[picture p139: CAD file, 2023-04-03]
3D/Package_DFN_QFN/QFN_32_5x5.step
5.00 x 1.00 x 5.00 mm
