ryanstevensmith/SR-Kicad-lib/3D/Connectors/2060-452_998-404.stp

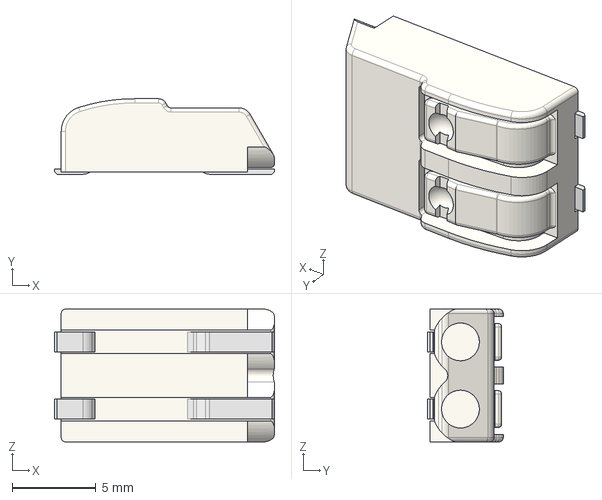
[picture p140: CAD file, 2024-06-04]
3D/Connectors/2060-452_998-404.stp
13.1 x 4.50 x 7.90 mm
