ryanstevensmith/SR-Kicad-lib/3D/Connectors/BD050-10-A-0-0500-L-B.stp

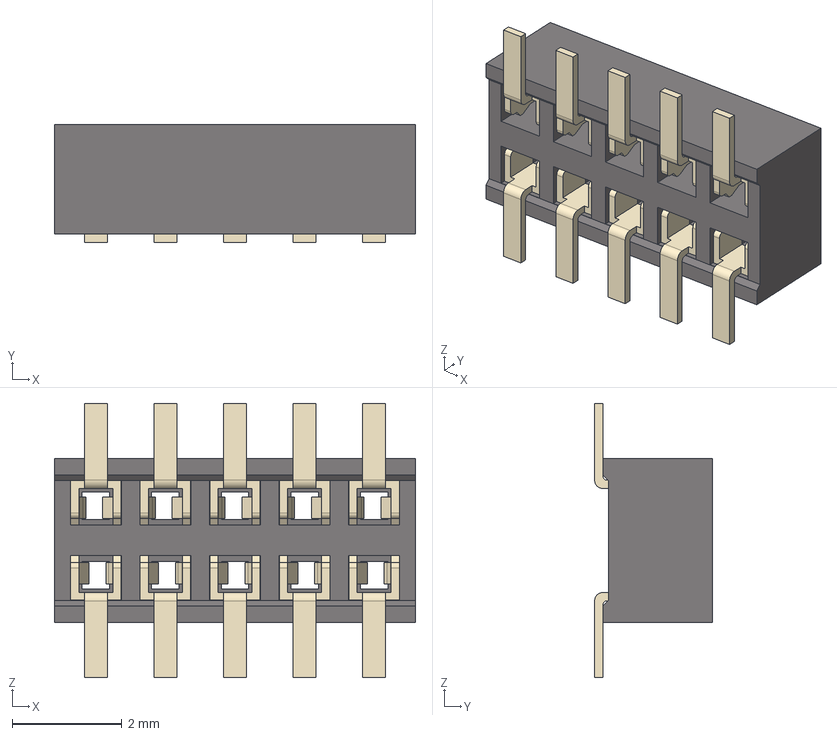
[picture p141: CAD file, 2024-06-04]
3D/Connectors/BD050-10-A-0-0500-L-B.stp
6.59 x 2.15 x 5.01 mm
BD050-10-A-0-0500-L-B_P x 10
BD050-10-A-0-0500-L-B_H
