ryanstevensmith/SR-Kicad-lib/3D/Connectors/2EDGVC-5.08-04P-14-00AH.STEP

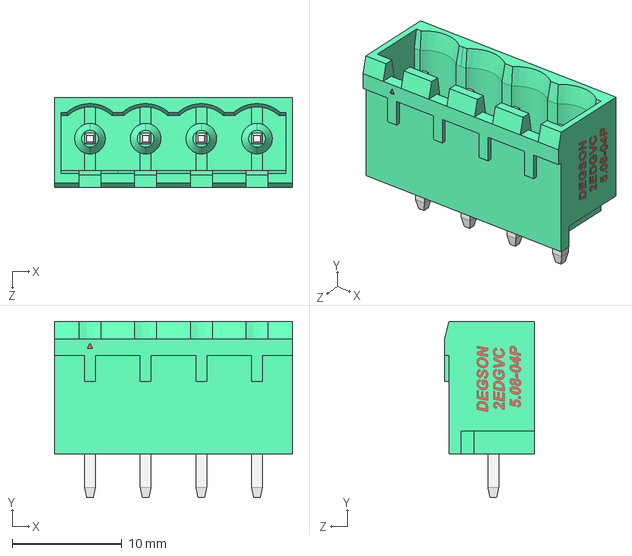
[picture p142: CAD file, 2024-06-04]
3D/Connectors/2EDGVC-5.08-04P-14-00AH.STEP
21.7 x 16.1 x 8.20 mm
