ryanstevensmith/SR-Kicad-lib/3D/Connectors/8-188275-0.step

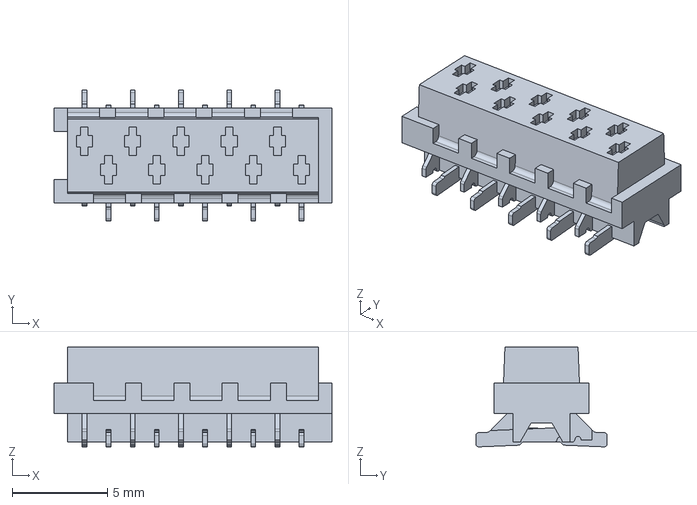
[picture p143: CAD file, 2024-06-04]
3D/Connectors/8-188275-0.step
14.6 x 6.90 x 5.25 mm
