ryanstevensmith/SR-Kicad-lib/3D/Connectors/Molex 47053-1000.STEP

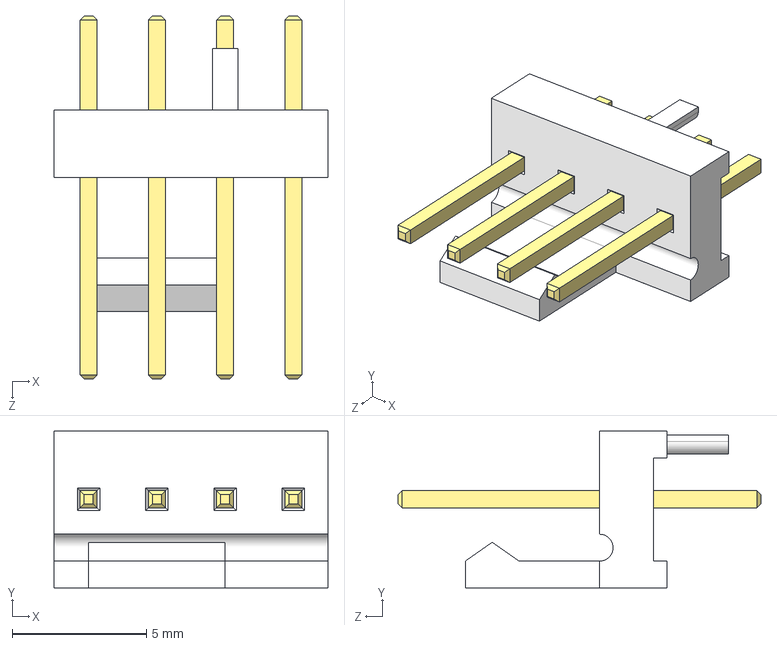
[picture p144: CAD file, 2024-06-04]
3D/Connectors/Molex 47053-1000.STEP
10.2 x 5.84 x 13.5 mm
