ryanstevensmith/SR-Kicad-lib/3D/Connectors/3-641215-4.step

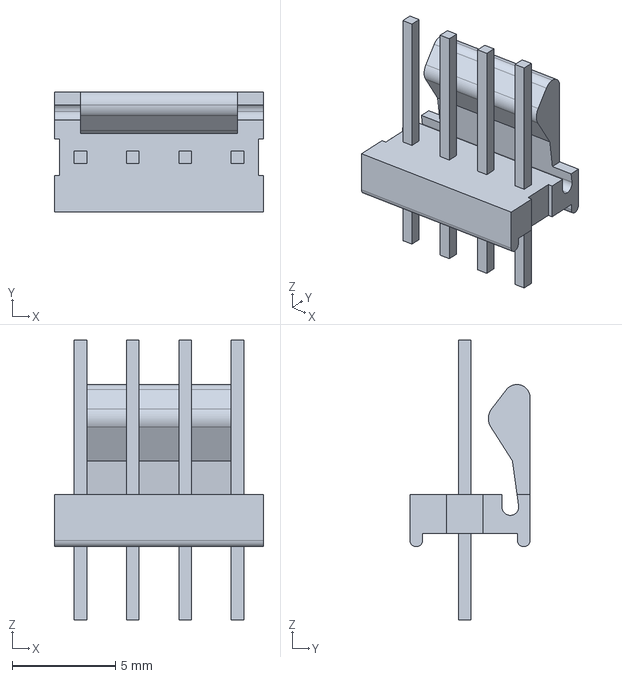
[picture p145: CAD file, 2024-06-04]
3D/Connectors/3-641215-4.step
10.2 x 5.84 x 13.6 mm
