ryanstevensmith/SR-Kicad-lib/3D/Connectors/TYPE-C-31-M-12.step

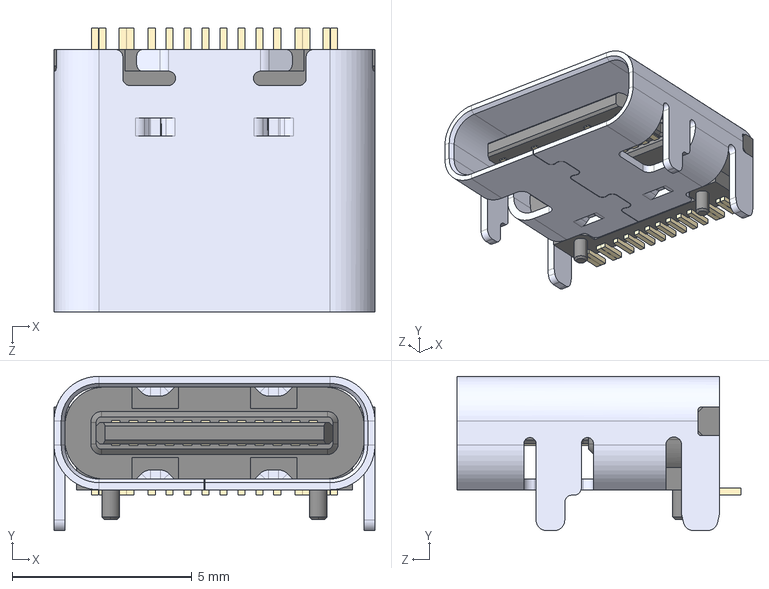
[picture p146: CAD file, 2024-06-04]
3D/Connectors/TYPE-C-31-M-12.step
8.94 x 4.30 x 7.90 mm
