ryanstevensmith/SR-Kicad-lib/3D/Connectors/3-641215-3.step

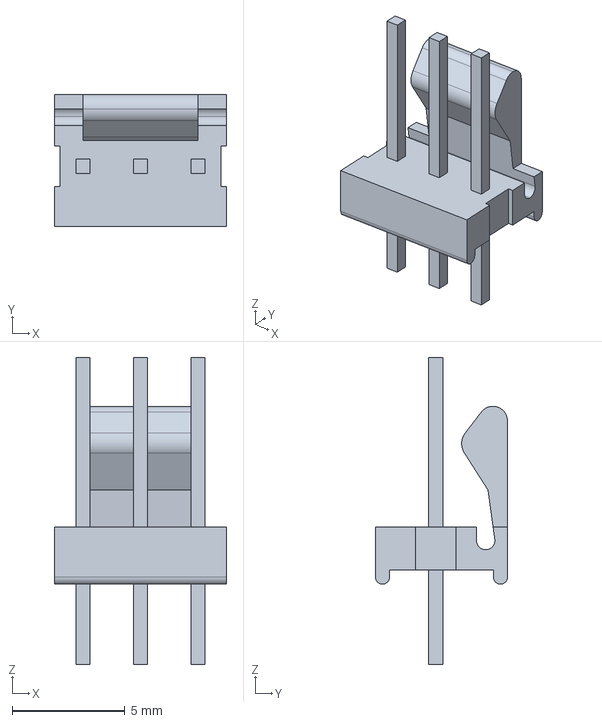
[picture p147: CAD file, 2024-06-04]
3D/Connectors/3-641215-3.step
7.62 x 5.84 x 13.6 mm
