ryanstevensmith/SR-Kicad-lib/3D/Connectors/MEM2061-01-188-00-A_REVA.step

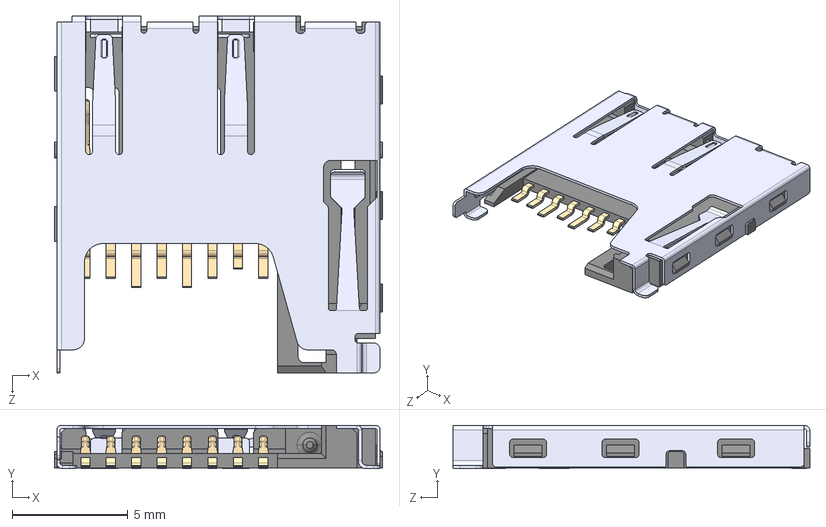
[picture p148: CAD file, 2024-06-04]
3D/Connectors/MEM2061-01-188-00-A_REVA.step
14.2 x 1.88 x 15.4 mm
