ryanstevensmith/SR-Kicad-lib/3D/Connectors/3-641215-2.step

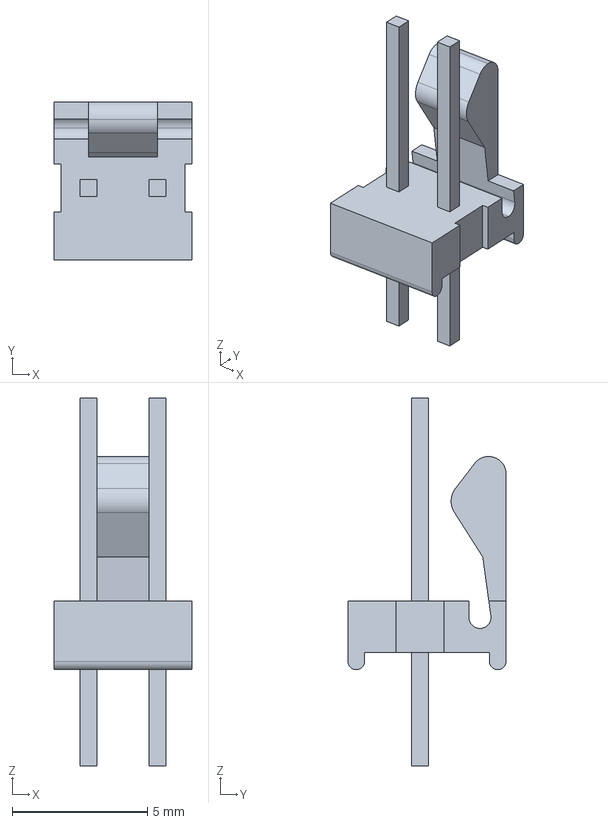
[picture p149: CAD file, 2024-06-04]
3D/Connectors/3-641215-2.step
5.08 x 5.84 x 13.6 mm
