ryanstevensmith/SR-Kicad-lib/3D/Connectors/J1B1211CCD.step

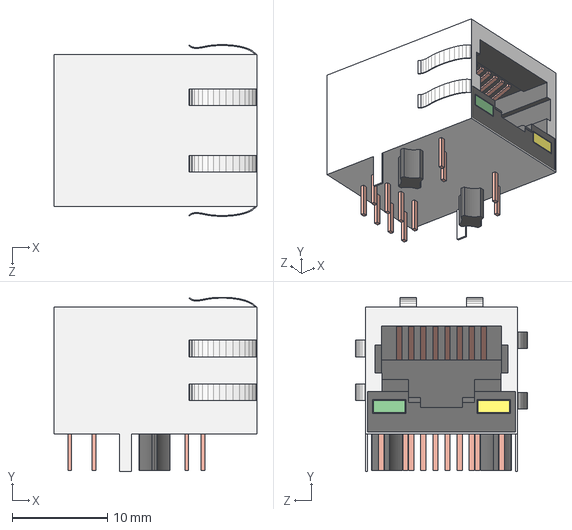
[picture p150: CAD file, 2024-06-04]
3D/Connectors/J1B1211CCD.step
21.3 x 18.3 x 18.0 mm
