ryanstevensmith/SR-Kicad-lib/(list of files, cad)

Other CAD files:
3D/Antenna/1462000001.stp
3D/Antenna/1462000011.stp
3D/Antenna/7488910092 (rev1).stp
3D/Battery/18650.step
3D/Button_Switch/OS102011MS2QN1.step
3D/Connectors/039281023.stp
3D/Connectors/0906-0-15-20-76-14-11-0.step
3D/Connectors/10132328-10011LF.step
3D/Connectors/104224-0820.step
3D/Connectors/1720650004.step
3D/Connectors/2074780004.stp
3D/Connectors/2199119-3.stp
3D/Connectors/46991-4004.stp
3D/Connectors/503398-1892.step
3D/Connectors/5051102091.stp
3D/Connectors/52207-1060.stp
3D/Connectors/53048-0210.step
3D/Connectors/53048-0310.step
3D/Connectors/5650118-3.stp
3D/Connectors/5787834-1.stp
3D/Connectors/629105150521.stp
3D/Connectors/78646-3001.step
3D/Connectors/87583-2010BLF.step
3D/Connectors/BM04B-SRSS-TB.STEP
3D/Connectors/FFC2A32-10-T.stp
3D/Connectors/FFC2A32-20-T.stp
3D/Connectors/FH34SRJ-24S-0.5SH.stp
3D/Connectors/S2B-PH-SM4-TB(LF)(SN).STEP
3D/Connectors/SM04B-SRSS-TB(LF)(SN).STEP
3D/Connectors/SM05B-SRSS-TB(LF)(SN).STEP
3D/Connectors/USB4145-03-0070-C.stp
3D/Inductor/744273222.stp
3D/Inductor/SPM10065VT-6R8M-D.step
3D/Mechanical/153003_QS-1_4-6.stp
3D/Test/YZ188015084P-01.step
3D/Transformer/PT61020EL.STEP
CM4/CM4 Library/Raspberry-Pi-CM4-3D-Models/9774015151R_20_28rev1_29.stp
CM4/CM4 Library/Raspberry-Pi-CM4-3D-Models/9774030151R (rev1).stp
CM5/CM5 Library/Raspberry-Pi-CM5-3D-Models/10164227-1001a1rlf.stp
CM5/CM5 Library/Raspberry-Pi-CM5-3D-Models/10164227-1004a1rlf.stp
CM5/CM5 Library/Raspberry-Pi-CM5-3D-Models/10164228-100pin.stp
CM5/CM5 Library/Raspberry-Pi-CM5-3D-Models/9774015151R_20_28rev1_29.stp
CM5/CM5 Library/Raspberry-Pi-CM5-3D-Models/9774040151R (rev1).stp
