ryanstevensmith/SR-Kicad-lib/(commit log)

2022-12-28 Initial Commit + Modules
    Initial commit and starting the modules library Including:
    - Adafruit FONA
    - Arduino Nano
    - MPM3610 Adafruit module
    - RFM95W 868S2
    - Various RPi Pico footprints
    [Adafruit MPM3610.step, Adafruit-FONA-800-GSM-Breakout.step, DRV887X-carrier.step, RFM95W-868S2.step, SW868-TH13.step]
2023-04-03 Fairly big update
    Fairly big update as board design was sent out. Added a lot of new libraries including
    - Audio
    - Connectors
    - DCDC Converters
    - GSM
    - IMU
    - Motor Driver
    - LED
    - Modules
    - Memory
    - Nixie
    - Power Management
    - Regulators
    - Timers
    [5051102091.stp, 52207-1060.stp, 5650118-3.stp, 629105150521.stp, 744273222.stp, 78646-3001.step, Adafruit MPM3610.step, Adafruit-FONA-800-GSM-Breakout.step]
2023-06-09 Major Update For new user
    Major update for new user
    [039281023.stp, 3201 Ethernet FeatherWing.step, 3405 Adafruit HUZZAH32 ESP32 Feather.step, 46991-4004.stp, 503398-1892.step, Adafruit Ethernet FeatherWing.step, ESP32-S3-MINI-1-N8.step, ESP32-S3-WROOM-1.step]
2023-08-29 Major monthly update Aug 23
    Added many new parts and footprints.
    IMU, LED, Memory, Microcontrollers, Regulator, sensor.
    [14-LGA_2.5x3.step, AS726X.STEP, Crystal SC32S no markings.stp, Crystal_2016.STEP, FFC2A32-10-T.stp, FH34SRJ-24S-0.5SH.stp, KXOB25-02X8F-TR.step, LPS22HBTR.step]
2024-06-04 general update
    Added quite a lot of parts and new libraries. Time when Jeb has been added
    [0906-0-15-20-76-14-11-0.step, 104224-0820.step, 1462000001.stp, 1462000011.stp, 1720650004.step, 18650.step, 2060-452_998-404.stp, 2074780004.stp]
2024-06-23 general update
    [Texas_DRZ0012A.step]
2026-04-07 March Update
    [10132328-10011LF.step, 10164227-1001a1rlf.stp, 10164227-1004a1rlf.stp, 10164228-100pin.stp, 153003_QS-1_4-6.stp, 2199119-3.stp, 2EDGVC-5.08-02P-14-00AH.STEP, 2EDGVC-5.08-03P-14-00AH.STEP]
