ryanstevensmith/SR-Kicad-lib/(notices)

Notices in the files:
3D/Package_DFN_QFN/UQFN-20-1EP_3x3mm_P0.4mm_EP1.85x1.85mm.step:
Copyright (C) 2017, kicad StepUp
This program is free software: you can redistribute it and/or modify
it under the terms of the GNU General Public License as published by
the Free Software Foundation, either version 3 of the License, or
any later version.
itself might be covered by the GNU General Public License.
3D/Package_SOT/SOT-23.step:
This work is licensed under the [Creative Commons CC-BY-SA 4.0 License](https://creativecommons.org/licenses/by-sa/4.0/legalcode),
with the following exception:
To the extent that the creation of electronic designs that use 'Licensed Material' can be considered to be 'Adapted Material',
You are free to use the library data in your own projects without the obligation to share your project files under this or any other license agreement.
3D/Connectors/BD050-10-A-0-0500-L-B.stp:
author */ ('License CC BY-ND 4.0'),
